open-ephys/ephys-test-board/README.md

# General purpose, automated electrophysiology test board
