open-ephys/ephys-test-board/spice/ad5683_unipolar-to-bipolar_1khz-thd.png

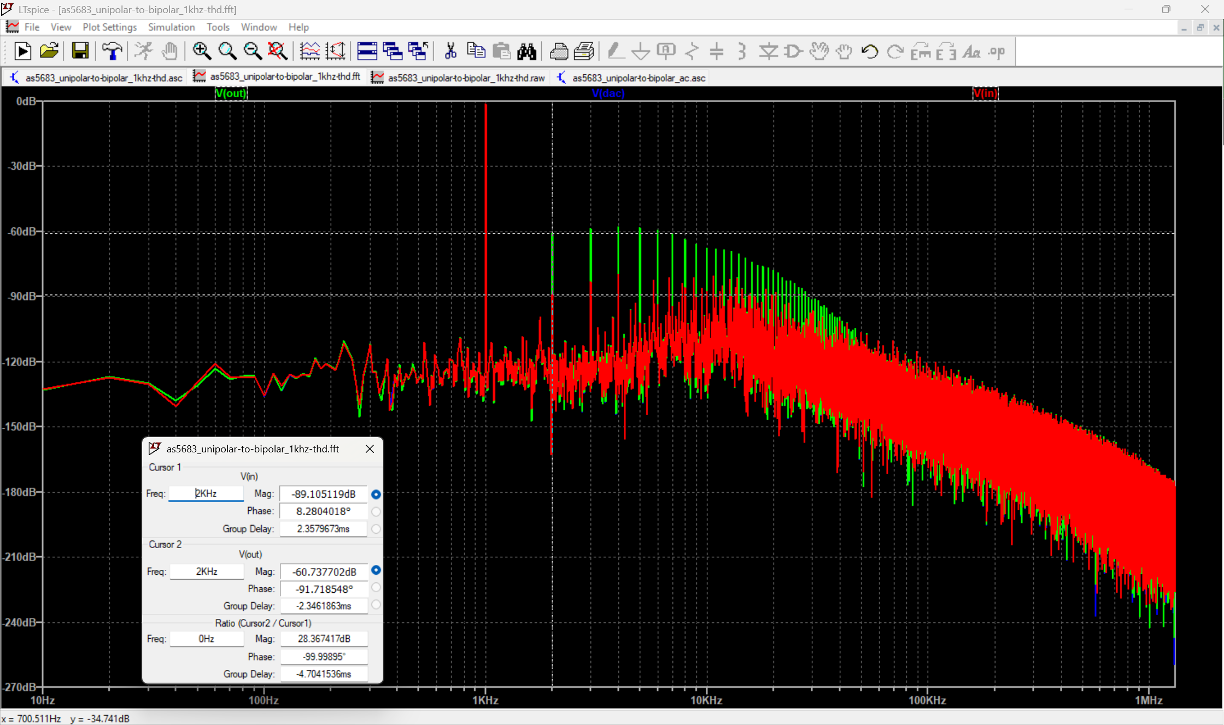
spice/ad5683_unipolar-to-bipolar_1khz-thd.png
