open-ephys/ephys-test-board/spice/ad5683_unipolar-to-bipolar_ac.png

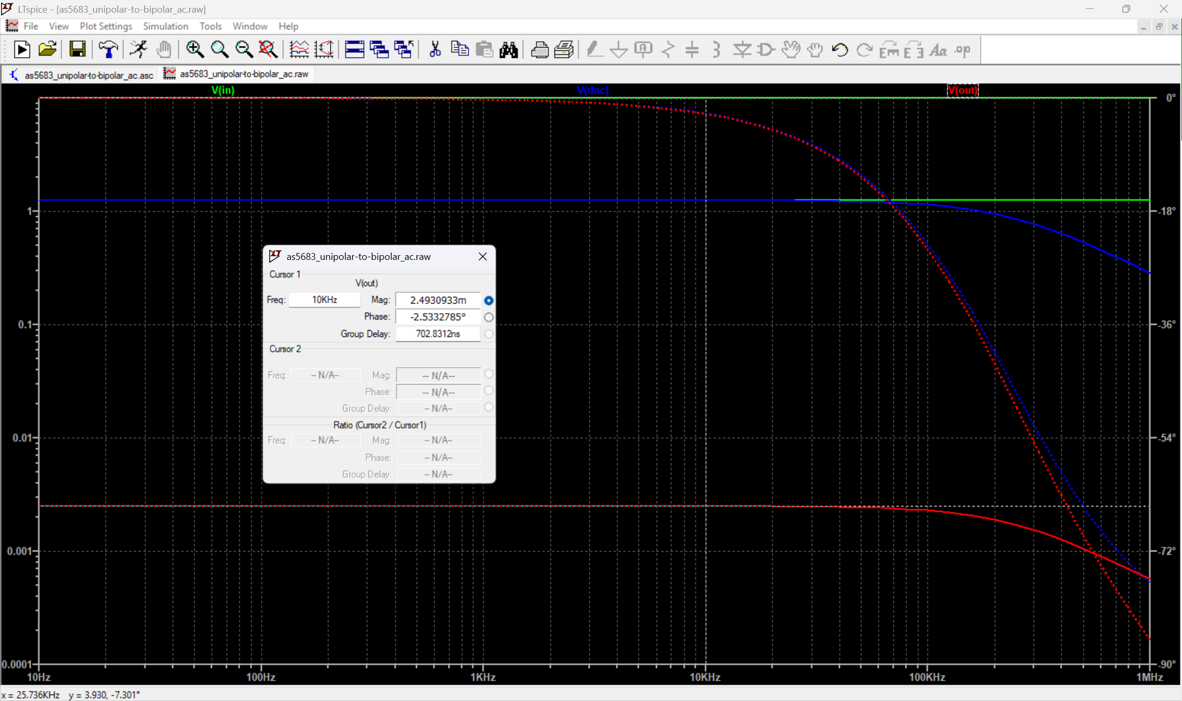
spice/ad5683_unipolar-to-bipolar_ac.png
