open-ephys/ephys-test-board/spice/ad5683_unipolar-to-bipolar_noise.png

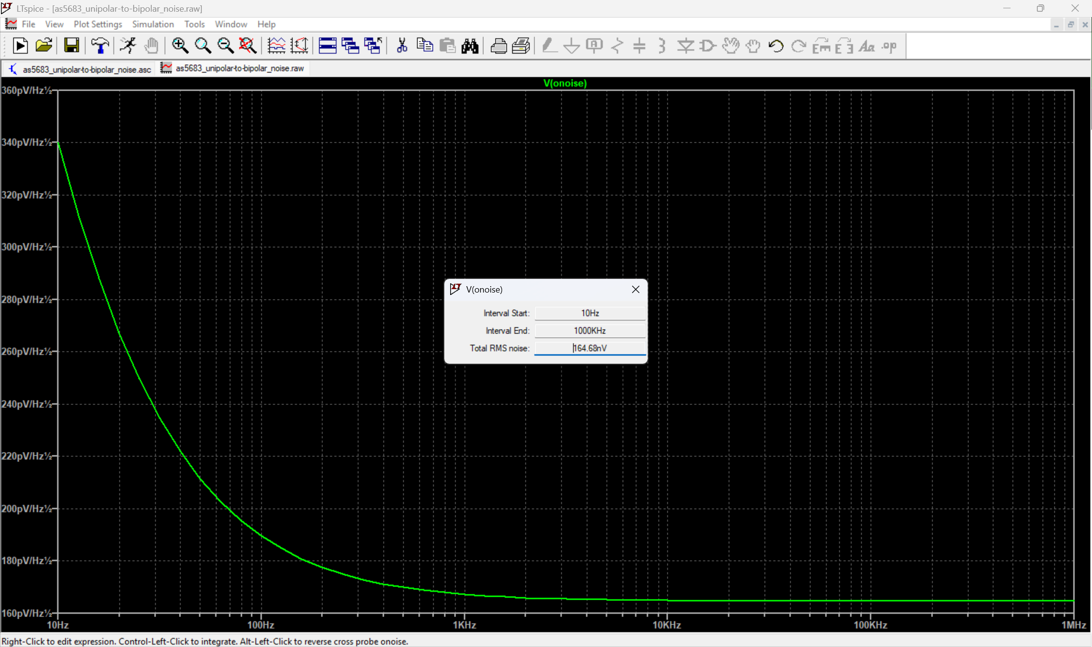
spice/ad5683_unipolar-to-bipolar_noise.png
