open-ephys/ephys-test-board/case/base.SLDPRT

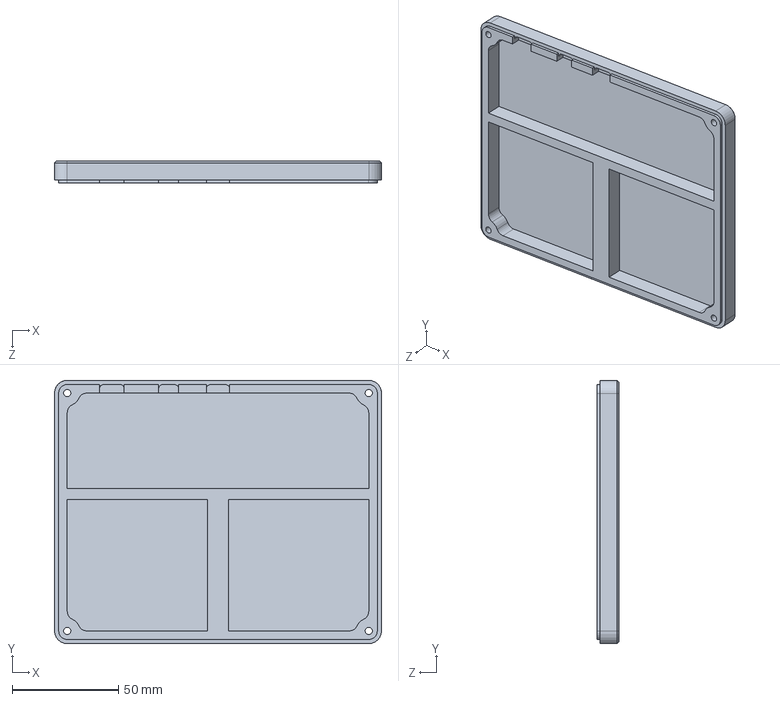
[picture p8: CAD file, 2026-02-26]
case/base.SLDPRT
154.0 x 124.0 x 10.5 mm
