open-ephys/ephys-test-board/case/top.SLDPRT

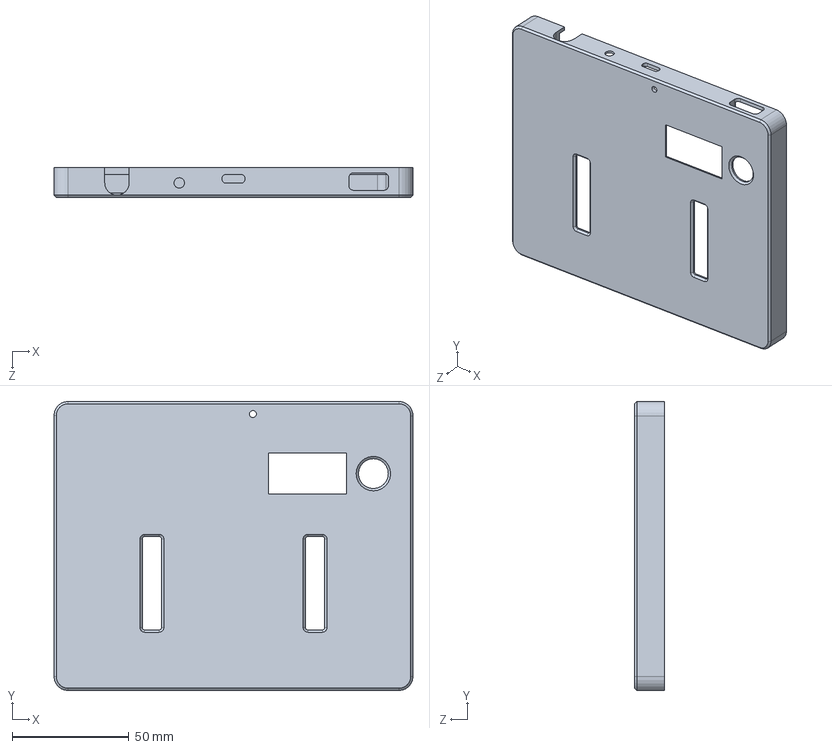
[picture p9: CAD file, 2026-02-26]
case/top.SLDPRT
154.0 x 124.0 x 12.8 mm
