open-ephys/ephys-test-board/case/ACCKMR1316NLT14.stp

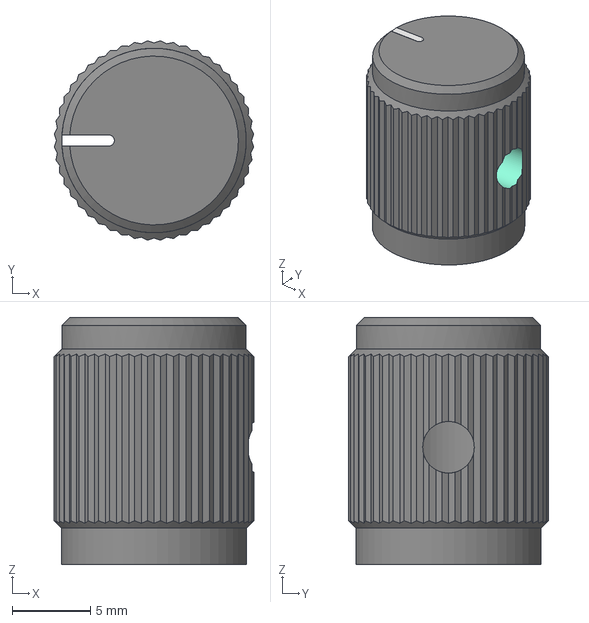
[picture p10: CAD file, 2024-11-14]
case/ACCKMR1316NLT14.stp
12.8 x 12.8 x 15.8 mm
