open-ephys/ephys-test-board/case/92000A116_Passivated 18-8 Stainless Steel Pan Head Phillips Screws.SLDPRT

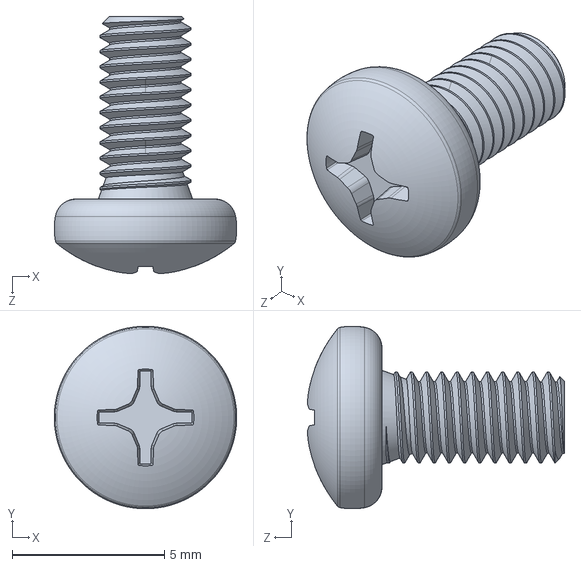
[picture p11: CAD file, 2026-02-26]
case/92000A116_Passivated 18-8 Stainless Steel Pan Head Phillips Screws.SLDPRT
5.99 x 6.00 x 8.45 mm
