open-ephys/ephys-test-board/case/91294A134_Black-Oxide Alloy Steel Hex Drive Flat Head Screw.SLDPRT

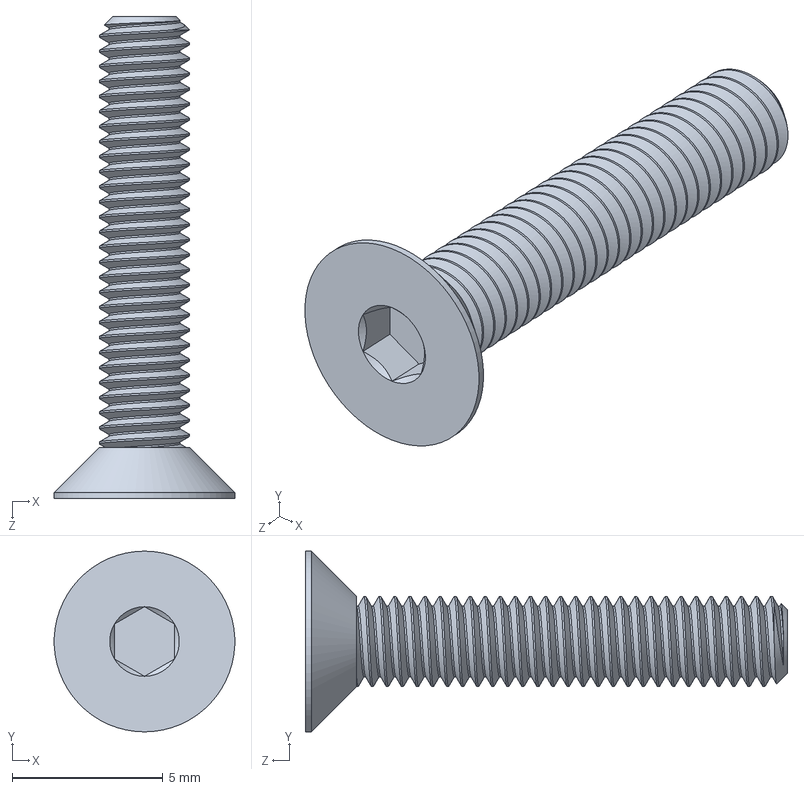
[picture p12: CAD file, 2026-02-26]
case/91294A134_Black-Oxide Alloy Steel Hex Drive Flat Head Screw.SLDPRT
5.99 x 6.00 x 16.0 mm
