open-ephys/ephys-test-board/(list of files, cad)

Other CAD files:
case/stl/base.STL
case/stl/top.STL
case/top-hole-spec.SLDDRW
