open-ephys/ephys-test-board/pcb/how-to-repeat-circuit-motifs-in-kicad/signal-routing_sheet-0.png

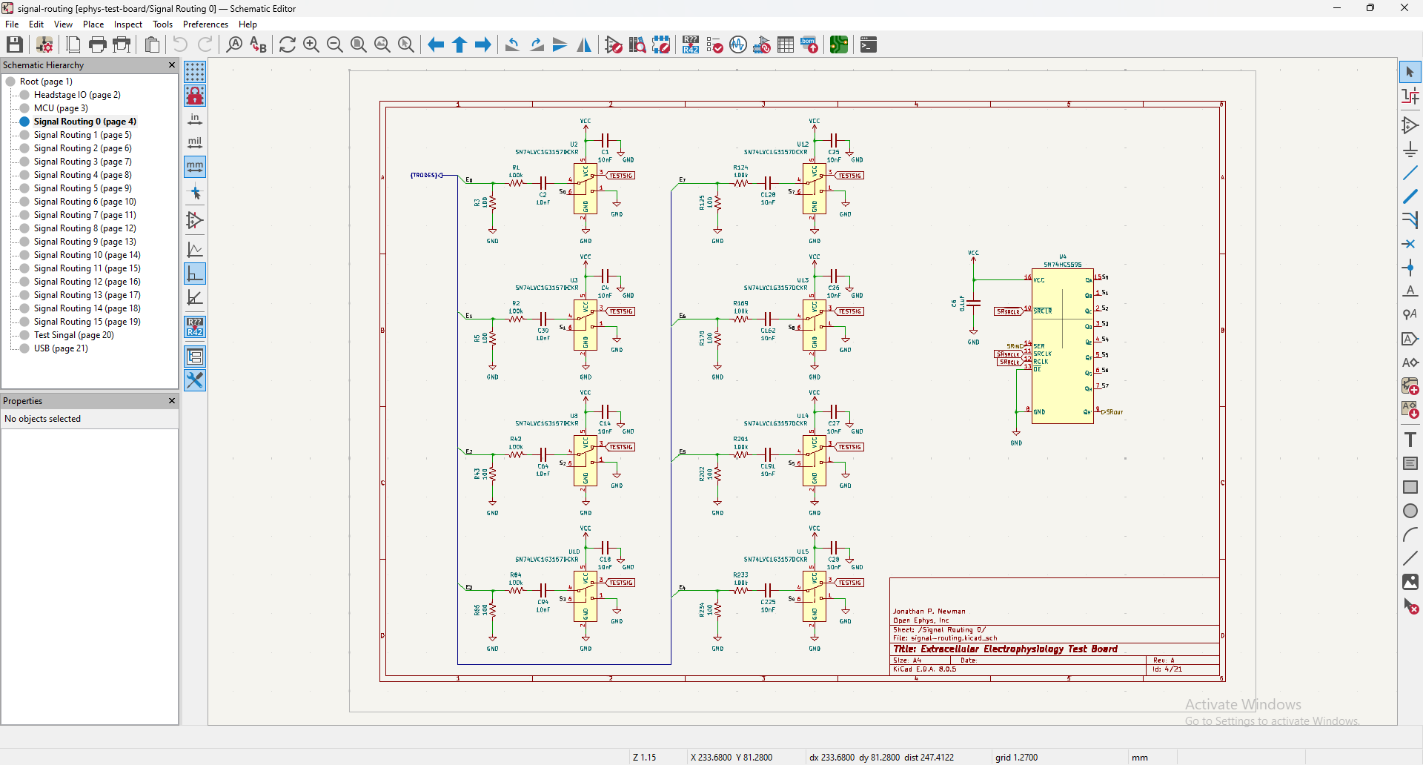
pcb/how-to-repeat-circuit-motifs-in-kicad/signal-routing_sheet-0.png
