open-ephys/ephys-test-board/(threads)

Thread 4 (2024-11-18):

Follow guidelines for MCP73831

jonnew, 2024-11-18:
Page 18 of the [datasheet]() discusses thermals during fast charging of battery. I didn't follow these recommendations for this design.

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

Additionally, the data sheet specifies a required 4.7 uF bypass cap on the VBat pin, which is not currently included in the design.

Closed 2025-02-06.

Thread 6 (2024-12-14):

Reduce weight of CNC enclosure?

cjsha, 2024-12-14:
I appreciate that it won't be tugged around by stiff cables, but the weight might be too much. Not sure how expensive it is to take out that material vs the cost of shipping additional weight (probably not much). Anyway, if you choose to reduce weight, I would leave some material directly underneath the connector so that there is no flex in the PCB when pressure is applied.

Tangentially related but perhaps worth discussing at this point: how should we attribute version/revision to mechanical designs like enclosures? Presumably in the same way we do PCBs.

cjsha, 2024-12-18:
We should mill out material to accommodate the debug header, in case we end up populating it for troubleshooting purposes and end up wanting to put it in a case later, at which point the debug header won't be accessible until the case is removed once again. I add that last clause to clarify that I'm not advocating putting an open slot for the debug header.

Thread 7 (2024-12-14):

Thru-holes for bumpers

cjsha, 2024-12-14:
I propose using bumpers ([example](https://www.mcmaster.com/products/bumpers/bumpers~/unthreaded-hole-bumpers~~/)) for the bottom of the enclosure. You can fasten these using the four mounting holes that are already there.

If we decide to do this, I think it would be better to de-countersink those four mounting holes in the next revision.

Thread 8 (2024-12-17):

Consider USB-C connector with true thru-hole solder joints (not just mating alignment pins)

cjsha, 2024-12-17:

cjsha, 2024-12-17:
This seems to already be fixed in Revision B

cjsha, 2024-12-17:
This was actually fixed in Rev A. I understand now why I thought the USB-C connector didn't have thru-hole solder joints. Those through-hole pads have solder paste in the design:
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
so the stencil lets solder paste fill the thru-hole pads of the USB-C connector. Those holes filled with unmelted solder paste looked like SMD pads to me at which point I created this issue. I'm guessing these USB-C thru-holes must intentionally not have solder paste so that the assembler doesn't have to apply additional solder after applying solder paste with the stencil. This footprint is directly from a KiCAD footprint library.

Closed 2024-12-17.

Thread 9 (2024-12-18):

Battery Status LED flashes momentarily when applying USB power

cjsha, 2024-12-18:
It seems like the battery charger IC allows some current to flow through the battery status LED indicator while the IC is powering on. It seems the IC and LED were wired as suggested by the schematic on the [datasheet](https://ww1.microchip.com/downloads/en/DeviceDoc/20001984g.pdf)'s first page.

Note: this is the behavior when no battery is present. I don't know what it does when the battery is present and if by default these boards are expected to have a battery present. But I would rather not allow rely on a battery being present to achieve a desirable behavior.

jonnew, 2025-01-09:
This is fine and due to battery detection phase as far as I can see. Does not occur when battery is installed.

Closed 2025-01-09.

Thread 11 (2024-12-19):

Ground the case

cjsha, 2024-12-19:

cjsha, 2025-01-06:
The technique mentioned [here](https://github.com/open-ephys/ephys-test-board/issues/12#issuecomment-2571787263) doesn't require this, but depending on grounding technique, we might have to specify a conductive screw type e.g. not black-oxide which are often the cheapest.

There can also be some corrosion when fastening dissimilar metals so we should avoid doing that.

Closed 2025-09-24.

Thread 12 (2024-12-19):

Alleviate the Compression of PCB Between Aluminum Enclosure

cjsha, 2024-12-19:
One way to do this is with an elastic washer.
Another is adding more screws

jonnew, 2025-01-05:
I think that there might be an opportunity for grounding here (#11).

- Put paste layer on the top/bottom of the corner holes, so that there is soft solder layer on both sides
- Add some dimpling/spike features on the top and bottom around the holes.
- Sand these dimples before installation to remove anodization.
- Screw together so that the dimples smash into solder ring

cjsha, 2025-01-06:
That could work. Also, browse this [Digikey page](https://www.digikey.com/en/products/filter/rfi-and-emi-contacts-fingerstock-and-gaskets/945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) for additional ideas.

Closed 2025-04-03.

Thread 13 (2024-12-19):

Enclosure issues

jonnew, 2024-12-19:
- The counterbore for the M3 screw needs to be made bigger in order to comfortably fit the screw head
- The push button has trouble retracting. Not sure what is causing it to catch.
- The debug connector collides with the with the case currently. It can be moved somewhere else.
- The case may actually be _too_ heavy. Consider removing some material.
- Move USB-C connector out by 0.5 mm or make case 0.5 mm thinner.
- Not nearly enough slack in flex cable going to OLED display. Need additional cm.

jonnew, 2025-02-09:
The issue has been broken out into individual issues or completed:

- The counterbore for the M3 screw needs to be made bigger in order to comfortably fit the screw head
  - See #26
- The push button has trouble retracting. Not sure what is causing it to catch.
  - Fixed in #20
- The debug connector collides with the with the case currently. It can be moved somewhere else.
  - Fixed in #20
- The case may actually be too heavy. Consider removing some material.
  - See #6
- Move USB-C connector out by 0.5 mm or make case 0.5 mm thinner.
  - See #25
- Not nearly enough slack in flex cable going to OLED display. Need additional cm.
  - Fixed in #20

Closed 2025-02-09.

Thread 14 (2025-01-05):

Provide a hole in case to access to boot button

jonnew, 2025-01-05:
Can be small so they must use paper clip as it should not be a normal part of use.

jonnew, 2025-03-21:
This is handled via the reset button by linking program against ` pico_bootsel_via_double_reset`

Closed 2025-03-21.

Thread 16 (2025-01-09):

Switch spring is too weak

jonnew, 2025-01-09:
The spring on the currently selected power switch (LC2251EENP) is too weak for the switch and it often gets stuck. I would fine a different part.

Closed 2025-02-06.

Thread 17 (2025-01-10):

OLED Issues

jonnew, 2025-01-10:
The OLED display (part number: MCOT128032CY-WS) has the following pinout:

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

note that this is looking through the FPC, a fact that was not clear until i had it in my hand. This means that pin one is in the bottom right. The connector on the board, of course, has pin 1 starting at the top right of the connector. So pins 1 to 15 on the connector seem to be mapped to 15 down to 1 on the FPC.

In addition to this, the screen is also:

1. Too small. A better alternative, since we are using bare OLED anyway, is [this one](https://www.adafruit.com/product/5228) from Adafruit, especially since there is a nice reference design since the datasheet is pretty bad: https://learn.adafruit.com/adafruit-macropad-rp2040/downloads
2. Awkwardly placed. It would be better to have both the rotary knob and screen at the base on the board, where the user will access with the headstage module plugged in behind that. This is minor enough that I might ignore it though.

Closed 2025-02-06.

Thread 19 (2025-01-11):

Add  !RESET button

jonnew, 2025-01-11:
I want to add a !RESET button to the design.

- If we don't use, its a DNP part and therefore adds no cost
- !RESET can be used to enter BOOT mode without power down by pressing 2x if the firmware that is already on the board is it is linked with the `pico_bootsel_via_double_reset` library. See: https://github.com/raspberrypi/pico-examples/blob/master/system/hello_double_tap/hello_double_tap.c

Closed 2025-02-06.

Thread 22 (2025-02-08):

Pullup resistors on headstage IO I2C bus should be on the module side

jonnew, 2025-02-08:
These resistor (R284 and R285 on current schematic) should be replaced by weak pull downs. This will allow the board to know when a module is inserted and removed. You can use 100k resistors since they are already on the design.

jonnew, 2025-02-09:
Rather than go this route, I wo;; marl the i2c pullups as DNP and add a second, dedicated `Detect` signal that can be pulled down by the module to assert its presence.

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

Closed 2025-03-20.

Thread 25 (2025-02-09):

Move USB-C connector out by 0.5 mm or make case 0.5 mm thinner

jonnew, 2025-02-09:
Currently, a USB cable _just barely_ completely mates before its plastic shell touches the case. There is essentially zero tolerance. Therefore  we need to move USB-C connector out by ~0.5 mm or make case 0.5 mm thinner.

- If this is fixed on the PCB by moving the USB-C connector, it will need to be done in revision C.
- If the case is made thinner without moving the connector, it can be done on Revision B.

Since we are interested in reducing the the weight of the enclosure (#6), I think I prefer not moving this part and just thinning the walls by at least 0.5 mm. For this reason this is currently assigned to Rev. B milestone.

Closed 2025-03-21.

Thread 27 (2025-02-09):

Move SW4 closer to PCB edge

jonnew, 2025-02-09:
The footprint and 3D model used refers to the 8.3 mm length actuator whereas the part number specifies 5.3mm. The land pattern is fine. We want to use 5.8 because it will stick out the back of the case less (this is a reset switch and should not be pressed regularly) and is more common. To accommodate, we need to move the switch closer to the PBC edge.

Closed 2025-03-20.

Thread 29 (2025-02-28):

The OLED's flex connector pin ordering is mirrored

jonnew, 2025-02-28:
The pinout given on the OLEDs datasheet is mirrored compared to that on the Hirose connector.

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

So, the symbol on the schematic needs to be mirrored and the board rerouted to account for the change in connectivity. This is an picture of the symbol in the correct orientation:

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

Closed 2025-03-20.

Thread 30 (2025-03-02):

Reduce electrode test signal input attenuation

jonnew, 2025-03-02:
The DAC can produce 0-2.5V at its output. With the current attenuation of -80 dBV,  this maps 16-bits of resolution over [0 to 250 uV] which is is too low. Attenuation should be reduced to either:

* -60 dBV (1/1000; 0 to 2.5 mV) . Requires 100 ohm resistors to be replaced with 1k 1%.
* -54 dbV (1/500; 0 to 5 mV). Requires 100 ohm resistors to be replaced with 2k 1%.

Thread 31 (2025-03-15):

Bandwidth of electrode input circuit

jonnew, 2025-03-15:
The AC-coupling capacitor following each analog switch along with the attenuation network make an aggressive high pass filter that attenuates frequencies below 100 Hz. The AC coupling capacitor should be moved after the resistor divider to prevent this:

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

jonnew, 2025-03-19:
I confirmed this fix with bodge on rev. B

Closed 2025-03-20.

Thread 34 (2025-03-22):

Different battery dimension for mass production

filcarv, 2025-03-22:
The battery used is Adafruit's [Product ID: 258 ](https://www.adafruit.com/product/258) which has these dimensions: **34mm** x **62mm** x **5mm**. This battery is out of stock.

We found a reliable and deterministic distributor for the Akyga Battery model LP623255, which has slightly different dimensions (**33mm** x **57.5mm** x **6.7mm**). Can we use this battery?

jonnew, 2025-03-26:
Probably. I will need to make the bottom cavity deeper.

jonnew, 2025-03-29:
This battery is fine in terms of its electrical characteristics, but the connector it uses is wire to wire only, as far as I can tell. That means you would need to solder some wire component into the board. I would much prefer using a battery with a connector that can mate to a connector on the board (like the current one). Can you please find another option?

jonnew, 2025-04-03:
Its fine, thanks for the insight. If i was to design again IO might put a cutout for one of these, but they are too large for the current design.

I think the solution is to;

1. Leave the current connection
2. Put some direct solder pads next to it for a direct soldered connection or to put a mating cable on.

Thread 35 (2025-03-22):

Recessed space for label in the case

filcarv, 2025-03-22:
Open Ephys products use a label of 30mm x 50mm with the Open Ephys logo, the SKU, and some legally required information.

Is it possible to add a recessed space somewhere in the case 0.5mm deep and 31mm x 51mm in size? This will be used to add the label.

jonnew, 2025-03-26:
yes should be doable. We should also put some labels on the case, (e.g. on/off), signal input etc. How do you want to do that?

jonnew, 2025-04-01:
A sticker with manufacturing information will go in a recessed position on the bottom of the device. The top should have a printed layer (or laser engraved if the case is made from milled aluminum) with something like the following:

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

- The 30x50 mm recess is now added to the bottom of the case.
- The above design is included in top-silk.pdf.

Closed 2025-04-03.

Thread 36 (2025-03-22):

Low battery detection

filcarv, 2025-03-22:
The device is running from an internal battery, which brings big advantages. We need to make sure that we don't operate the device below the internal nominal voltages,

The devices uses 3.3V from the LDO [AP2112K-3.3TRG1](https://www.diodes.com/assets/Datasheets/AP2112.pdf). The dropout will be below 200mV for sure and since we are being powered from a battery, we might not even consider any noise. Nevertheless, when charging at low voltages, the supply will be noisy and the circuit will suffer for this if working below the LDO's drop out value.

A circuit that shuts down the device when the battery is below a certain voltage may be a good idea. I would suggest using 3.5V has the threshold to shut down the device.

jonnew, 2025-03-25:
Although this is already implemented, the over discharge threshold voltage is indeed too low to be useful (2.8V). We should have a comparator with 3.5V reference to drive enable pin on the LDO.

Closed 2025-04-03.

Thread 37 (2025-03-26):

Case issues

jonnew, 2025-03-26:
- J1 is too tall and rams into case if installed. Its marked DNP and is for debugging though.
- There is not an appropriate cutout for SW4 and its body rams the back of case

Closed 2025-04-03.

Thread 40 (2025-05-13):

Increase screw length

filcarv, 2025-05-13:
We need longer srews for a stable mechanical connection between the top and bottom parts.

- The 92125A132 is 12 mm long.
- Only screws 2.7 mm inside the bottom case.
- We still have 7.0 mm available to screw.

I recommend to replace by a screw with a bigger length by (7 - 2.7 = 4.3) 3.5 or 3 mm, i.e., find a screw with a length of 15.5 or 15 mm.

Closed 2025-05-21.

Thread 41 (2025-06-04):

Full discharge test

jonnew, 2025-06-04:
Because this circuit includes an battery 2.8V under-voltage lockout for charging, there is a possibility of getting the system to a state where no charging can occur if the threshold for protection on the battery is above this level.

Lets say the battery has a under voltage threshold of 3.0V with some hysteresis.

1. Discharge the battery to 3V, the system shuts off and the battery's protection disconnects the anode.
2. Plug in USB to charge, the built in protection senses ~0V at the batteries terminal and therefore the charge circuit is disconnected.
3. The system sits at this equilibrium, non-functional point for eternity

We need to perform a discharge test to ensure this does not happen with our circuit and battery selection.

jonnew, 2025-06-04:
According to @filcarv , its going to be very unpractical to use batteries without internal protection. Thus, the board-level protection circuit should likely be remove and the batteries anode sent to ground.

Thread 42 (2025-06-27):

Firmware feedback from production team

jonnew, 2025-06-27:
- The cycle between channels is too fast. Can you make it 1s for each channel?
- Change the frequency default of the sinewave to 1000 Hz instead of 100 Hz.

jonnew, 2025-07-03:
Fixed in #43

Thread 44 (2025-07-03):

Specify EEPROM data layout

jonnew, 2025-07-03:
We need to document the layout for channel map EEPROM data. Currently, this is the layout:

| ID | Address Range | Description |
| --- | ----------- | --------- |
| MAGIC | 0x00 - 0x09| The ascii character string `"open-ephys"`
| NAME | 0x0A - 0x1D | ASCII character string specifying the name of the modules, padded out to 20 chars. e.g. `"Hirose DF40 64 Ch.  "`[^1]
| PCB_REV | 0x1E | Single ASCII character indicating indicating PCB revision. e.g. `'A'`
| NUM_CHAN | 0x1F| Single `uint8_t` specifying the number of channels in the channel map
| CHAN_MAP | 0x20 - 0x20 + NUM_CHAN| A `uint8_t[NUM_CHAN]` containing the channel map

I propose the following, revised layout:

| ID | Address Range | Description |
| --- | ----------- | --------- |
| MAGIC | 0x0000 - 0x0009| The ascii character string `"open-ephys"`
| NAME | 0x000A - 0x001D | ASCII character string specifying the name of the modules, padded out to 20 chars. e.g. `"Hirose DF40 64 Ch.  "`
| PCB_REV | 0x001E | Single ASCII character indicating indicating PCB revision. e.g. `'A'`
| LAOUT_VER | 0x001F-0x0020 | Major.Minor version number of the EEPROM layout (e.g. this specification will be 1.0)
| NUM_MAPS | 0x0021 | A single `uint8_t` specifying the number of maps
| RESERVED | 0x022-0x03FF| Reserved
...
| NUM_CHAN_0| 0x0400 | Single `uint8_t` specifying the number of channels in channel map 0[^2]
| CHAN_MAP_0 | 0x0401 - 0x0400 + NUM_CHAN_0| A `uint8_t[NUM_CHAN_0]` containing  channel map 0
...
| NUM_CHAN_1| 0x0800| Single `uint8_t` specifying the number of channels in channel map 1[^2]
| CHAN_MAP_1 | 0x0801 - 0x0800 + NUM_CHAN_1| A `uint8_t[NUM_CHAN_1]` containing channel map 1
...
| NUM_CHAN_<NUM_MAPS - 1> | 0x0400 * (NUM_MAPS - 1)| Single `uint8_t` specifying the number of channels in channel map NUM_MAPS - 1[^2]
| CHAN_MAP_<NUM_MAPS - 1> | 0x0400 * (NUM_MAPS - 1) + 1 - 0x0400 * (NUM_MAPS - 1) + NUM_CHAN_<NUM_MAPS - 1> | A `uint8_t[NUM_CHAN_<NUM_MAPS - 1>]` containing channel map NUM_MAPS - 1

[^1]: Limited to 20 chars to force the text to fit in the screen
[^2]: Must be 128 or less for this hardware, so this will fit into single byte.

@filcarv and @aacuevas if you have additional ideas, corrections, or comments please document them here.

jonnew, 2025-07-04:
Thanks for the feedback. @aacuevas I edited the table to account for your comment. @filcarv 8kB EEPROM will be able to hold 1 metadata block and 7 channel maps as each section takes 1 kB.

Thread 46 (2025-07-04):

Somehow, let the user know in the screen that the battery needs to be recharged

filcarv, 2025-07-04:
In order to do so, we need to read the battery level via a microcontroller ADC input. A resistor divider can bring the battery voltage down to the ADC range.

Closed 2025-07-11.

Thread 56 (2025-09-25):

OLED Charging Lightning Indicator Remains After Disconnecting Charging USB

cjsha, 2025-09-25:
If I turn on the ephys test board while the USB is plugged in, the OLED correctly indicates that it's charging. If I unplug the USB from ephys test board while it's on, the lightning symbol in the OLED stays instead of reverting to the battery symbol.

jonnew, 2025-09-26:
I think this might only apply to the initial menu when the user is selecting a channel map. I can reproduce in that case. I will look into a fix for that because I understand it. If its occurring outside of this situation, Ill need a more complete description of when its happening because I cannot reproduce.
