open-ephys/ephys-test-board/pcb/ephys-test-board.pdf

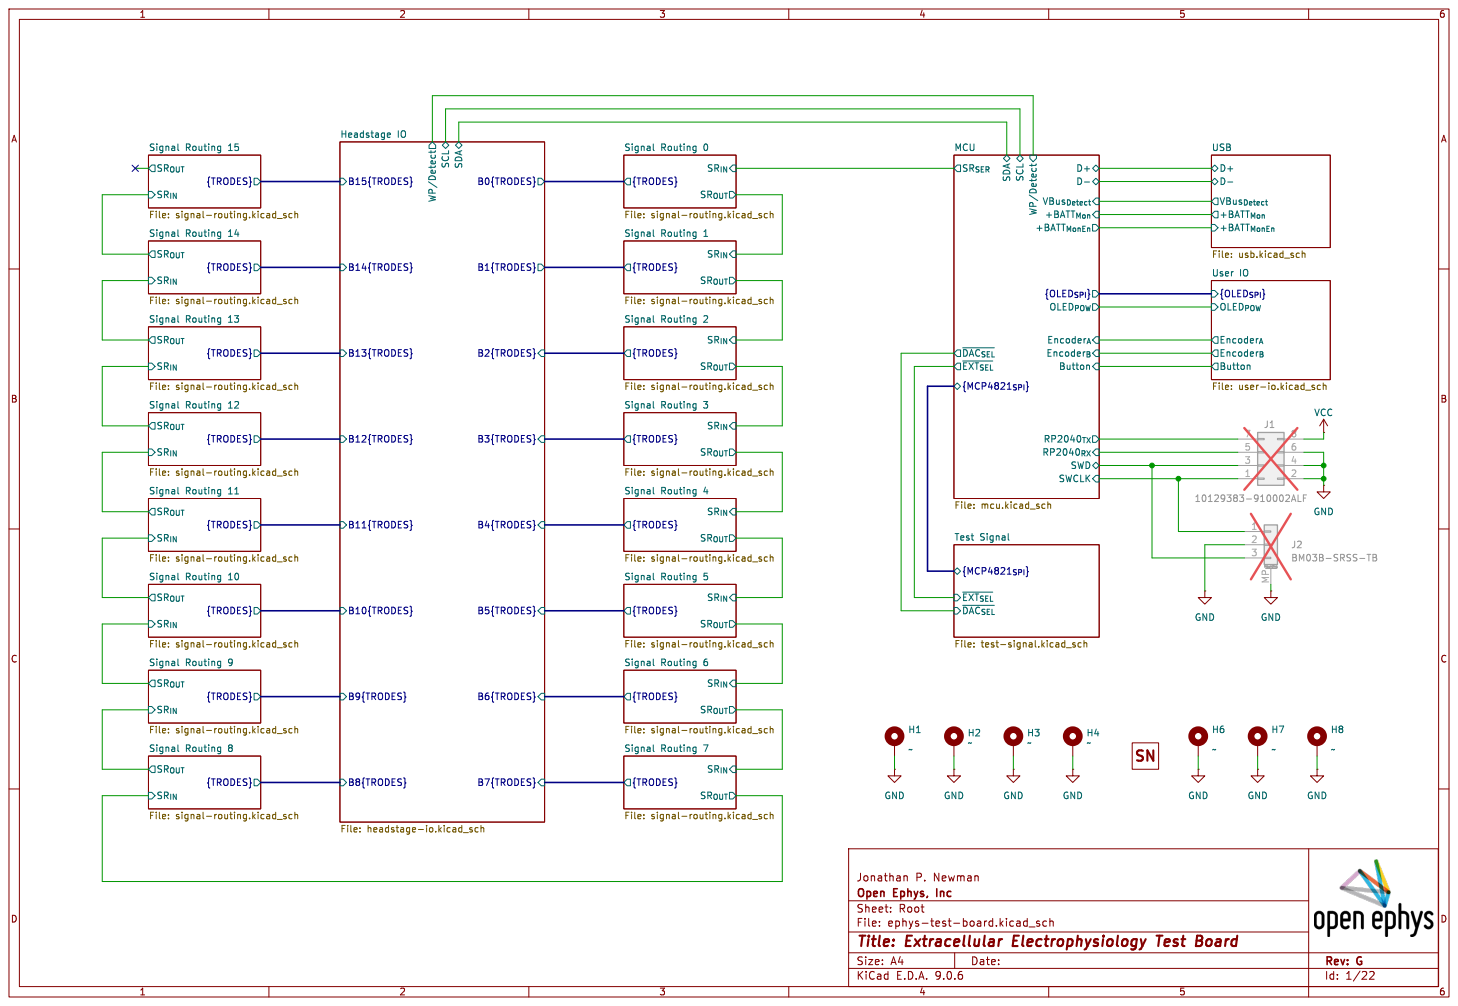
[picture p21: page 1]

Signal Routing 15 File: signal-routing.kicad_sch

Signal Routing 0 File: signal-routing.kicad_sch

+BATT_{MonEn} MCU
{OLED_{SPI}} Button VBus_{Detect} SDA SCL

Signal Routing 14 File: signal-routing.kicad_sch

Encoder_{B} Button OLED_{POW} User IO

Signal Routing 13 File: signal-routing.kicad_sch

Signal Routing 2 File: signal-routing.kicad_sch

SR_{OUT}
File: user-io.kicad_sch SR_{OUT}

Signal Routing 12 File: signal-routing.kicad_sch

Signal Routing 3 File: signal-routing.kicad_sch

Signal Routing 11 File: signal-routing.kicad_sch

Signal Routing 4 File: signal-routing.kicad_sch

~{DAC_{SEL}} Test Signal File: test-signal.kicad_sch

Signal Routing 10 File: signal-routing.kicad_sch

Signal Routing 5 File: signal-routing.kicad_sch

Signal Routing 9 File: signal-routing.kicad_sch

Signal Routing 6 File: signal-routing.kicad_sch

Signal Routing 8 File: signal-routing.kicad_sch

Signal Routing 7 File: signal-routing.kicad_sch

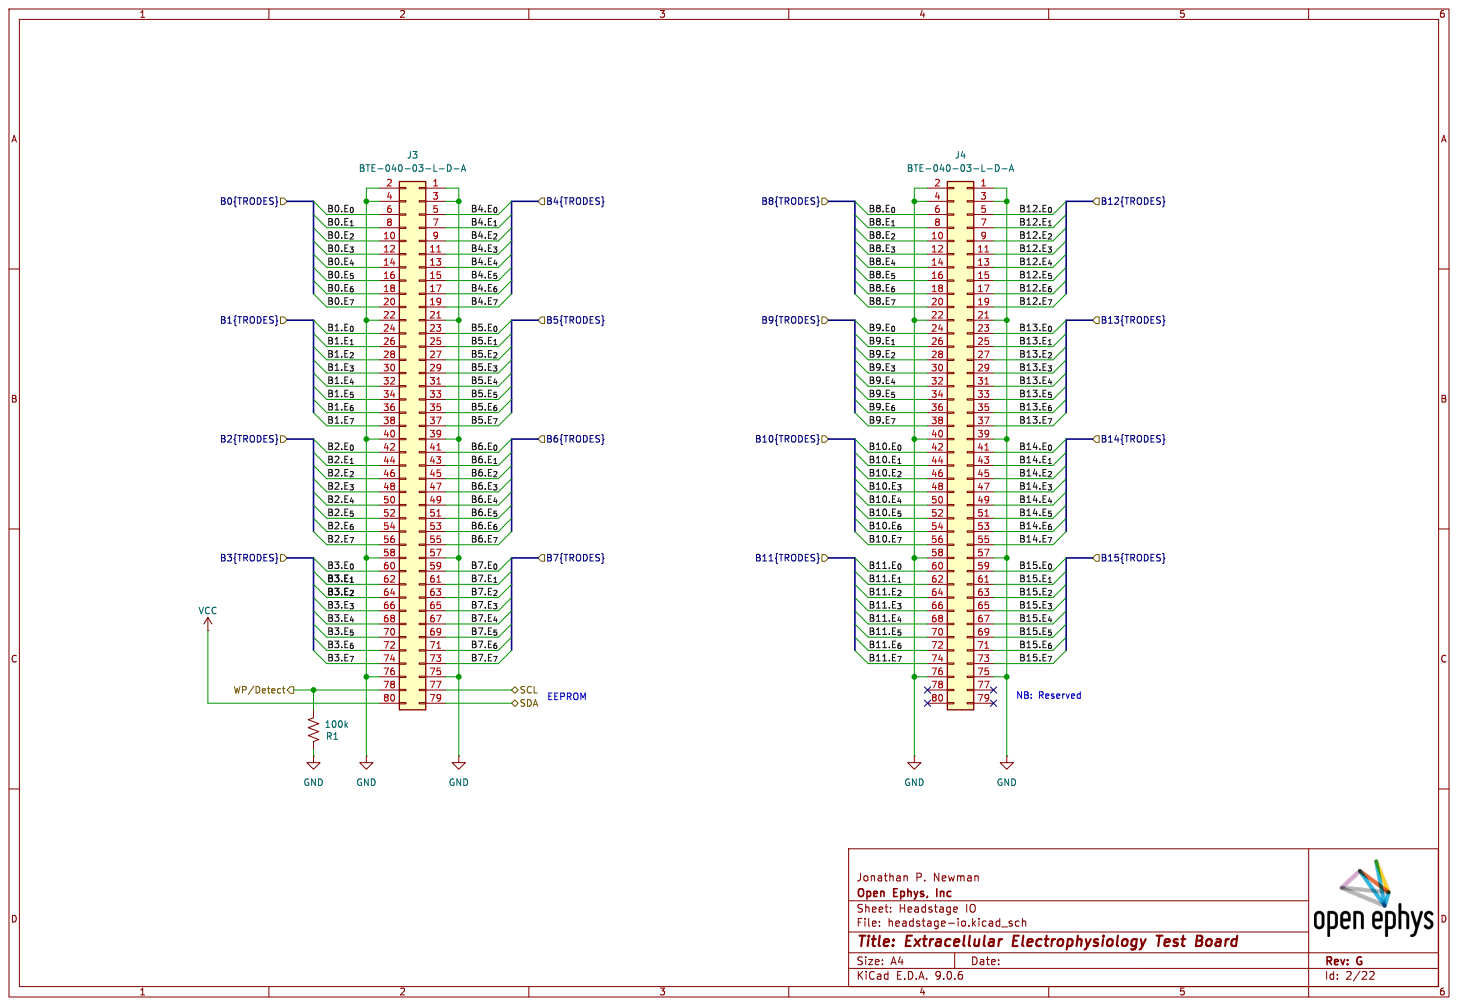
[picture p22: page 2]

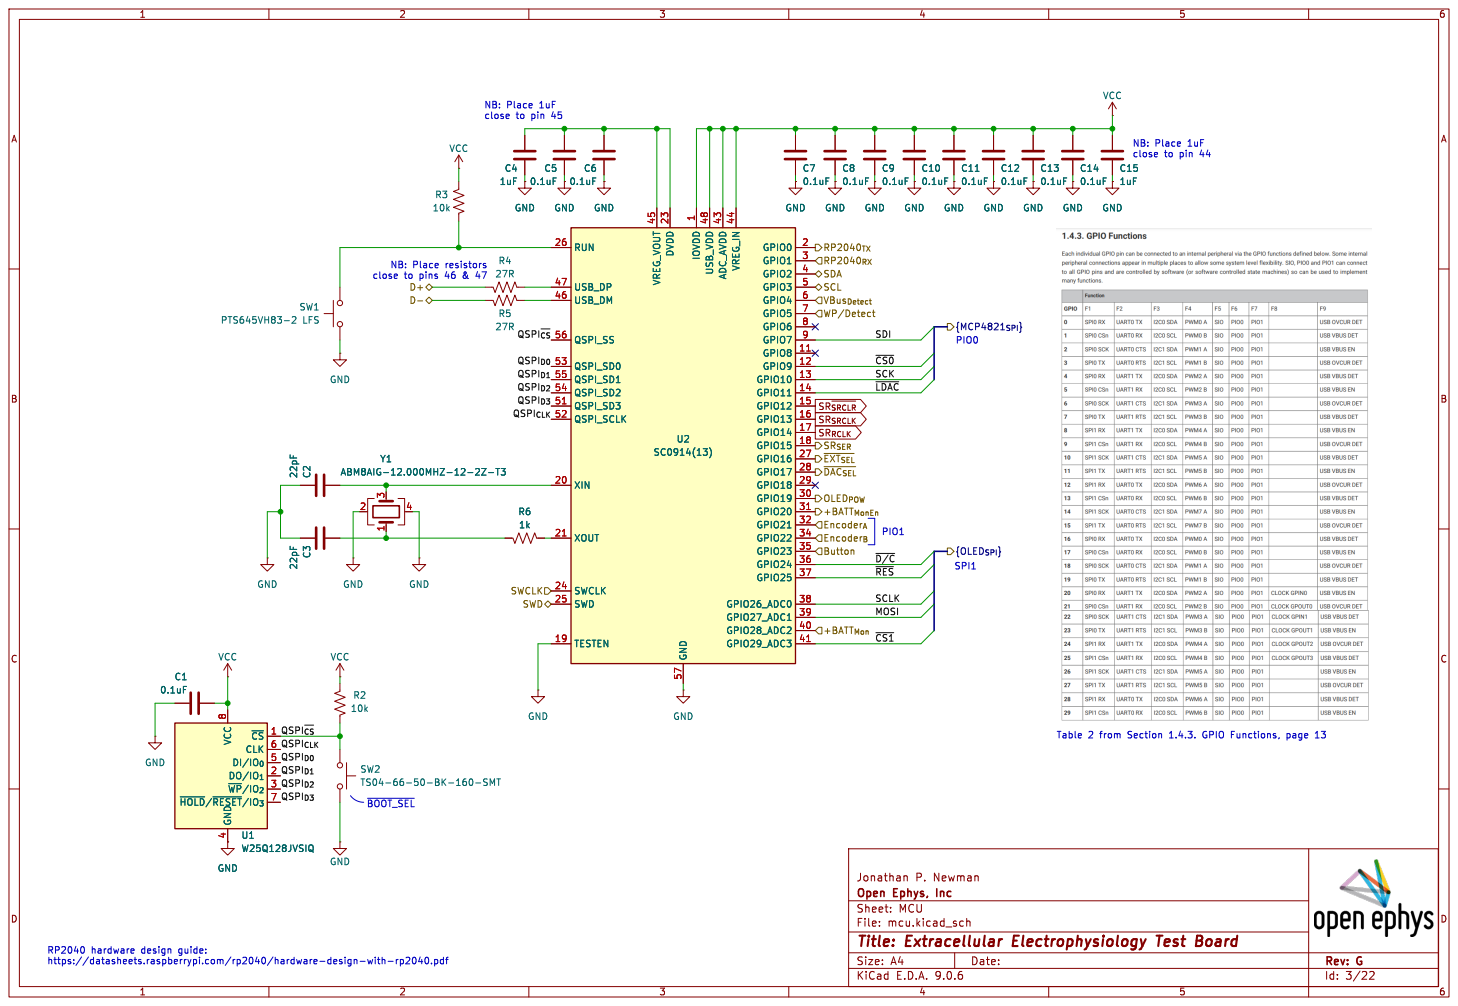
[picture p23: page 3]

close to pin 44 NB: Place resistors

close to pins 46 & 47 GND

Encoder_{A} SDA RP2040_{RX}
VBus_{Detect} SCL WP/Detect +BATT_{MonEn}

https://datasheets.raspberrypi.com/rp2040/hardware-design-with-rp2040.pdf

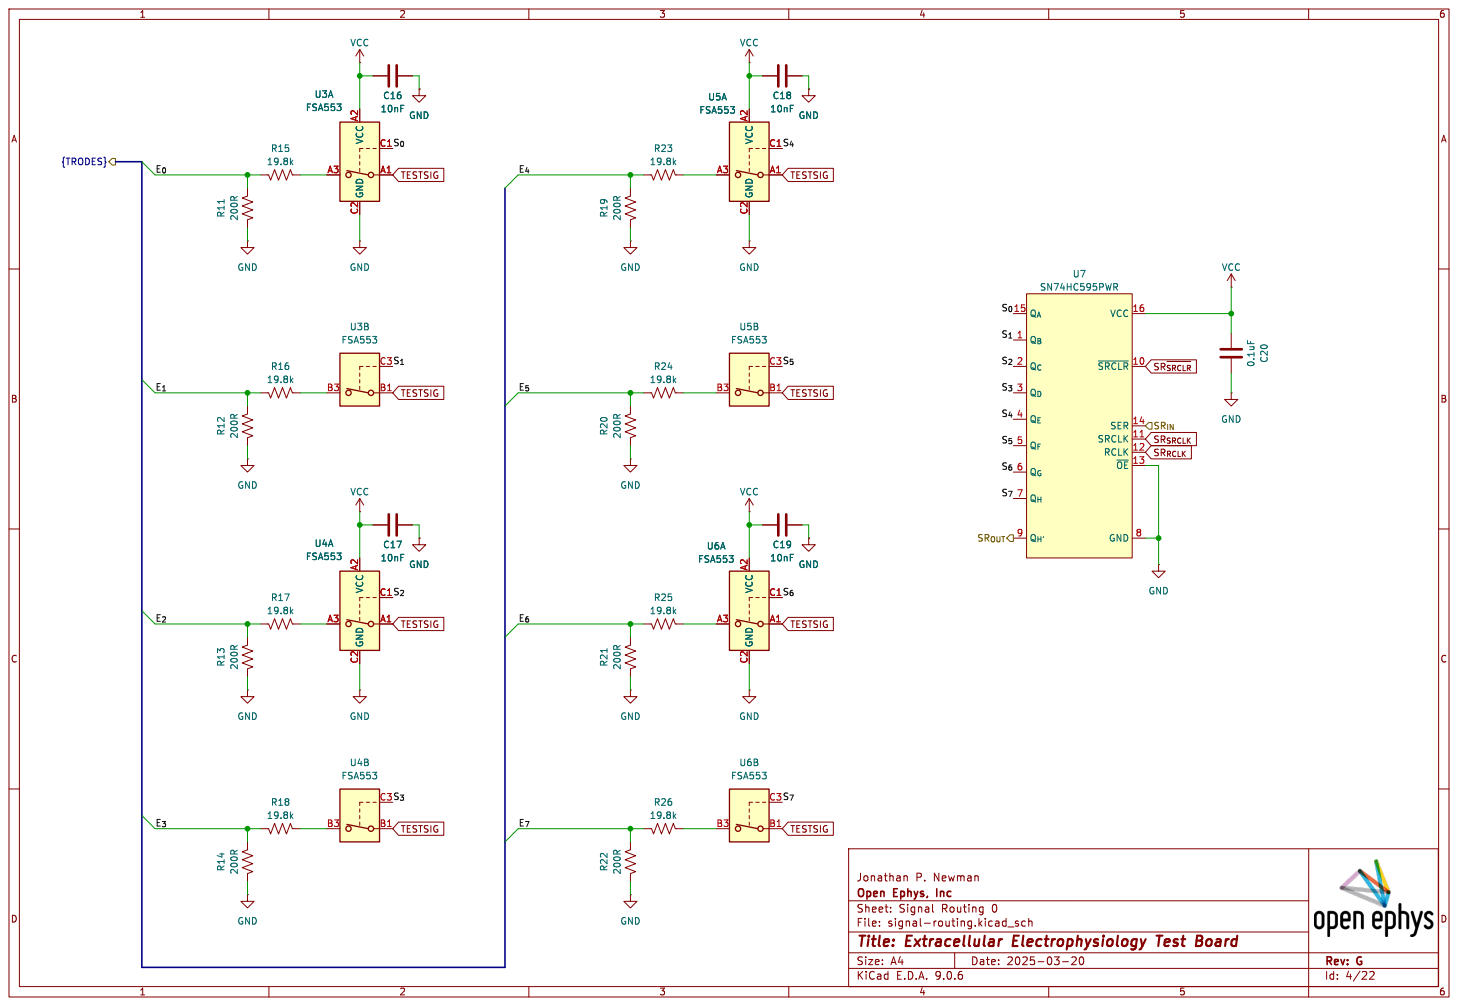
[picture p24: page 4]

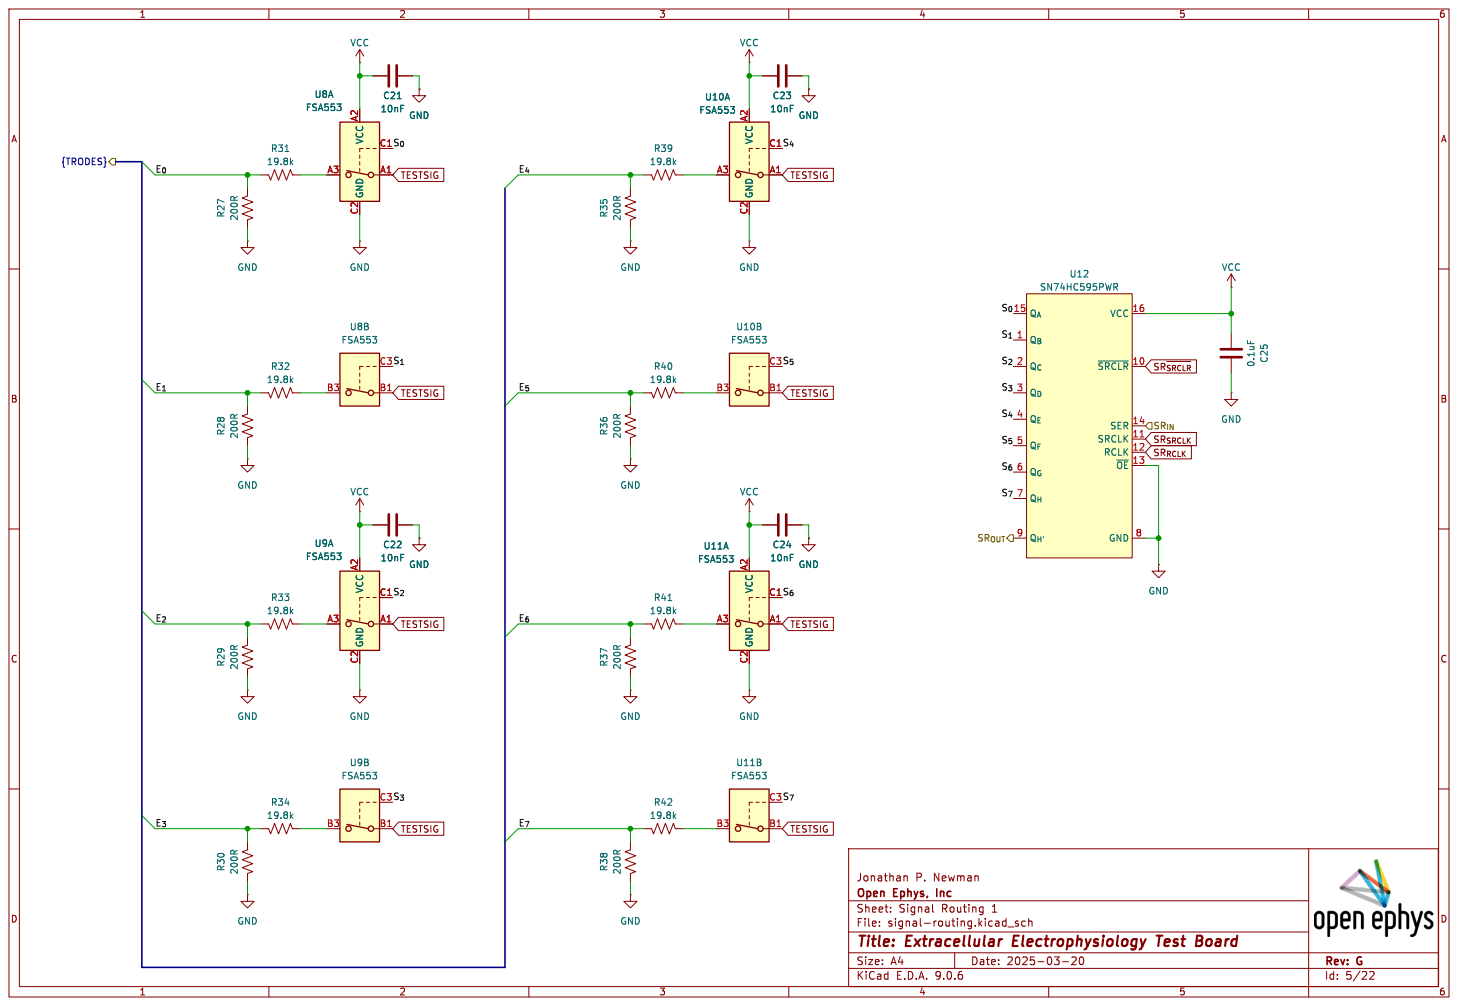
[picture p25: page 5]

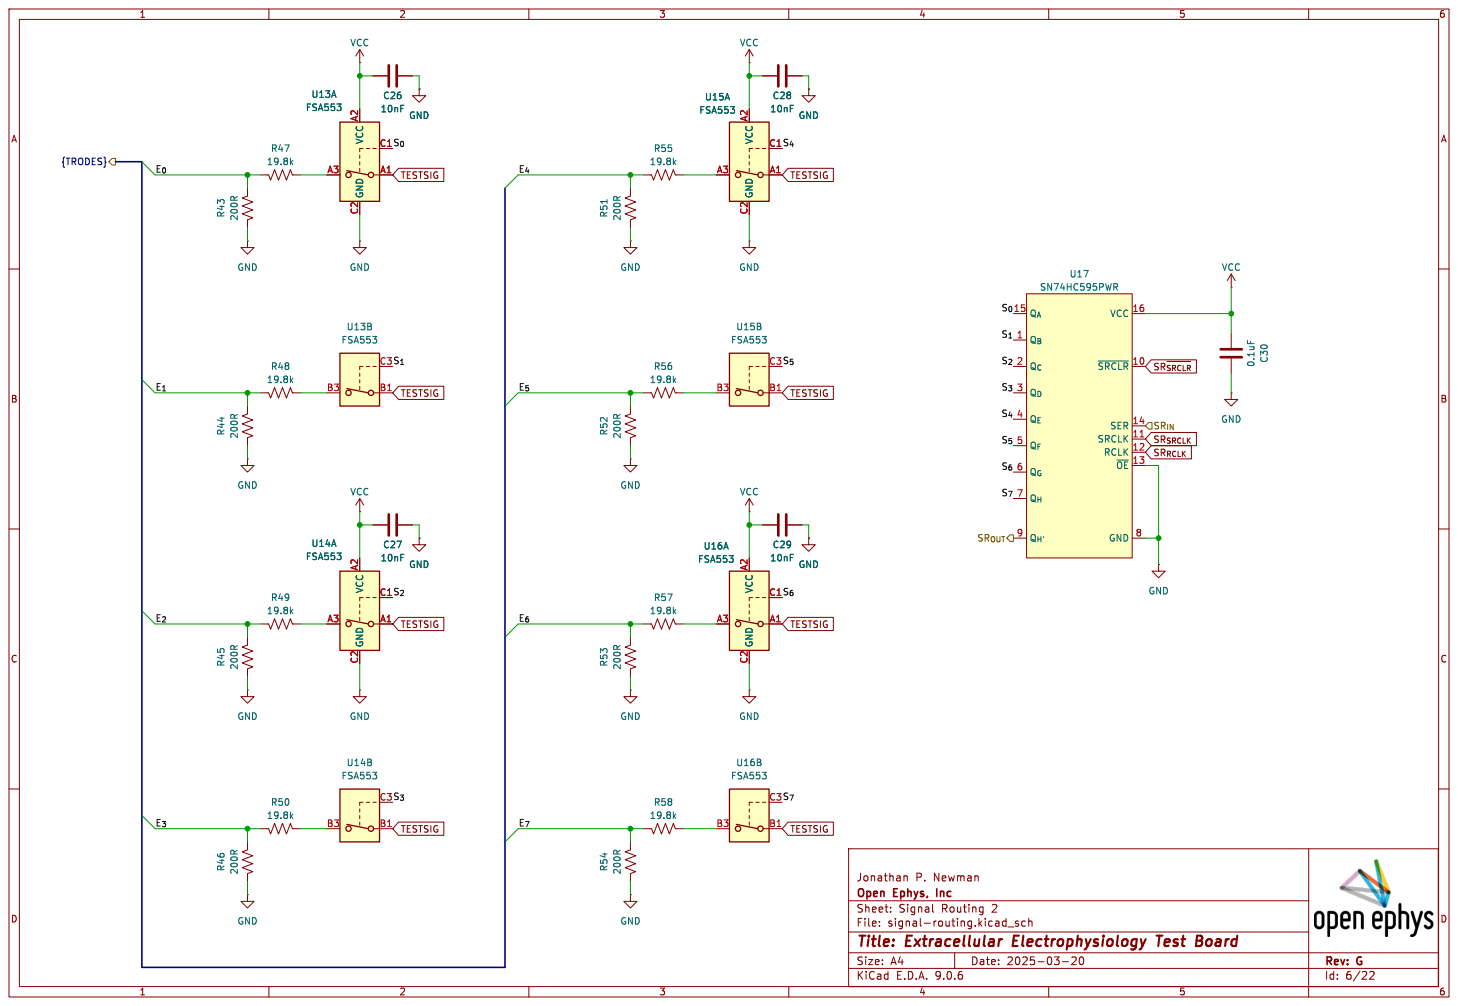
[picture p26: page 6]

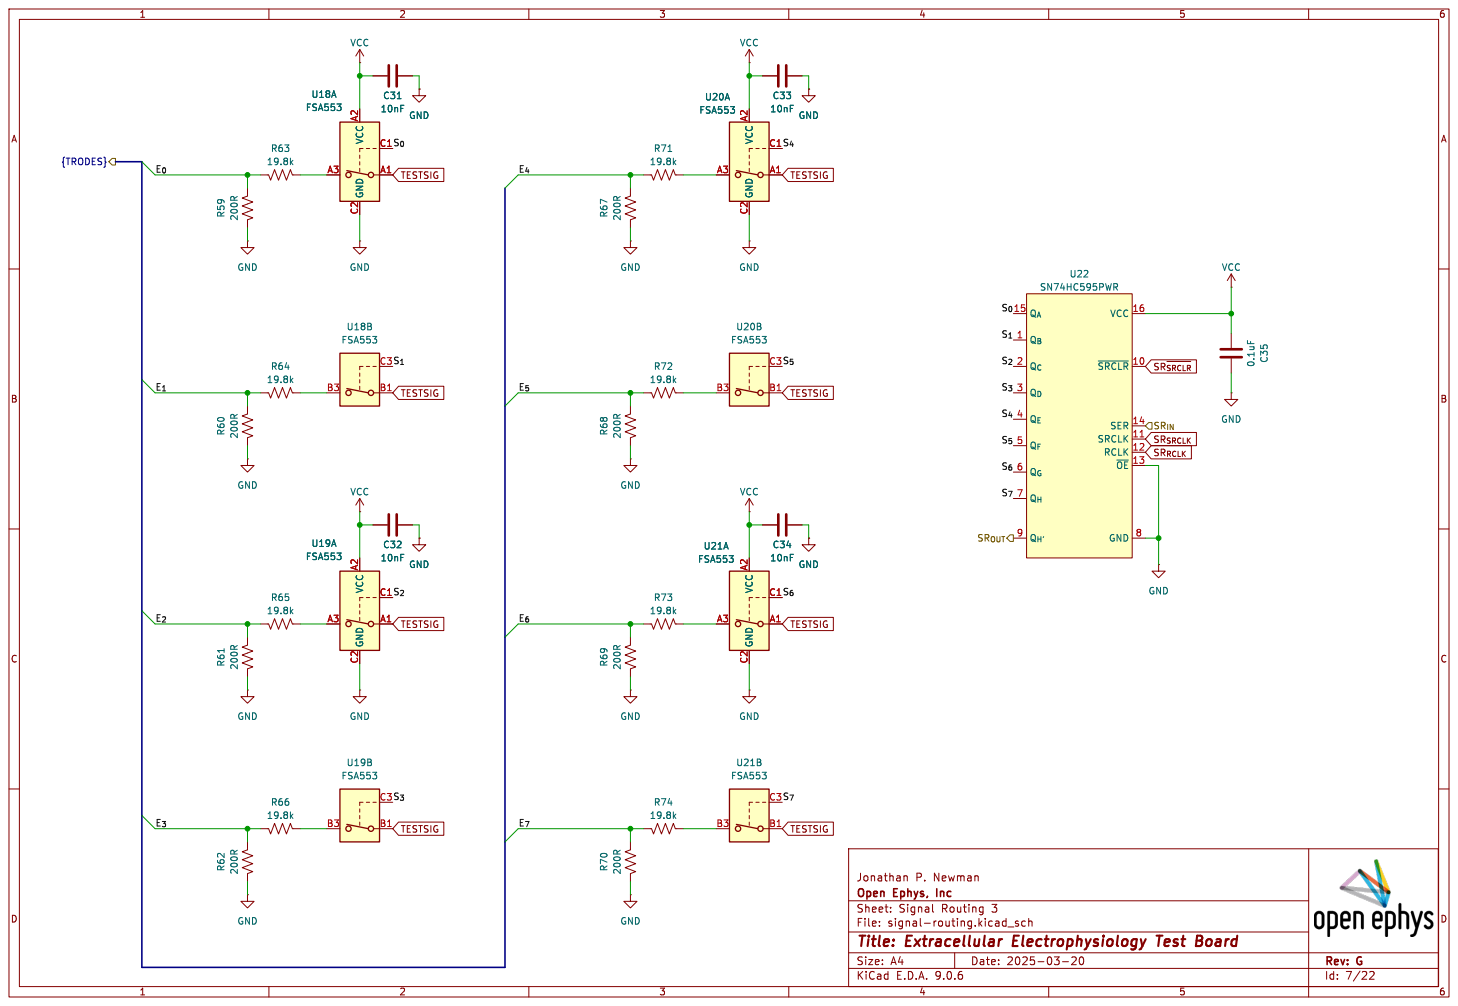
[picture p27: page 7]

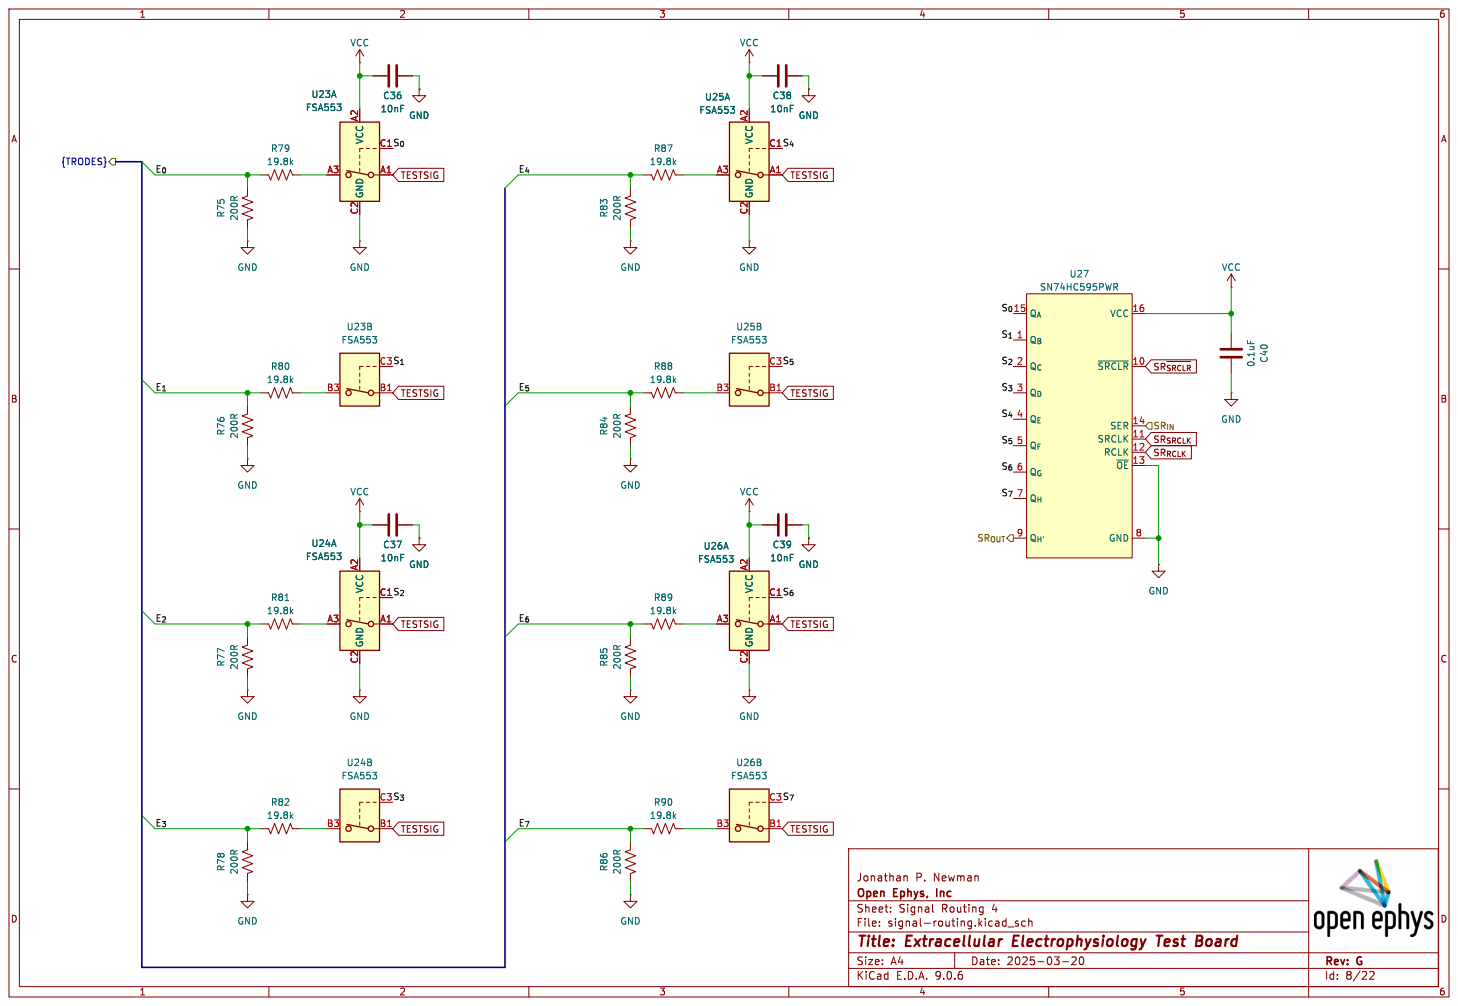
[picture p28: page 8]

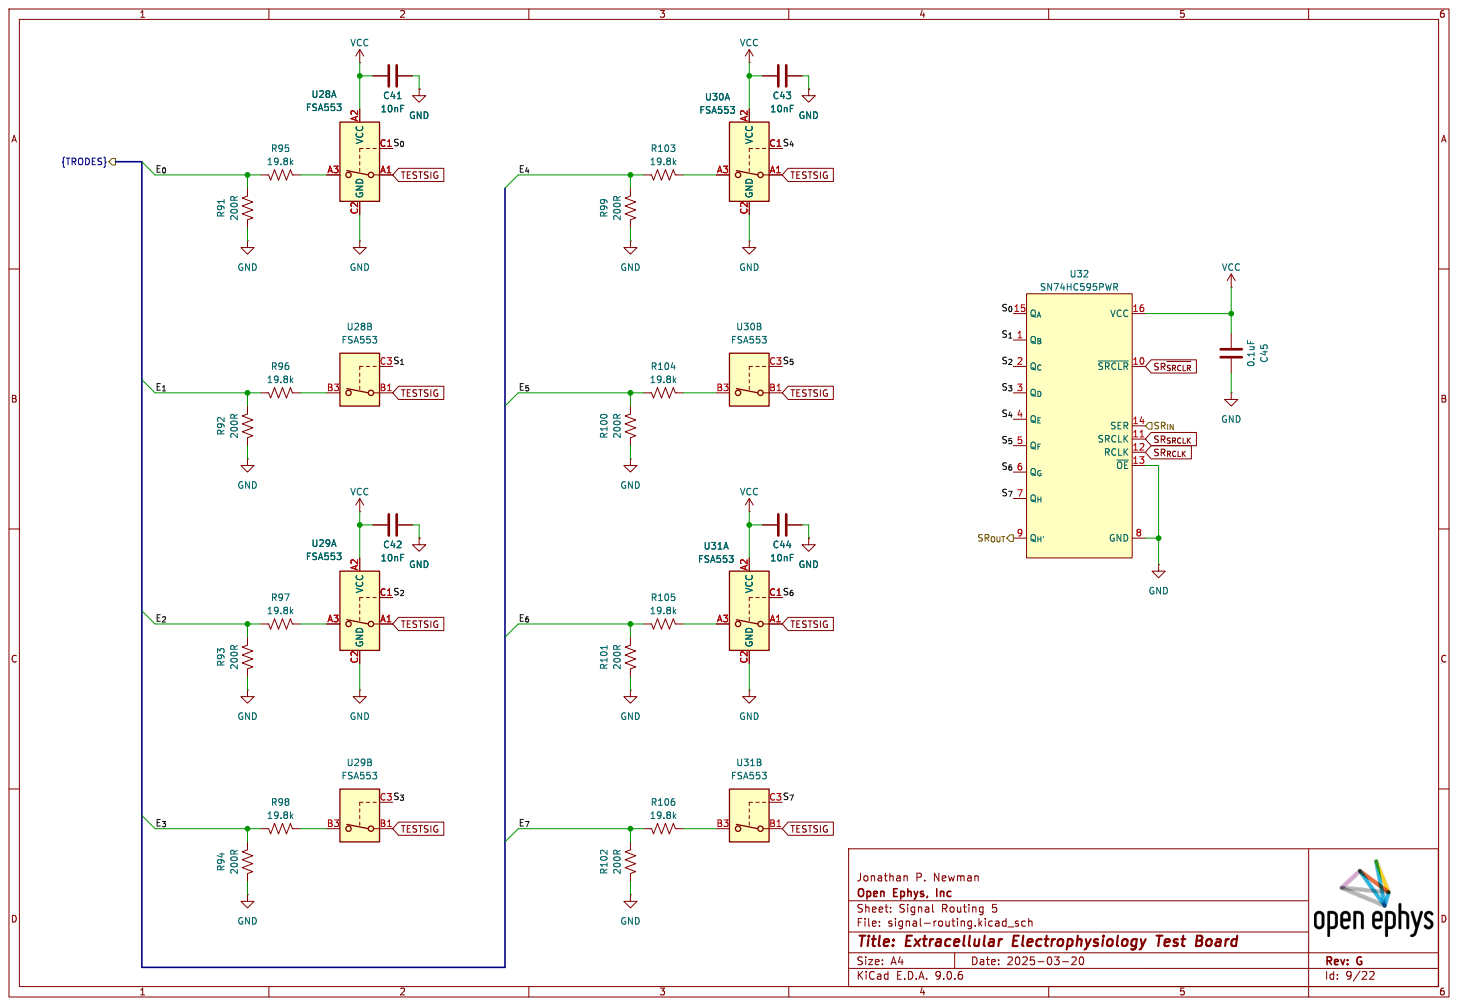
[picture p29: page 9]

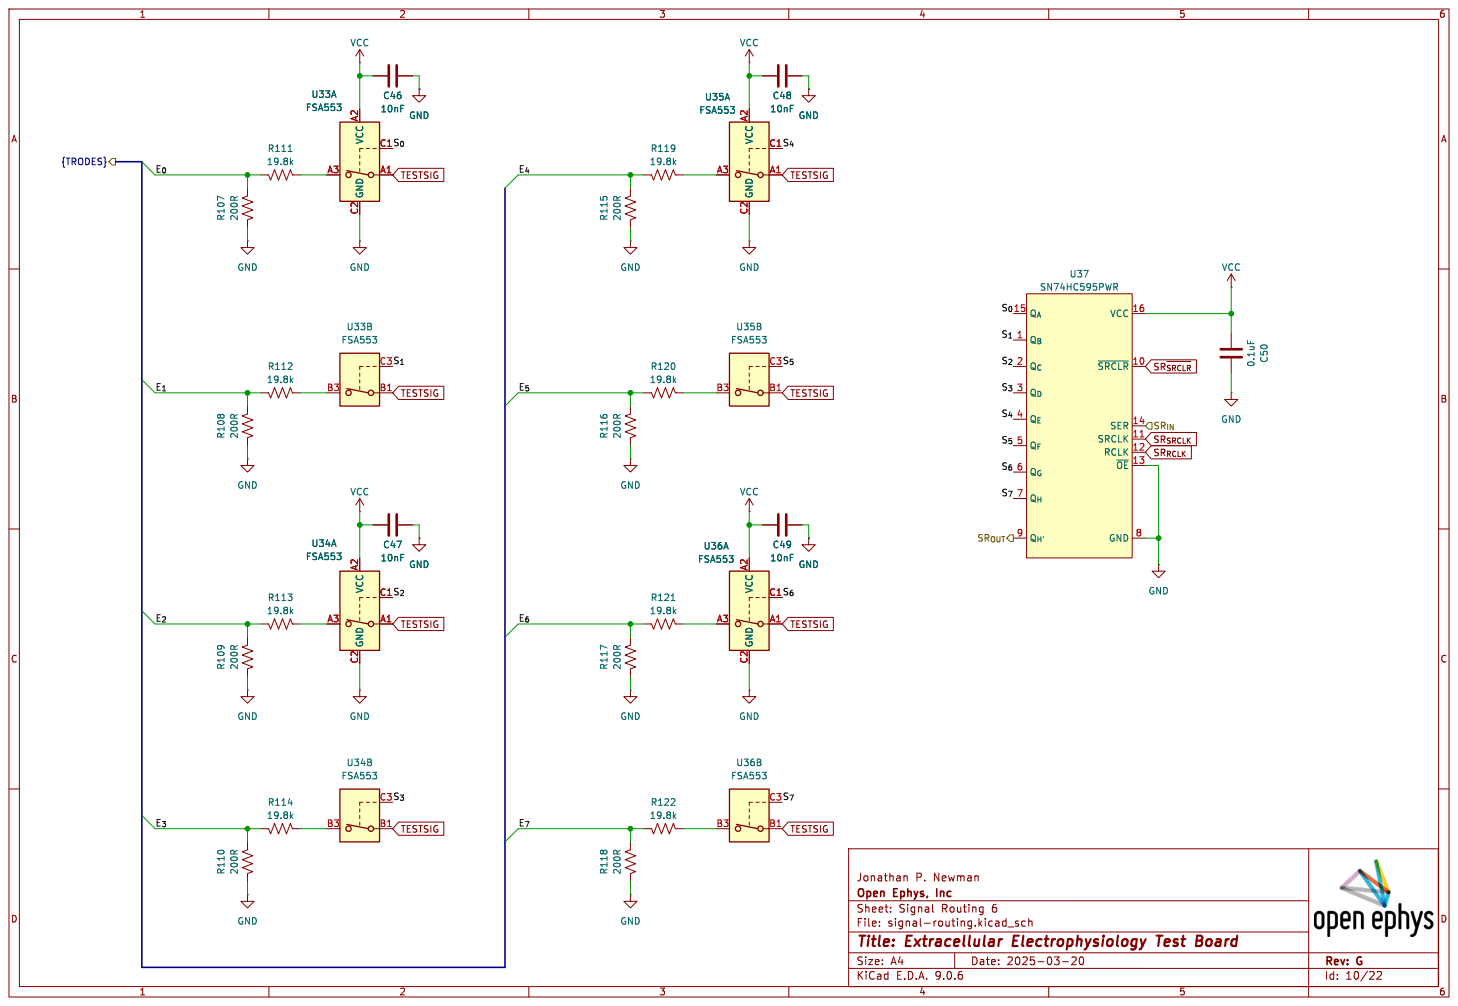
[picture p30: page 10]

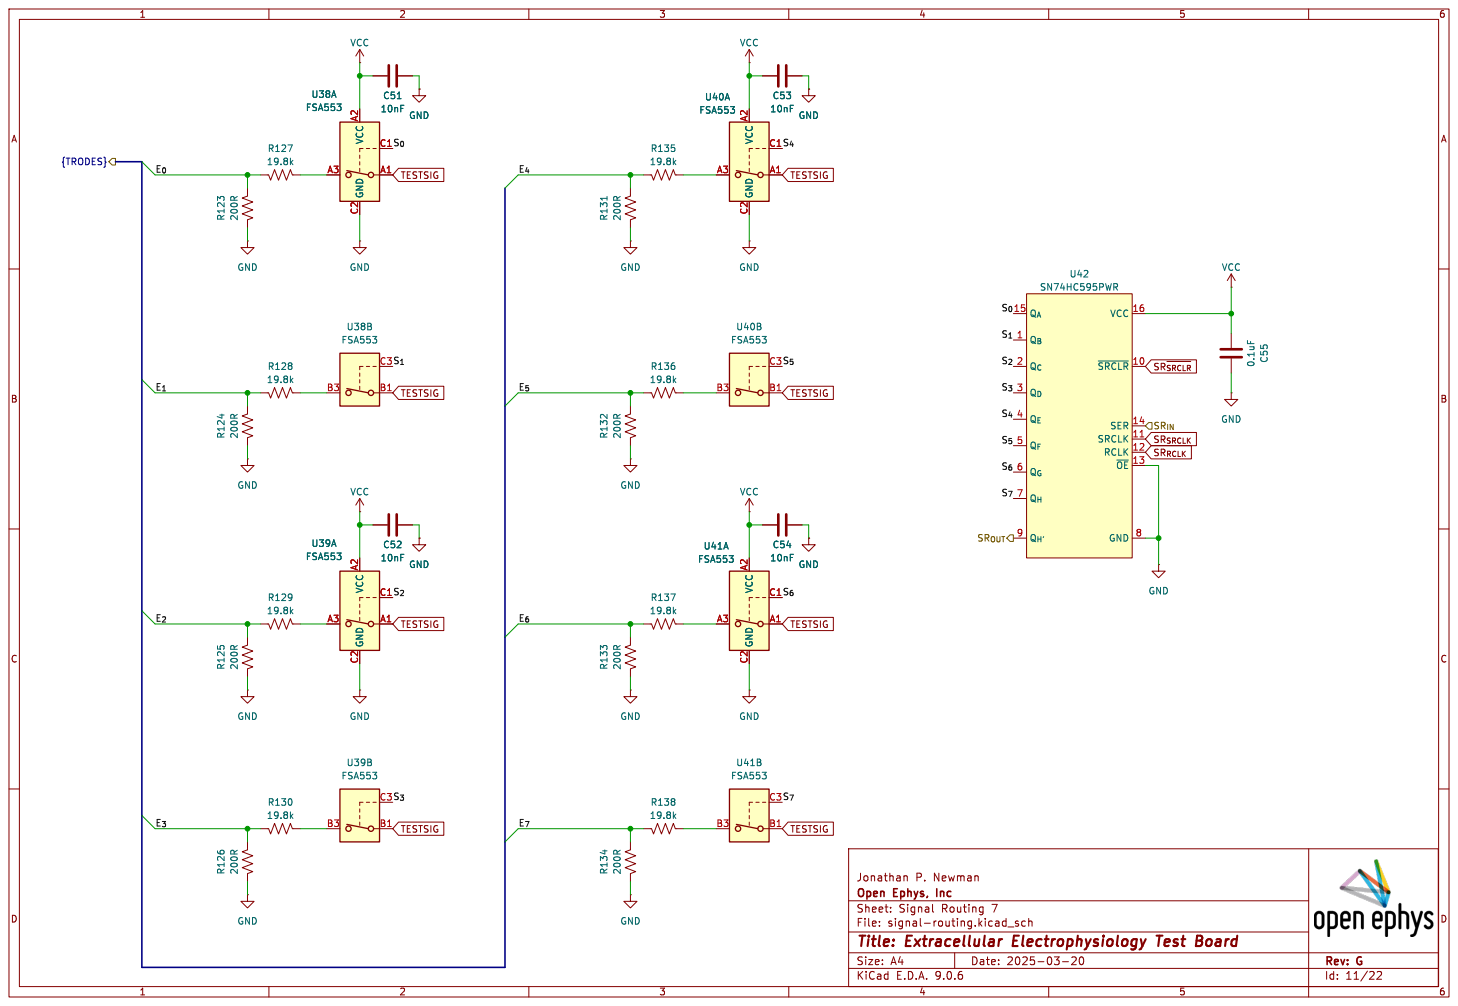
[picture p31: page 11]

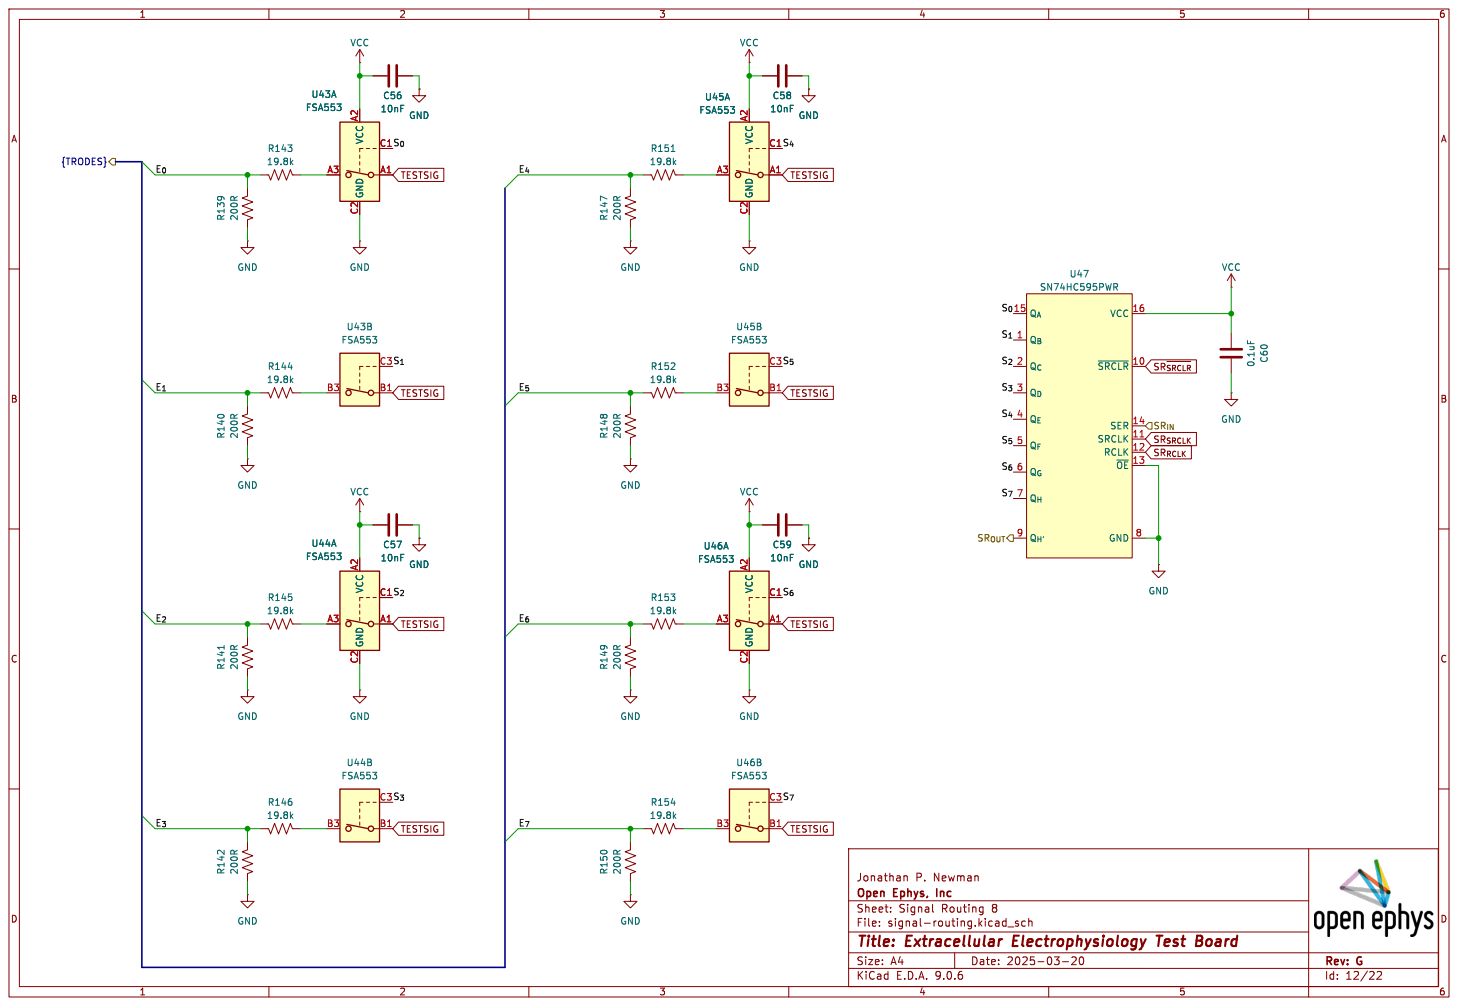
[picture p32: page 12]

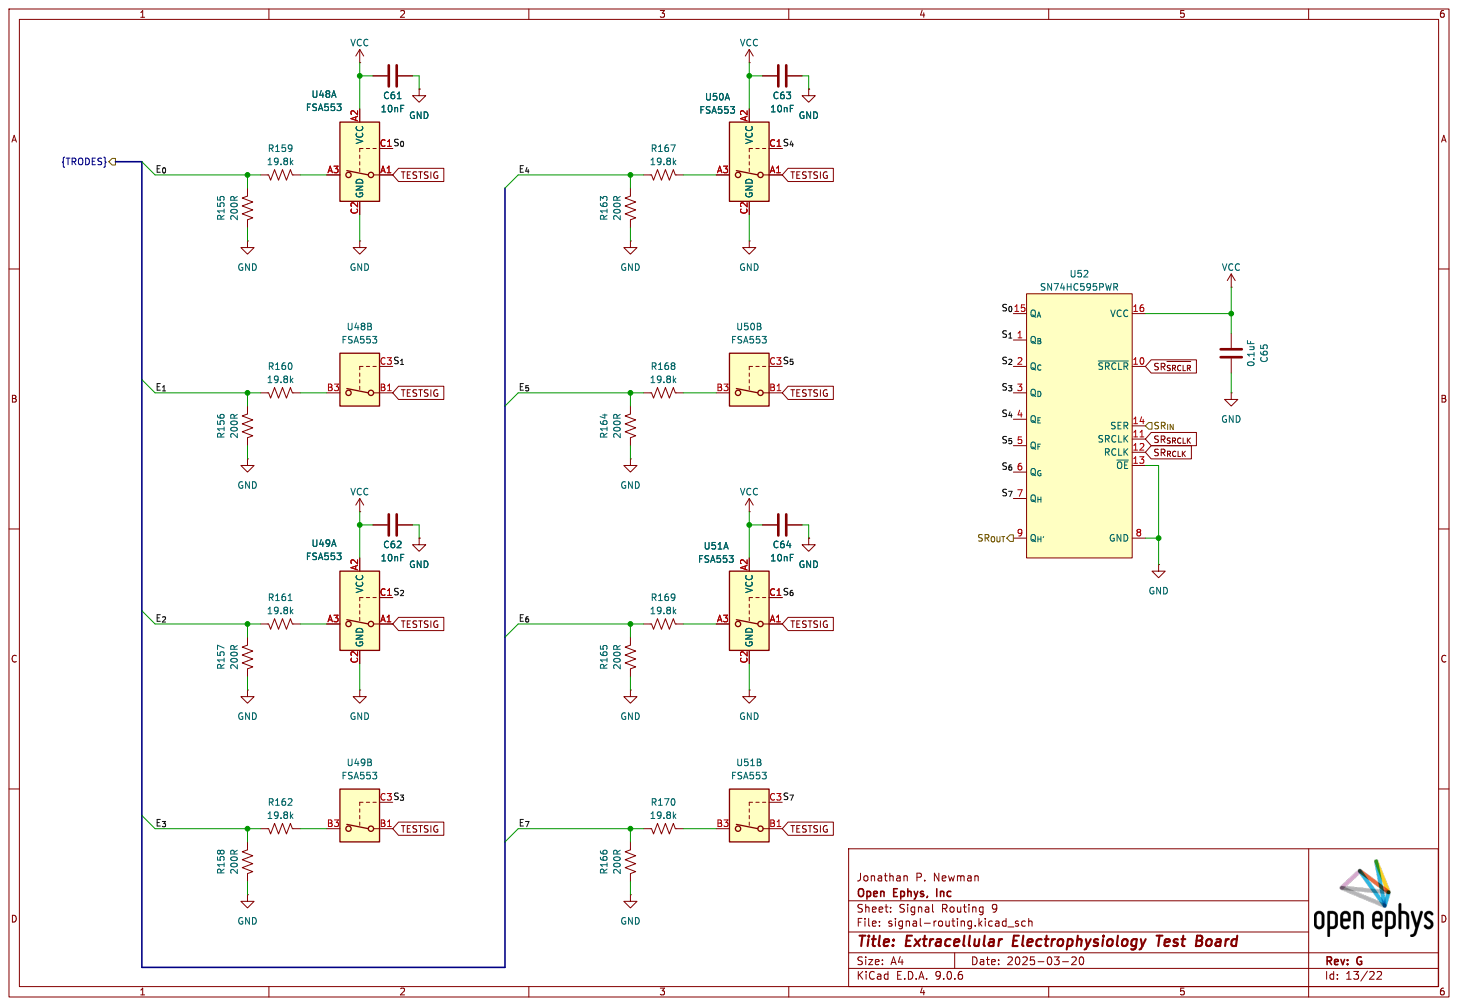
[picture p33: page 13]

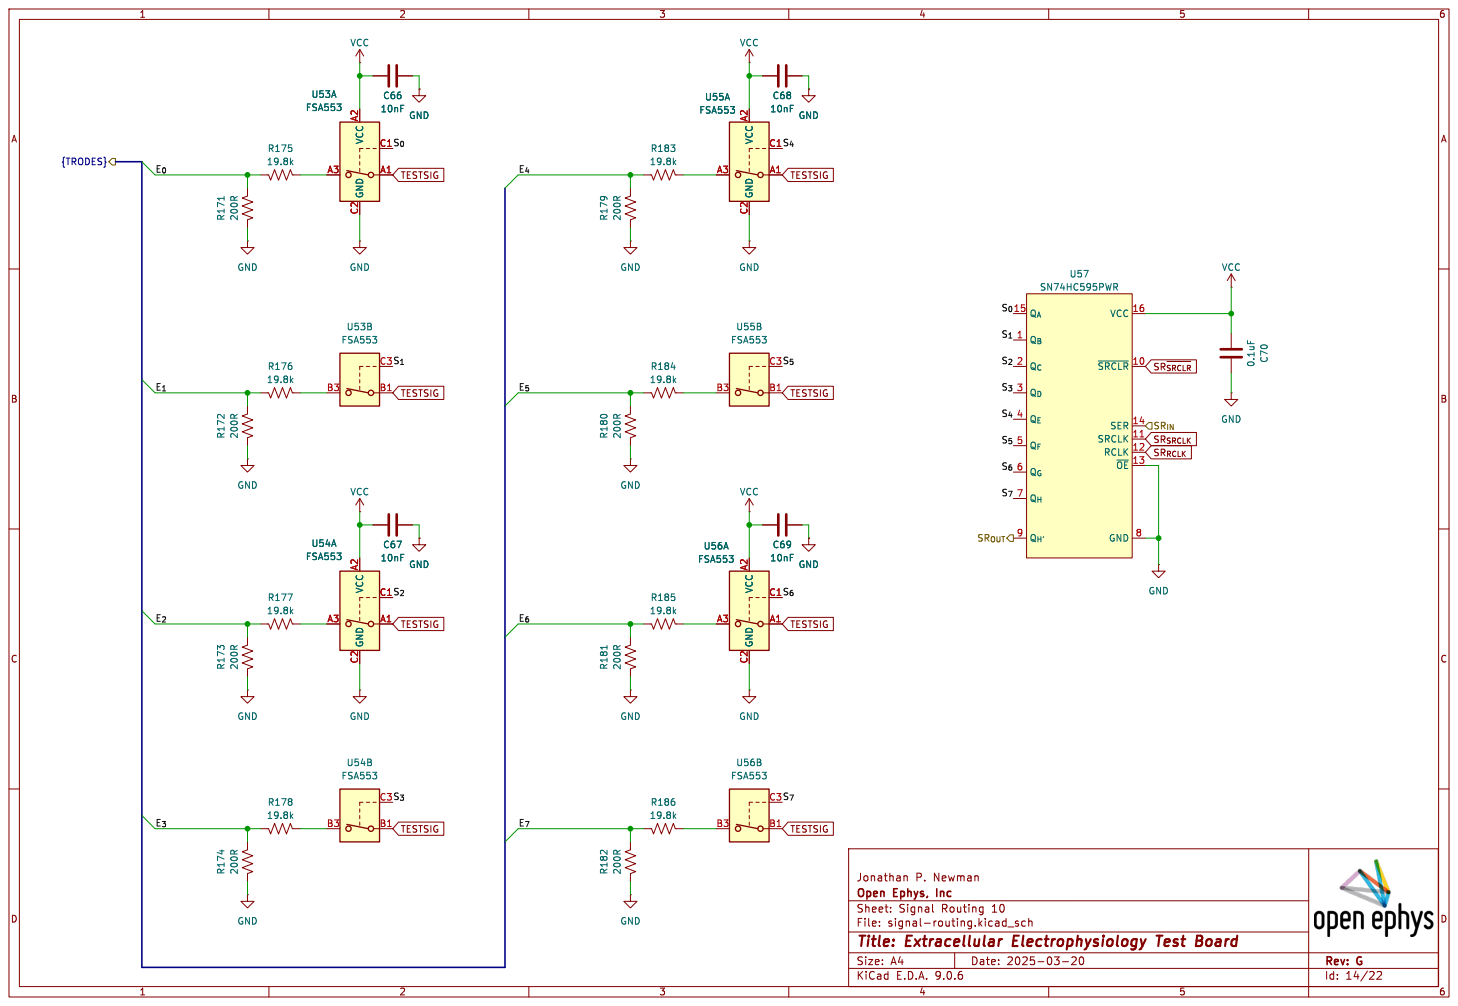
[picture p34: page 14]

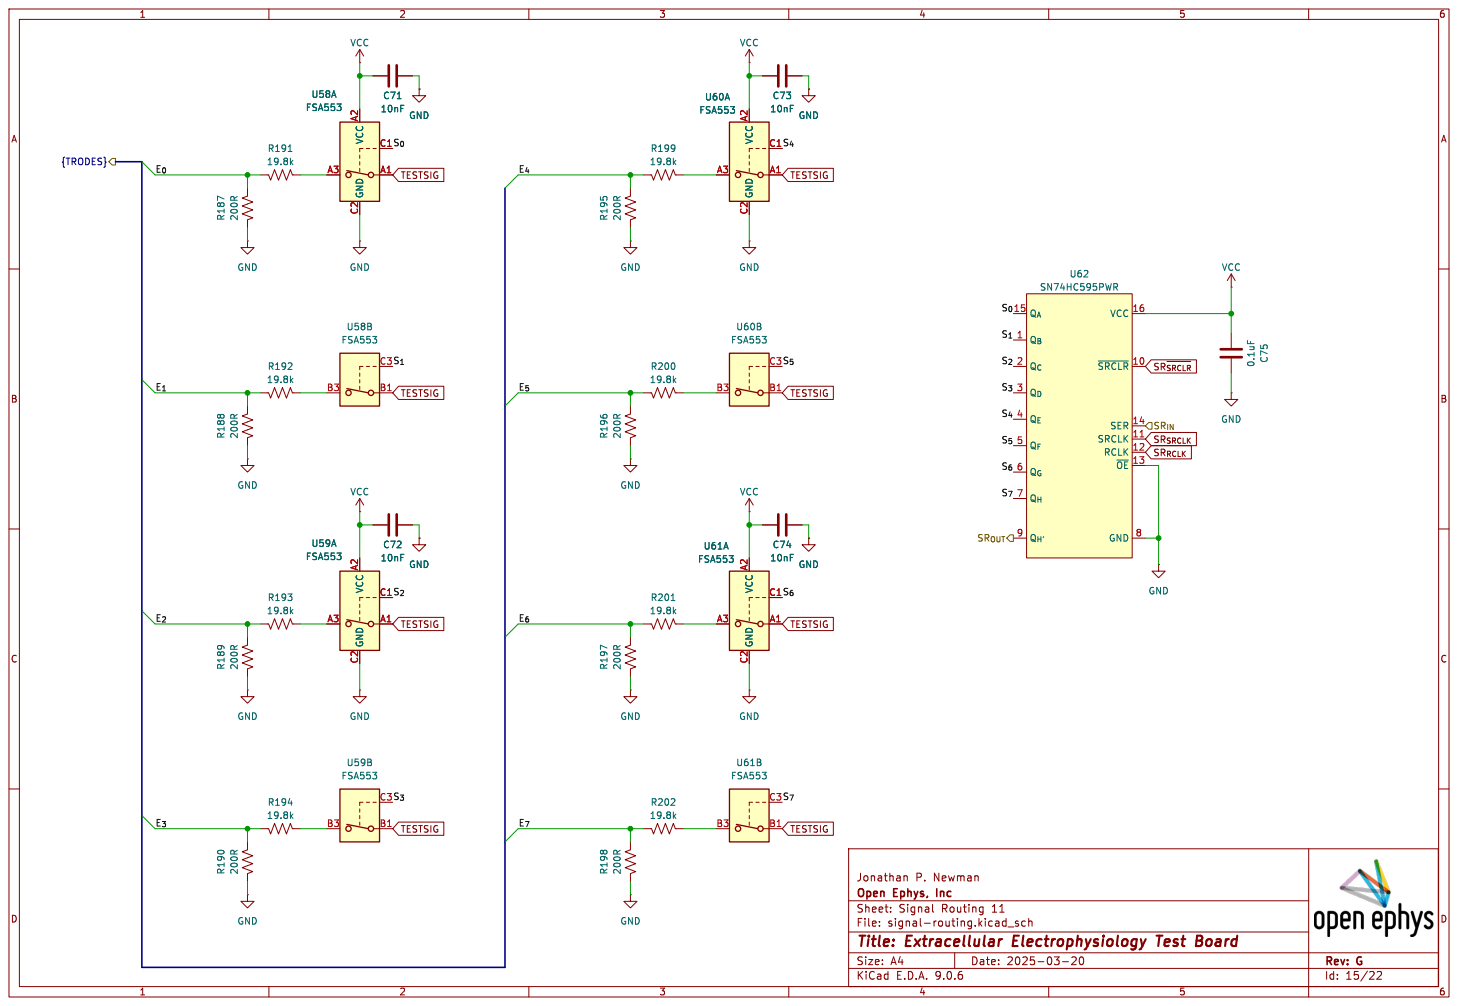
[picture p35: page 15]

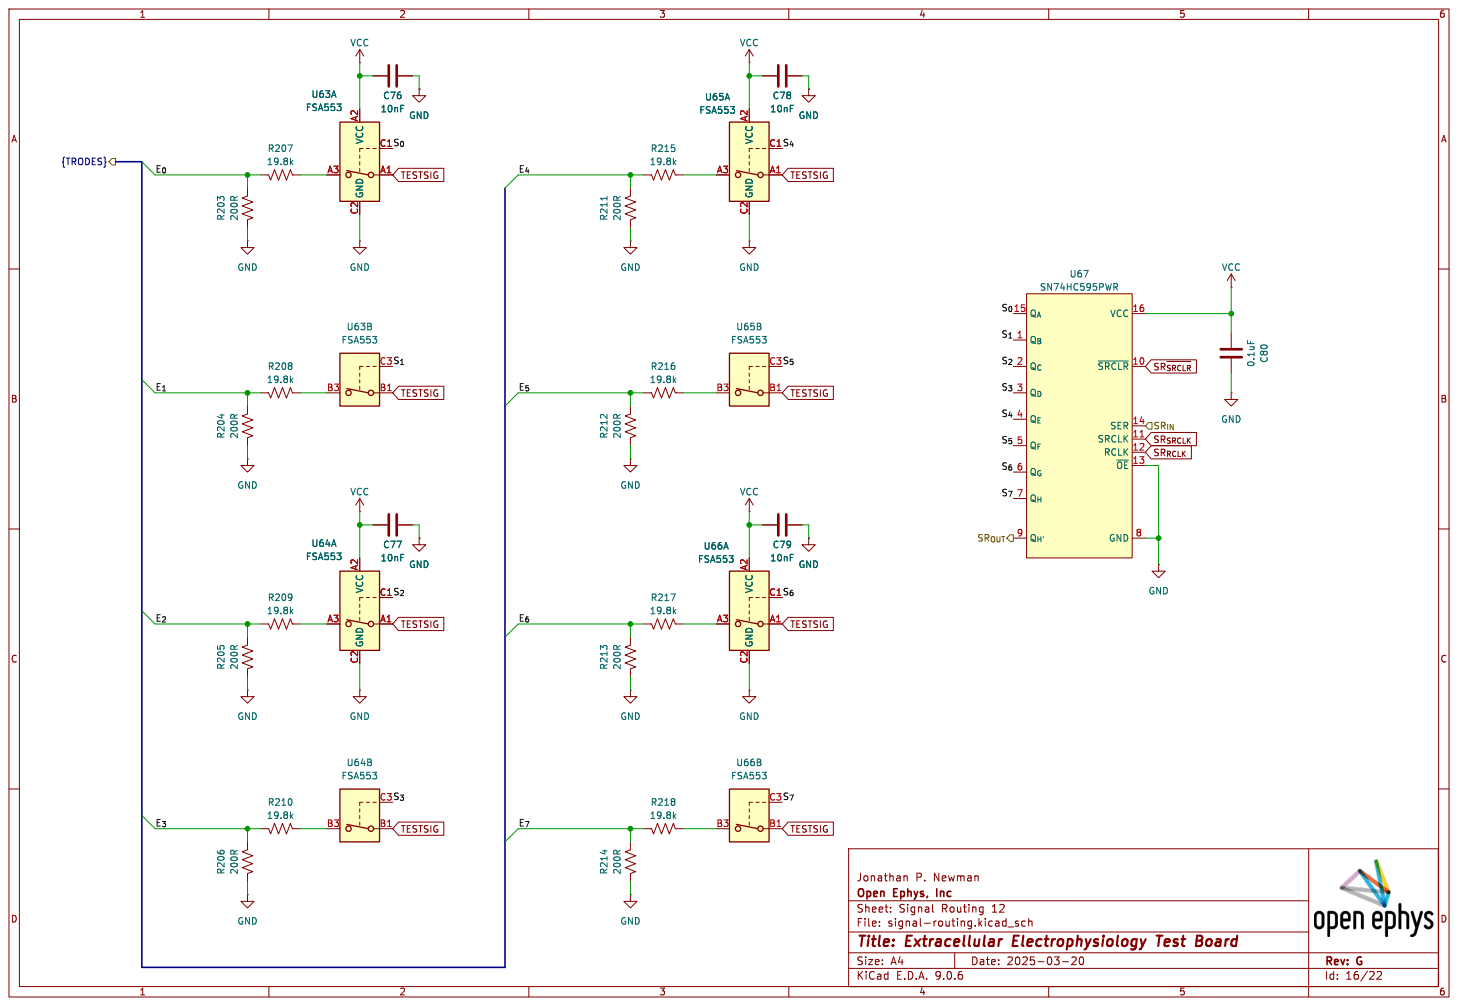
[picture p36: page 16]

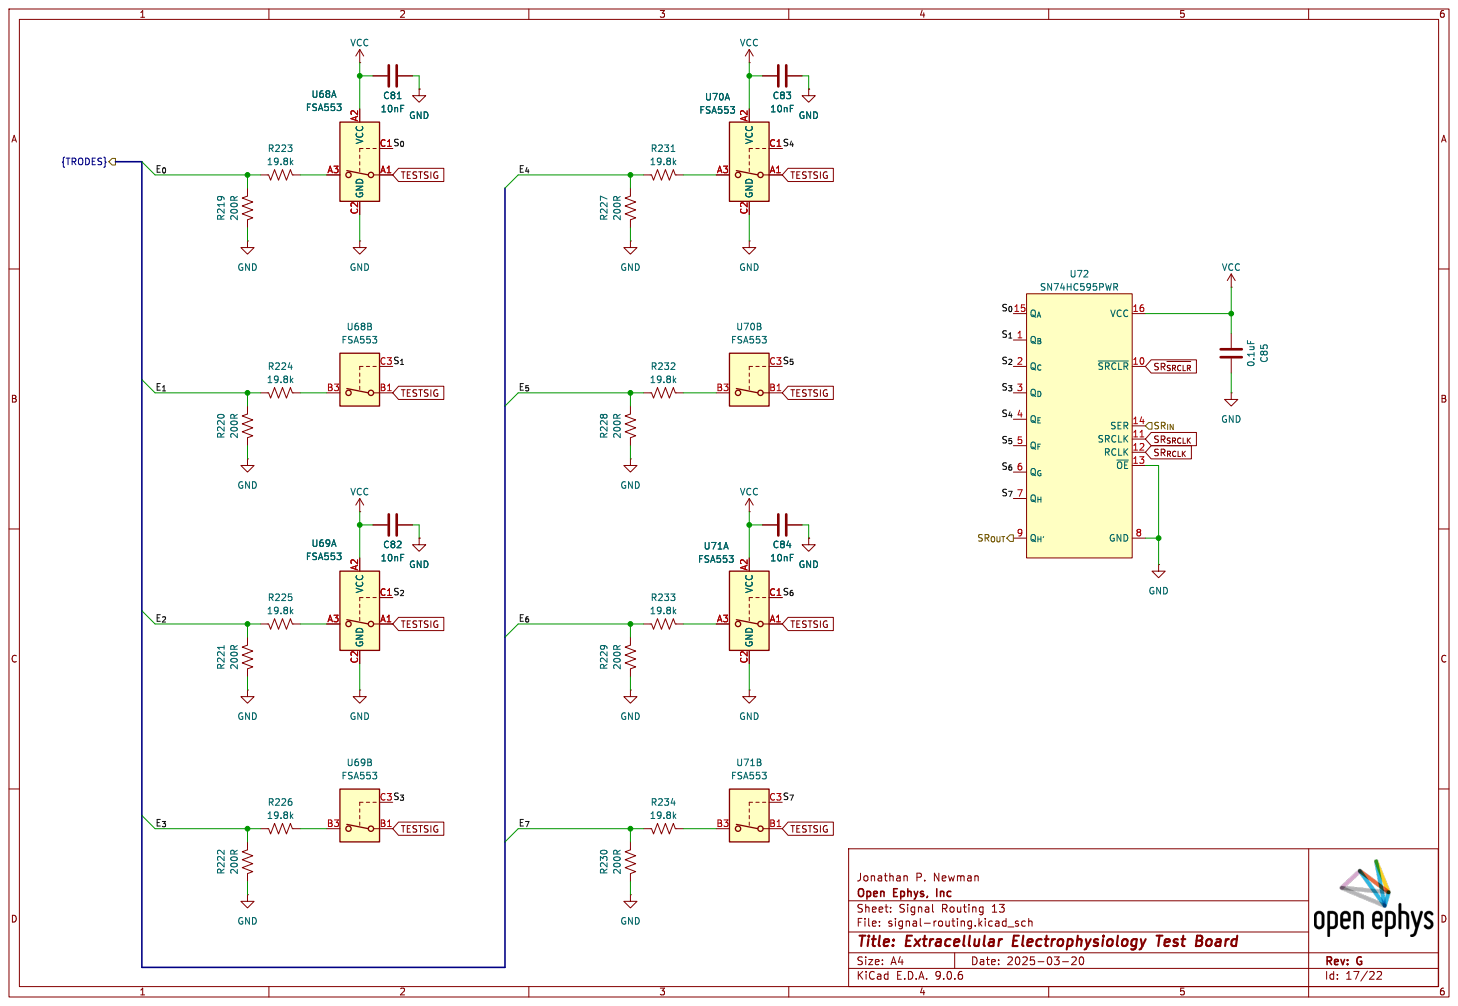
[picture p37: page 17]

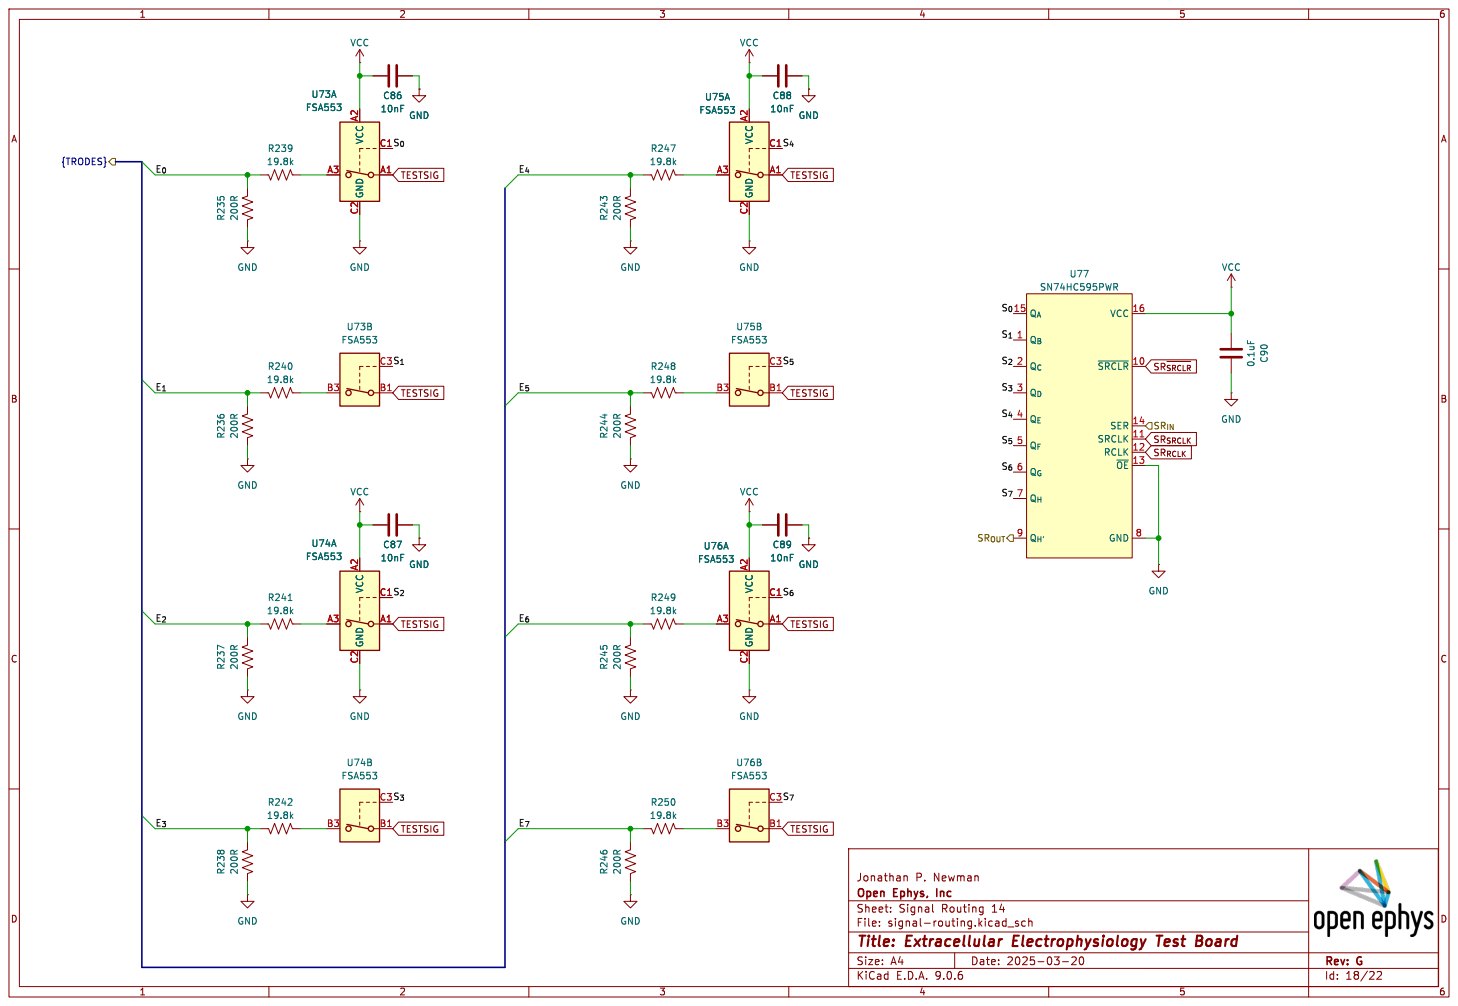
[picture p38: page 18]

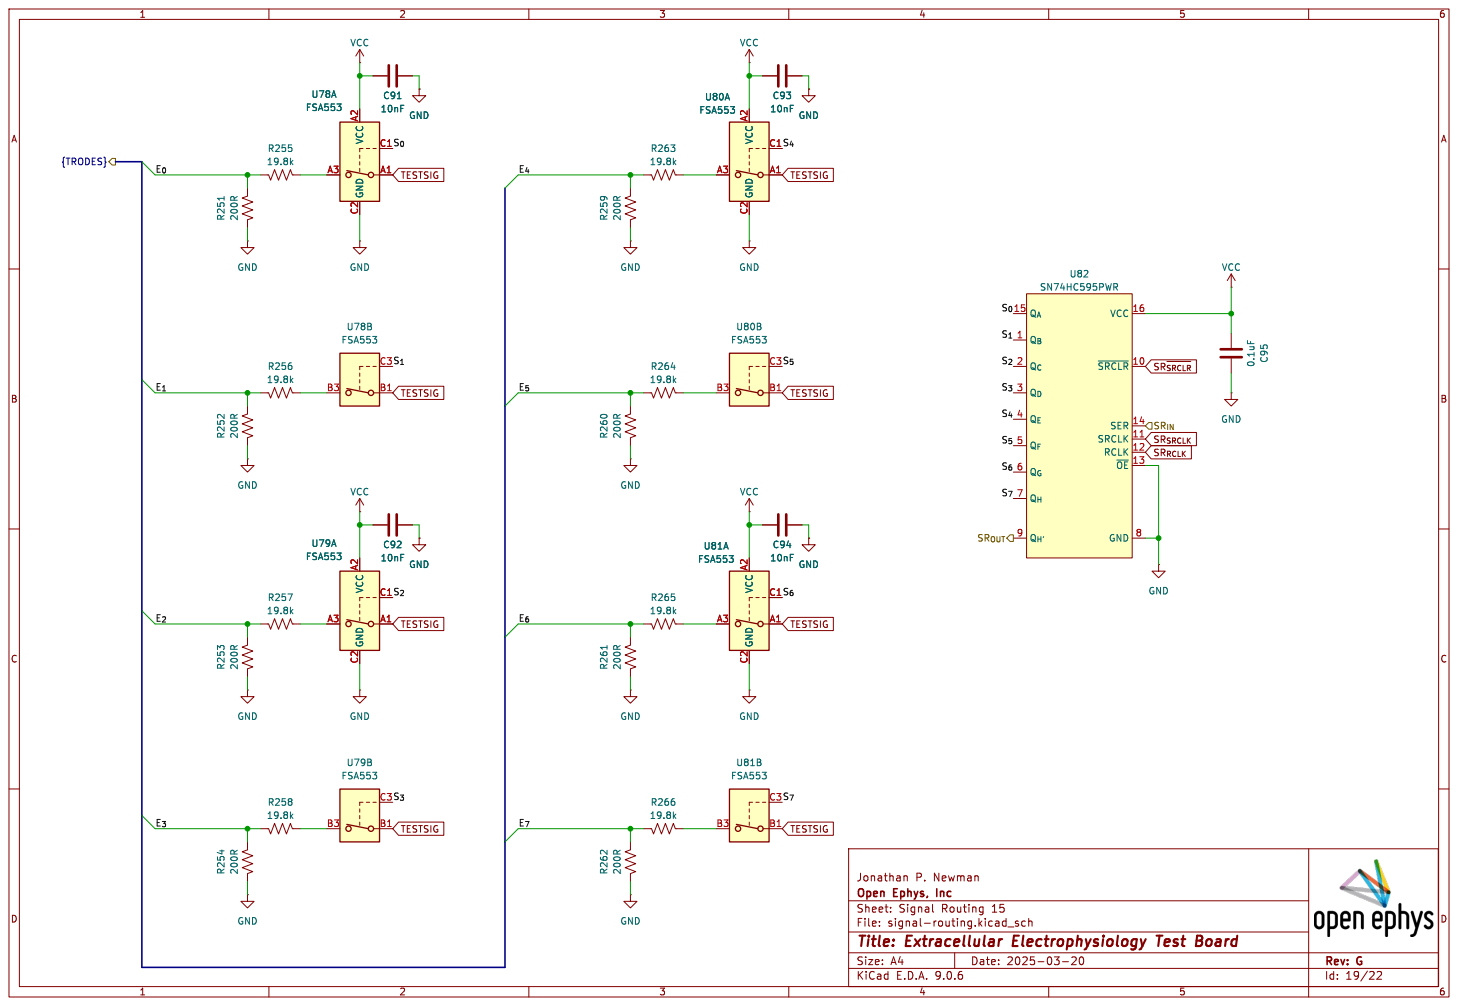
[picture p39: page 19]

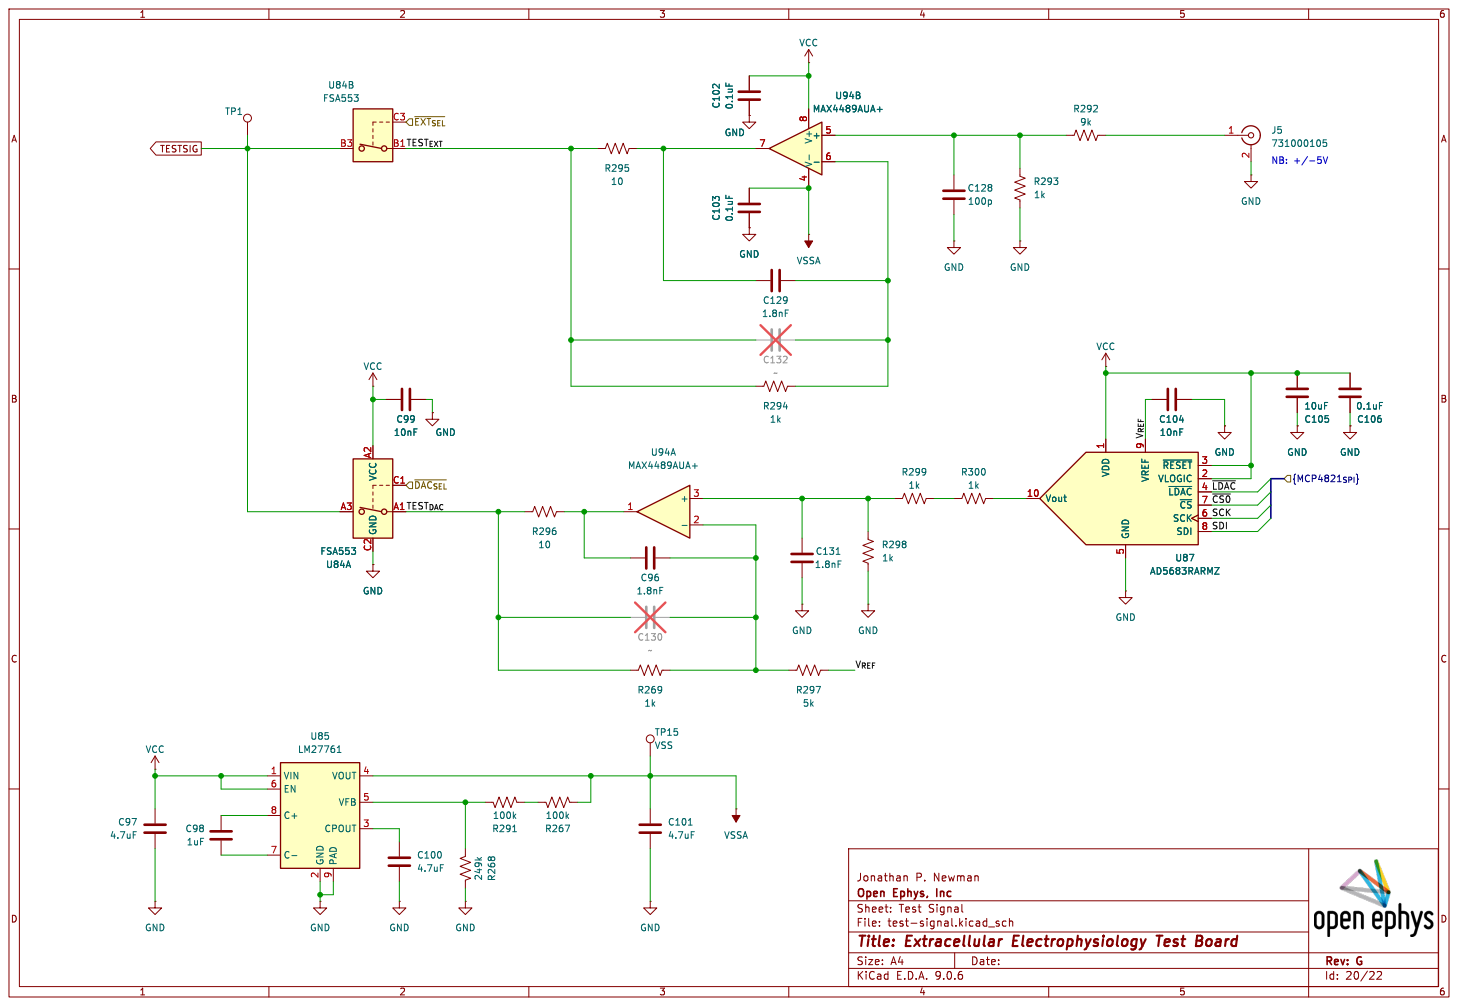
[picture p40: page 20]

9 GND
~{RESET}3 VLOGIC 2 ~{LDAC}4 ~{CS}7 SCK 6 SDI 8 VREF

File: test-signal.kicad_sch Sheet: Test Signal

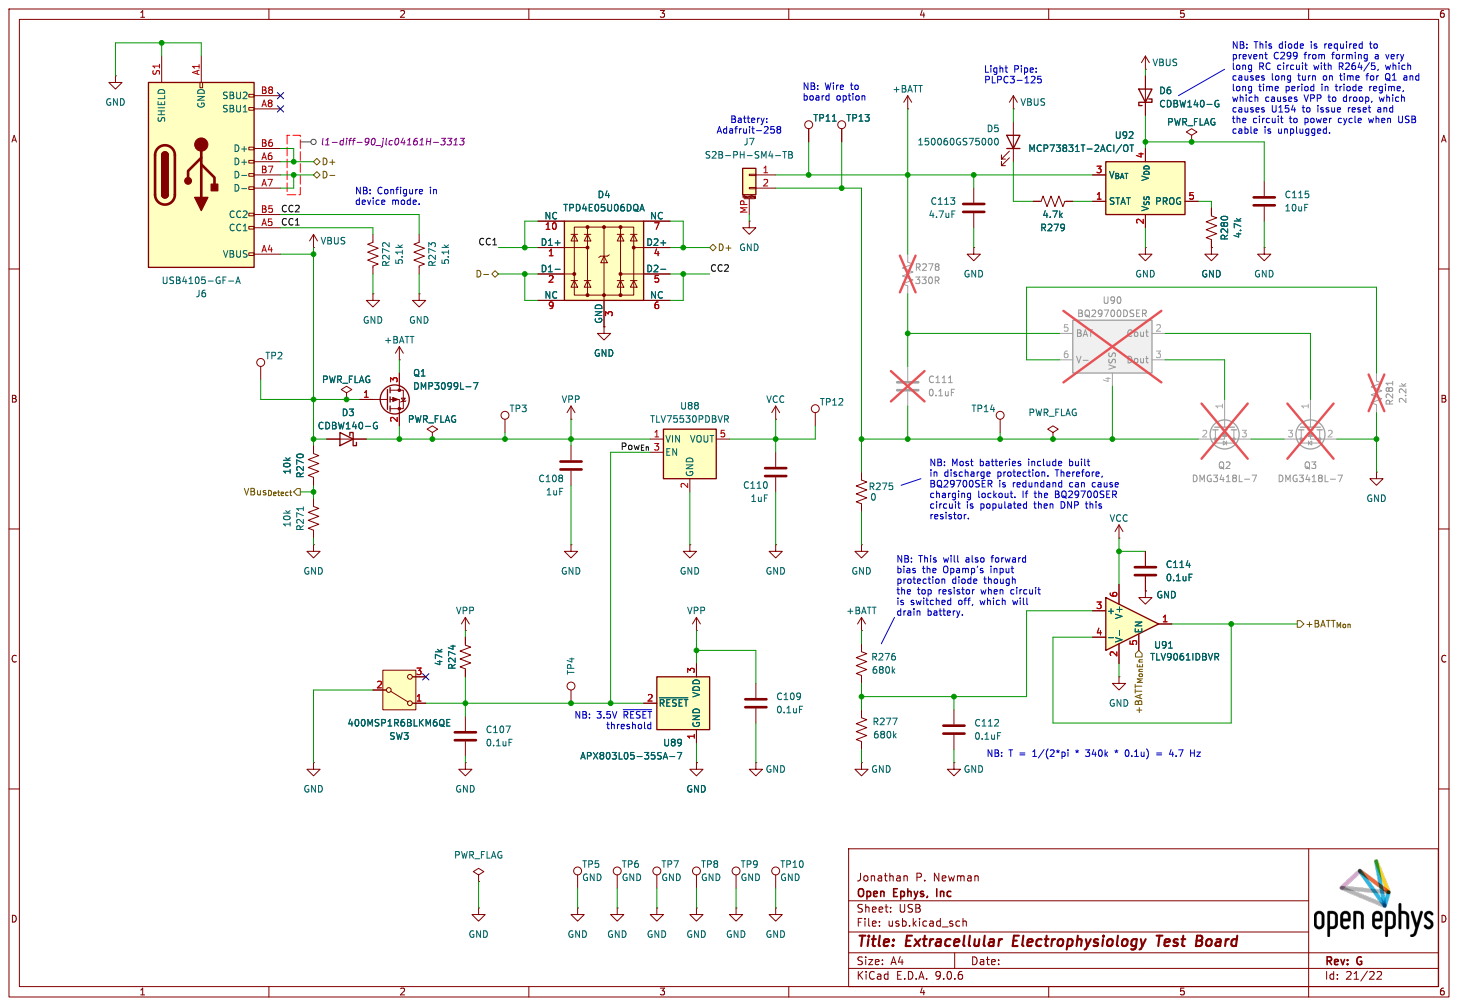
[picture p41: page 21]

causes long turn on time for Q1 and
long time period in triode regime, which causes VPP to droop, which

causes U154 to issue reset and

cable is unplugged. NB: This will also forward

bias the Opamp's input

is switched off, which will drain battery. NB: 3.5V ~{RESET}

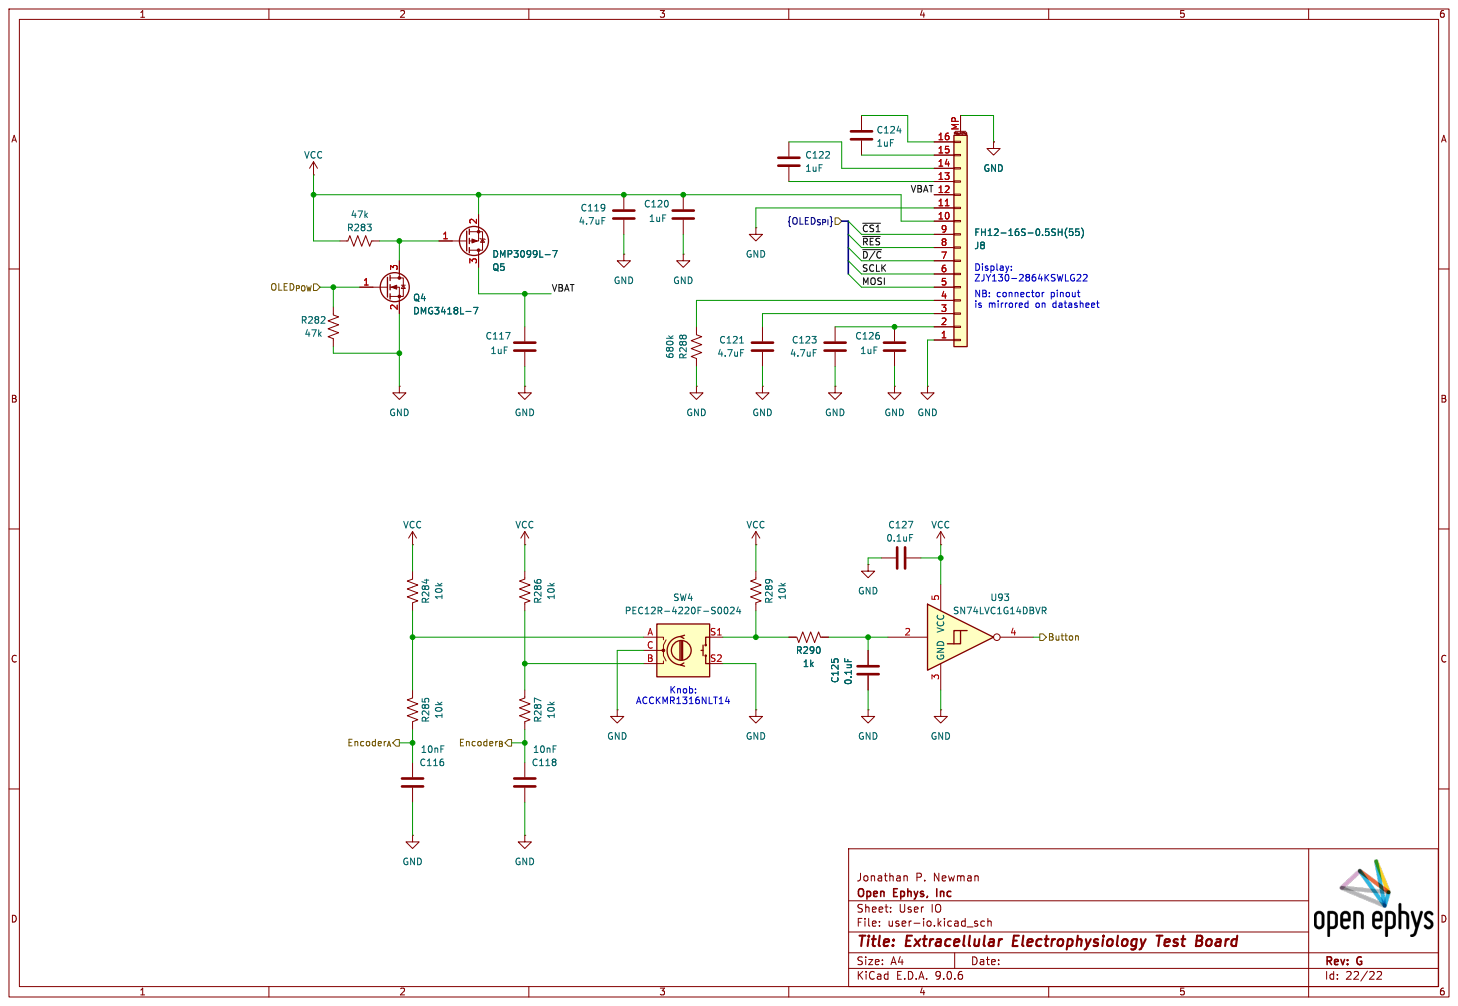
[picture p42: page 22]
