open-ephys/ephys-test-board/case/top-silk-finished.pdf

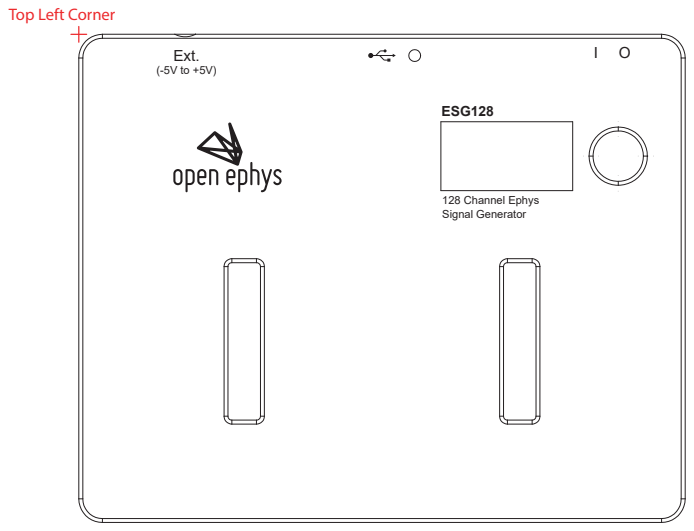
[picture p43: page 1]
Ext. (-5V to +5V); 128 Channel Ephys Signal Generator; ESG128

Top Left Corner
