open-ephys/ephys-test-board/case/top-silk-origin.pdf

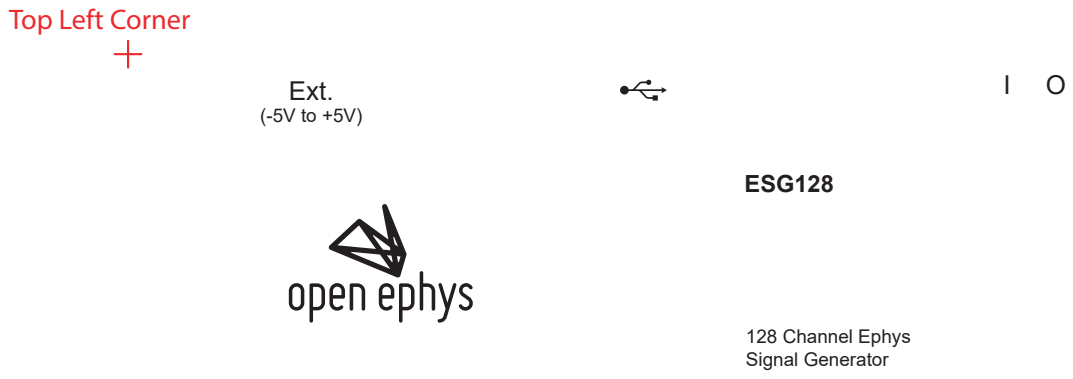
[picture p44: page 1]
Ext. (-5V to +5V); 128 Channel Ephys Signal Generator; ESG128

Top Left Corner
