open-ephys/ephys-test-board/spice/ext-input.asc

C1: cap; 1.8n
C2: cap; 4.7nF
C3: cap; 100p
R1: res; 9k
R2: res; 1k
R3: res; 1k
R4: res; 10
R5: res; R=table(Rx,1,200,2,1.5625)
R6: res; R=table(Rx,1,19.8k,2,154.69)
U2: MAX4489
V1: voltage; SINE(0 5 1k); AC 5
V2: voltage; 3.3
V3: voltage; 2.2
Named nets: 0, vss, vcc, IN, OUT
.tran 50m
NB: 1 and 128 channels in parallel
.step param Rx list 1 2
NB: Analog switch capacitance
.ac dec 100 0.1 100meg
