open-ephys/ephys-test-board/spice/max4489_unipolar-to-bipolar.asc

C2: cap; 1.8n
C3: cap; 1.8n
C4: cap; 4.7n
R1: res; 2k
R2: res; 1k
R3: res; 5k
R4: res; 1k
R5: res; R=table(Rx,1,200,2,1.5625)
R6: res; R=table(Rx,1,19.8k,2,154.69)
R7: res; 10
U3: MAX4489
V2: voltage; 2.5
V3: voltage; 3
V4: voltage; 2.2
V5: voltage; SINE(1.25 1.25 {freq}); AC 1.25
Named nets: 0, vss, vcc, IN, PRE, OUT
.ac dec 100 10 100Meg
.tran 0 150m 25m 100n
.four {freq} 10 -1 V(OUT)
.param freq=1k
.noise V(OUT) V5 dec 10 0.1 1Meg
NB: Gain is 0.01; 1 and 128 channels in parallel
.step param Rx list 1 2
.meas NOISE NoiseOut INTEG V(onoise) FROM 0.1 TO 1Meg
NB: Analog switch capacitance
