open-ephys/ephys-test-board/spice/max4489_unipolar-to-bipolar_offset.asc

C2: cap; 1.8n
C3: cap; 1.8n
C4: cap; 4.7nF
R1: res; 2k
R2: res; 1k
R3: res; 5k
R4: res; 1k
R5: res; 200
R6: res; 19.8k
R7: res; 10
U3: MAX4489
V1: voltage; {10u+var}
V2: voltage; 2.5
V3: voltage; 3.3
V4: voltage; 2.2
V5: voltage; SINE(1.25 1.25 {freq}); AC 1.25
Named nets: 0, vss, vcc, IN, PRE, OUT
.param freq=1k
.tran 0 20m 10m 10u
.param var=gauss(33u)
.step param run 1 100 1
.meas TRAN hl max V(out)
.meas tran mean avg V(out)
.meas tran ll min V(out)
NB: Analog switch capacitance
