open-ephys/ephys-test-board/spice/battery-usb-power-crossover.asc

C1: cap; 1µF
C2: cap; 10µ
D1: schottky; 1N914
D2: schottky; 1N914
R1: res; 100
R2: res; 20k
S1: sw; Switch1
U1: DMP3099L
V1: voltage; 5V
V2: voltage; 4.0
V3: voltage; PULSE(1 0 10m 0 0 100m 100m 1)
Named nets: 0, VUSB
.tran 100m
.model Switch1 SW(Ron=.1 Roff=1Meg Vt=0.5)
.inc DMP3099L.spice
