open-ephys/ephys-test-board/spice/oled-switch.asc

R1: res; 47k
R2: res; 47k
R3: res; 10
U1: DMG3418L
U2: DMP3099L
V1: voltage; 3.3V
V2: voltage; PULSE(0 3.3 10m 0 0 20m 0 1)
Named nets: 0, Vout
.tran 20m
.inc DMG3418L.spice
.inc DMP3099L.spice
