open-ephys/ephys-test-board/pcb/ephys-test-board.kicad_pcb

## KiCad design pcb/ephys-test-board.kicad_pcb (2026-08-20)

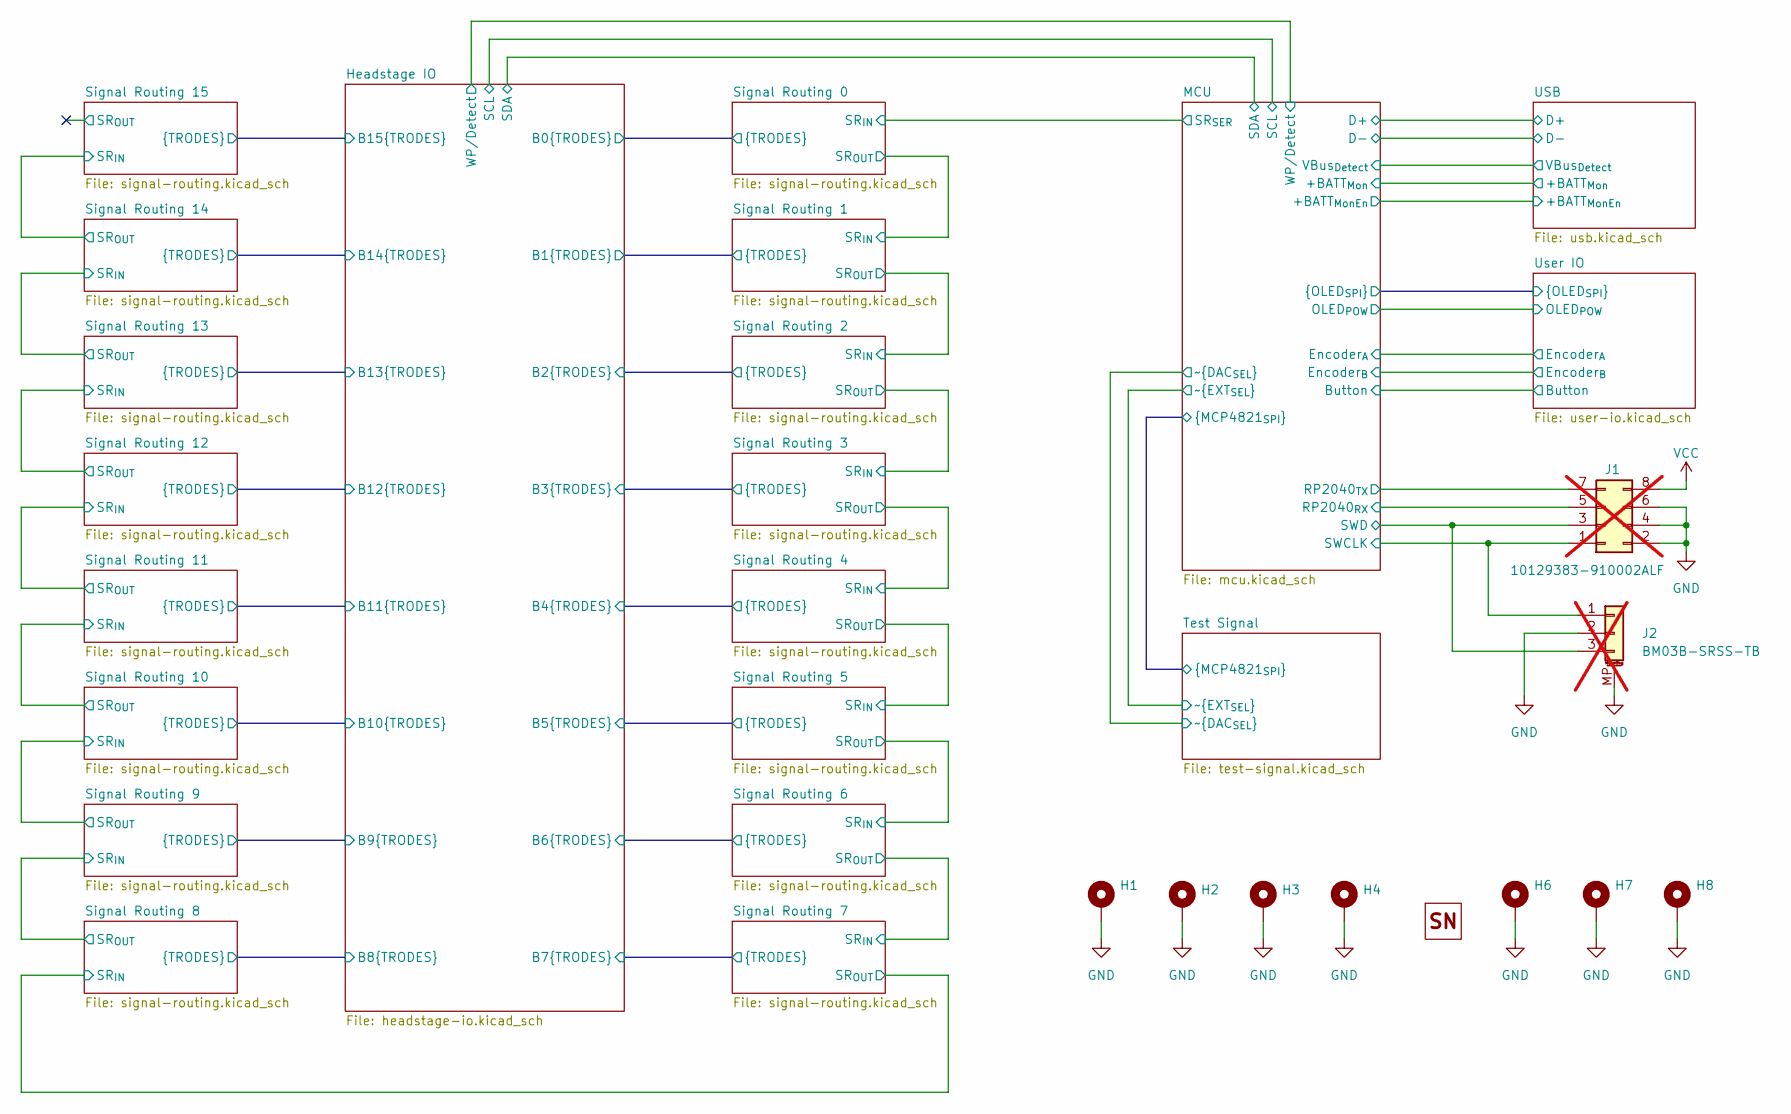
[picture p45: schematic ephys-test-board.kicad_sch, Extracellular Electrophysiology Test Board]

Parts:
H1, H2, H3, H4, H6, H7, H8: MountingHole_3.2mm_M3_ISO7380_Pad
H5: OEPS_SN-STICKER-8x20mm
J1: 10129383-910002ALF; PinHeader_2x04_P2.54mm_Vertical_SMD; MPN 10129383-910002ALF; not fitted
J2: BM03B-SRSS-TB; JST_SH_BM03B-SRSS-TB_1x03-1MP_P1.00mm_Vertical; MPN BM03B-SRSS-TB; not fitted

Connections:
/MCU/RP2040_{RX}: J1.5; also elsewhere on the board
/MCU/RP2040_{TX}: J1.7; also elsewhere on the board
/MCU/SWCLK: J1.1, J2.1; also elsewhere on the board
/MCU/SWD: J1.3, J2.3; also elsewhere on the board
GND: H1.1 (1_1), H2.1 (1_1), H3.1 (1_1), H4.1 (1_1), H6.1 (1_1), H7.1 (1_1), H8.1 (1_1), J1.2, J1.4, J1.6, J2.2, J2.MP (MountPin); also elsewhere on the board
VCC: J1.8; also elsewhere on the board

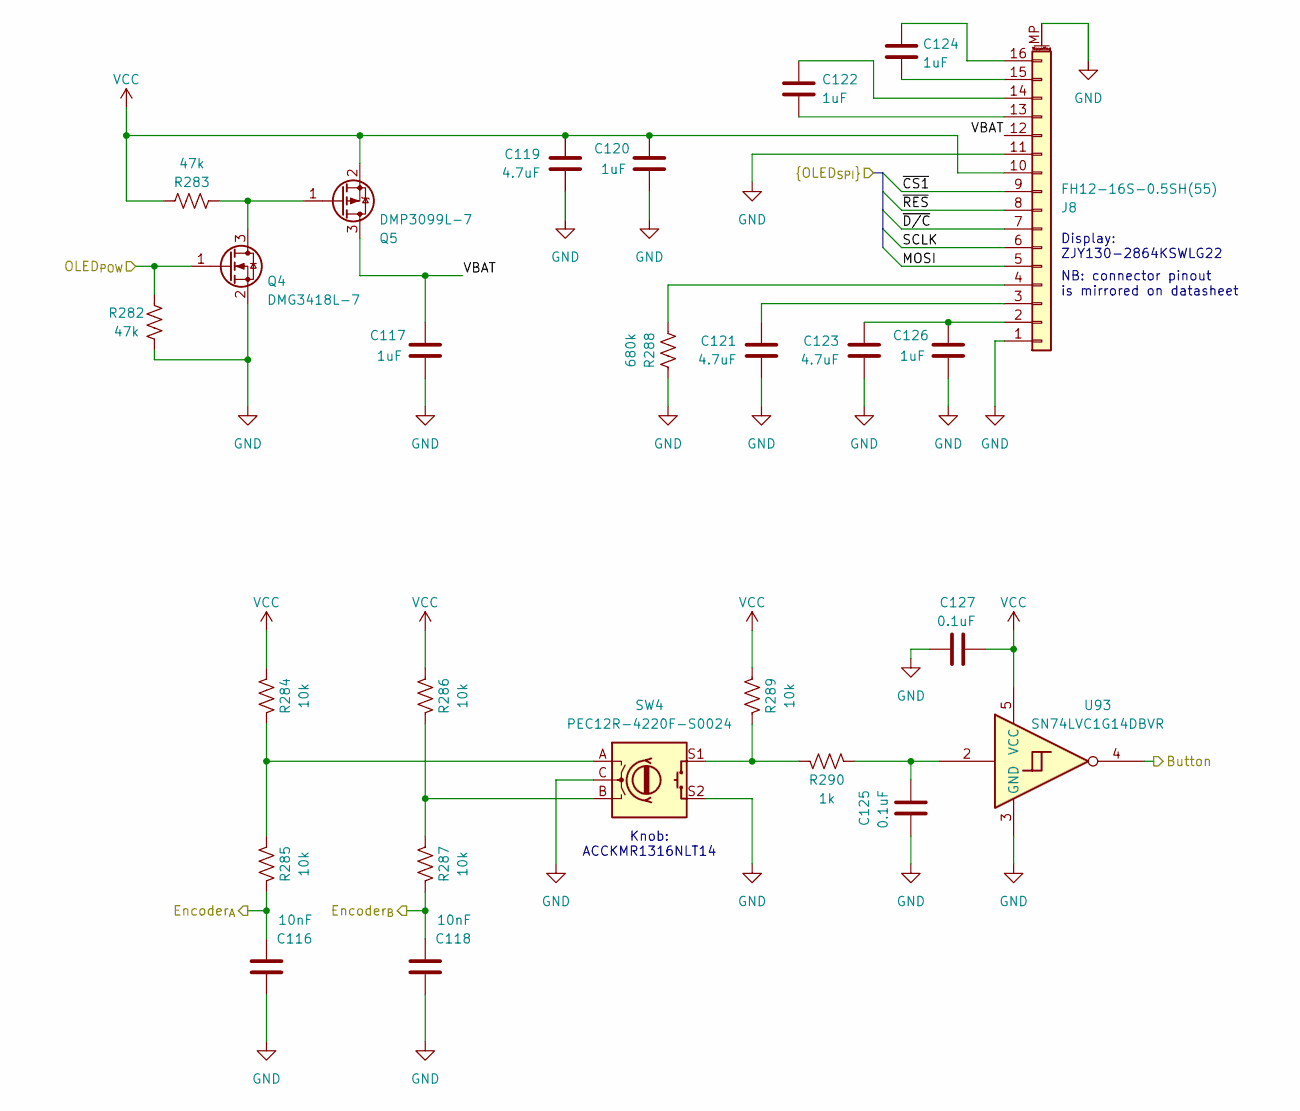
[picture p46: schematic user-io.kicad_sch, Extracellular Electrophysiology Test Board]

Parts:
C116, C118: 10nF; C_0402_1005Metric; Voltage 50V; MPN GRM155R71E103KA01D; LCSC C60133
C117, C120, C122, C124, C126: 1uF; C_0603_1608Metric; Voltage 16V; MPN CL10A105KA8NNNC; LCSC C5673
C119, C121, C123: 4.7uF; C_1206_3216Metric; Voltage 16V; MPN CL31B475KOHNNNE; LCSC C51205
C125, C127: 0.1uF; C_0402_1005Metric; Voltage 25V; MPN C1005X7R1E104K050BB; LCSC C105883
J8: FH12-16S-0.5SH(55); Hirose_FH12-16S-0.5SH_1x16-1MP_P0.50mm_Horizontal; MPN FH12-16S-0.5SH(55); LCSC C262665
Q4: DMG3418L-7; SOT-23; MPN DMG3418L-7; LCSC C151026
Q5: DMP3099L-7; SOT-23; MPN DMP3099L-7; LCSC C155244
R282, R283: 47k; R_0402_1005Metric; MPN ERJ-2RKF4702X; LCSC C93943
R284, R285, R286, R287, R289: 10k; R_0402_1005Metric; MPN CRCW040210K0FKED; LCSC C60490
R288: 680k; R_0402_1005Metric; MPN RC0402FR-13680KL; LCSC C2909377
R290: 1k; R_0402_1005Metric; Tolerance 0.1%; MPN RG1005P-102-B-T5; LCSC C2073397
SW4: PEC12R-4220F-S0024; RotaryEncoder_Bourns_Vertical_PEC12R-3x17F-Sxxxx; MPN PEC12R-4220F-S0024; LCSC C18164805
U93: SN74LVC1G14DBVR; SOT-23-5; MPN SN74LVC1G14DBVR; LCSC C7835

Connections:
/MCU/Button: U93.4; also elsewhere on the board
/MCU/Encoder_{A}: C116.1, R285.2; also elsewhere on the board
/MCU/Encoder_{B}: C118.1, R287.2; also elsewhere on the board
/MCU/MOSI: J8.5; also elsewhere on the board
/MCU/OLED_{POW}: Q4.1 (G), R282.1; also elsewhere on the board
/MCU/SCLK: J8.6; also elsewhere on the board
/MCU/~CS1: J8.9; also elsewhere on the board
/MCU/~D/C: J8.7; also elsewhere on the board
/MCU/~RES: J8.8; also elsewhere on the board
/User IO/VBAT: C117.2, J8.12, Q5.3 (D)
GND: C116.2, C117.1, C118.2, C119.2, C120.1, C121.2, C123.2, C125.2, C126.1, C127.2, J8.1, J8.11, J8.MP (MountPin), Q4.2 (S), R282.2, R288.2, SW4.C, SW4.S2, U93.3 (GND); also elsewhere on the board
unnamed: C125.1, R290.2, U93.2
unnamed: C123.1, C126.2, J8.2
unnamed: C121.1, J8.3
unnamed: J8.4, R288.1
unnamed: C122.1, J8.13
unnamed: C122.2, J8.14
unnamed: C124.1, J8.15
unnamed: C124.2, J8.16
unnamed: Q4.3 (D), Q5.1 (G), R283.1
unnamed: R284.2, R285.1, SW4.A
unnamed: R286.2, R287.1, SW4.B
unnamed: R289.2, R290.1, SW4.S1
VCC: C119.1, C120.2, C127.1, J8.10, Q5.2 (S), R283.2, R284.1, R286.1, R289.1, U93.5 (VCC); also elsewhere on the board

Notes on the sheet:
Display: ZJY130-2864KSWLG22
Knob: ACCKMR1316NLT14
NB: connector pinout is mirrored on datasheet
