open-ephys/ephys-test-board/pcb/ephys-test-board.kicad_pcb

## KiCad design pcb/ephys-test-board.kicad_pcb (continued)

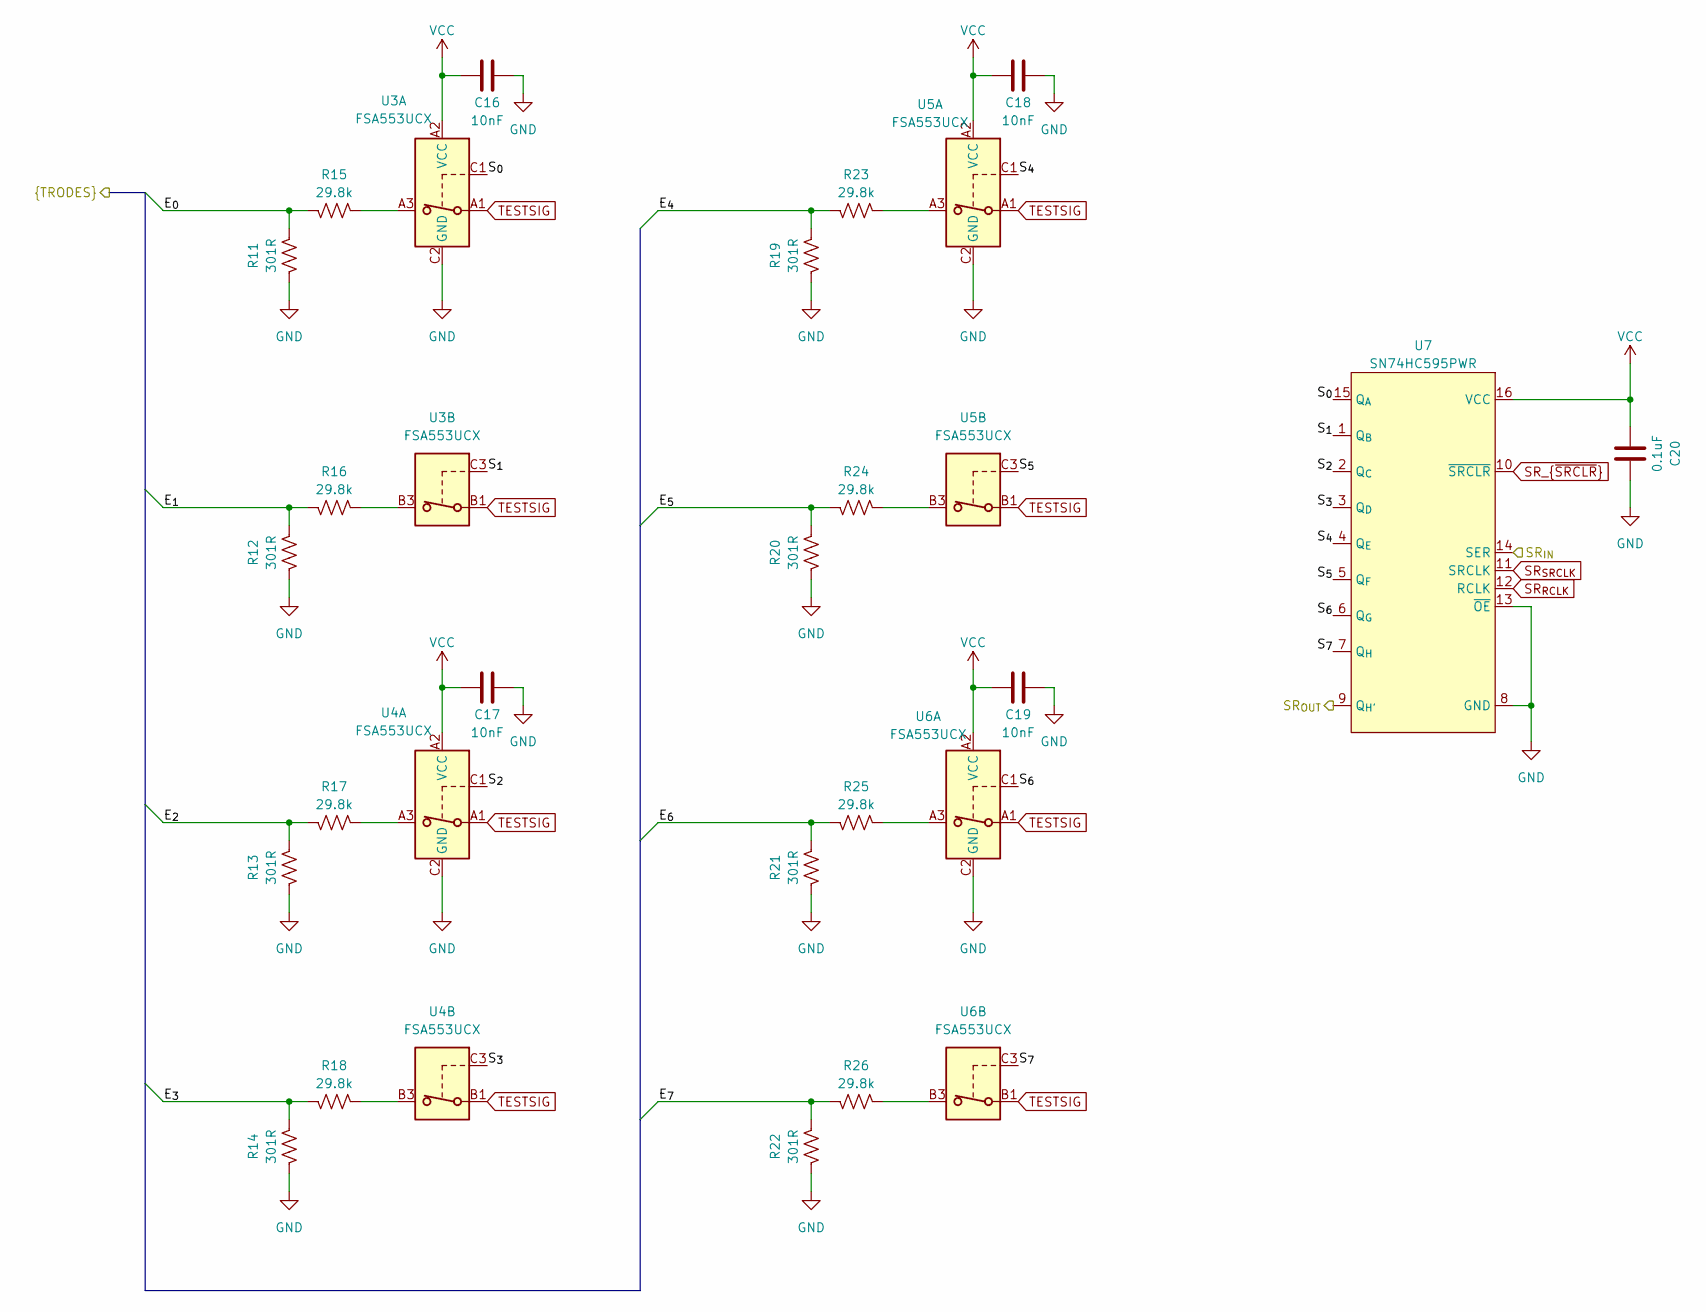
[picture p47: schematic signal-routing.kicad_sch, Extracellular Electrophysiology Test Board]

Parts:
C16, C17, C18, C19: 10nF; C_0402_1005Metric; Voltage 50V; MPN GRM155R71E103KA01D; LCSC C60133
C20: 0.1uF; C_0402_1005Metric; Voltage 25V; MPN C1005X7R1E104K050BB; LCSC C105883
R11, R12, R13, R14, R19, R20, R21, R22: 301R; R_0402_1005Metric; Tolerance 0.1%; MPN RT0402BRD07301RL
R15, R16, R17, R18, R23, R24, R25, R26: 29.8k; R_0402_1005Metric; Tolerance 0.1%; MPN RN73R1ETTP2982B25; LCSC C2506693
U3, U4, U5, U6: FSA553UCX; ONSEMI_567SV_WLCSP9-3x3-1.215x1.385x0.581mm-P0.4mm; MPN FSA553UCX; LCSC C605183
U7: SN74HC595PWR; TSSOP-16_4.4x5mm_P0.65mm; MPN SN74HC595PWR; LCSC C273642

Connections:
/Headstage IO/B0.E_{0}: R11.1, R15.2; also elsewhere on the board
/Headstage IO/B0.E_{1}: R12.1, R16.2; also elsewhere on the board
/Headstage IO/B0.E_{2}: R13.1, R17.2; also elsewhere on the board
/Headstage IO/B0.E_{3}: R14.1, R18.2; also elsewhere on the board
/Headstage IO/B0.E_{4}: R19.1, R23.2; also elsewhere on the board
/Headstage IO/B0.E_{5}: R20.1, R24.2; also elsewhere on the board
/Headstage IO/B0.E_{6}: R21.1, R25.2; also elsewhere on the board
/Headstage IO/B0.E_{7}: R22.1, R26.2; also elsewhere on the board
/MCU/SR_{SER}: U7.14 (SER); also elsewhere on the board
/Signal Routing 0/SR_{OUT}: U7.9 (Q_{H'}); also elsewhere on the board
/Signal Routing 0/S_{0}: U3.C1, U7.15 (Q_{A})
/Signal Routing 0/S_{1}: U3.C3, U7.1 (Q_{B})
/Signal Routing 0/S_{2}: U4.C1, U7.2 (Q_{C})
/Signal Routing 0/S_{3}: U4.C3, U7.3 (Q_{D})
/Signal Routing 0/S_{4}: U5.C1, U7.4 (Q_{E})
/Signal Routing 0/S_{5}: U5.C3, U7.5 (Q_{F})
/Signal Routing 0/S_{6}: U6.C1, U7.6 (Q_{G})
/Signal Routing 0/S_{7}: U6.C3, U7.7 (Q_{H})
GND: C16.2, C17.2, C18.2, C19.2, C20.2, R11.2, R12.2, R13.2, R14.2, R19.2, R20.2, R21.2, R22.2, U3.C2 (GND), U4.C2 (GND), U5.C2 (GND), U6.C2 (GND), U7.8 (GND), U7.13 (~OE); also elsewhere on the board
unnamed: R15.1, U3.A3
unnamed: R16.1, U3.B3
unnamed: R17.1, U4.A3
unnamed: R18.1, U4.B3
unnamed: R23.1, U5.A3
unnamed: R24.1, U5.B3
unnamed: R25.1, U6.A3
unnamed: R26.1, U6.B3
SR_{RCLK}: U7.12 (RCLK); also elsewhere on the board
SR_{SRCLK}: U7.11 (SRCLK); also elsewhere on the board
SR_{~SRCLR}: U7.10 (~SRCLR); also elsewhere on the board
TESTSIG: U3.A1, U3.B1, U4.A1, U4.B1, U5.A1, U5.B1, U6.A1, U6.B1; also elsewhere on the board
VCC: C16.1, C17.1, C18.1, C19.1, C20.1, U3.A2 (VCC), U4.A2 (VCC), U5.A2 (VCC), U6.A2 (VCC), U7.16 (VCC); also elsewhere on the board

Parts of its further copies:
C21, C22, C23, C24, C26, C27, C28, C29, C31, C32, C33, C34, C36, C37, C38, C39, C41, C42, C43, C44, C46, C47, C48, C49, C51, C52, C53, C54, C56, C57, C58, C59, C61, C62, C63, C64, C66, C67, C68, C69, C71, C72, C73, C74, C76, C77, C78, C79, C81, C82, C83, C84, C86, C87, C88, C89, C91, C92, C93, C94: 10nF; C_0402_1005Metric; Voltage 50V; MPN GRM155R71E103KA01D; LCSC C60133
C25, C30, C35, C40, C45, C50, C55, C60, C65, C70, C75, C80, C85, C90, C95: 0.1uF; C_0402_1005Metric; Voltage 25V; MPN C1005X7R1E104K050BB; LCSC C105883
R27, R28, R29, R30, R35, R36, R37, R38, R43, R44, R45, R46, R51, R52, R53, R54, R59, R60, R61, R62, R67, R68, R69, R70, R75, R76, R77, R78, R83, R84, R85, R86, R91, R92, R93, R94, R99, R100, R101, R102, R107, R108, R109, R110, R115, R116, R117, R118, R123, R124, R125, R126, R131, R132, R133, R134, R139, R140, R141, R142, R147, R148, R149, R150, R155, R156, R157, R158, R163, R164, R165, R166, R171, R172, R173, R174, R179, R180, R181, R182, R187, R188, R189, R190, R195, R196, R197, R198, R203, R204, R205, R206, R211, R212, R213, R214, R219, R220, R221, R222, R227, R228, R229, R230, R235, R236, R237, R238, R243, R244, R245, R246, R251, R252, R253, R254, R259, R260, R261, R262: 301R; R_0402_1005Metric; Tolerance 0.1%; MPN RT0402BRD07301RL
R31, R32, R33, R34, R39, R40, R41, R42, R47, R48, R49, R50, R55, R56, R57, R58, R63, R64, R65, R66, R71, R72, R73, R74, R79, R80, R81, R82, R87, R88, R89, R90, R95, R96, R97, R98, R103, R104, R105, R106, R111, R112, R113, R114, R119, R120, R121, R122, R127, R128, R129, R130, R135, R136, R137, R138, R143, R144, R145, R146, R151, R152, R153, R154, R159, R160, R161, R162, R167, R168, R169, R170, R175, R176, R177, R178, R183, R184, R185, R186, R191, R192, R193, R194, R199, R200, R201, R202, R207, R208, R209, R210, R215, R216, R217, R218, R223, R224, R225, R226, R231, R232, R233, R234, R239, R240, R241, R242, R247, R248, R249, R250, R255, R256, R257, R258, R263, R264, R265, R266: 29.8k; R_0402_1005Metric; Tolerance 0.1%; MPN RN73R1ETTP2982B25; LCSC C2506693
U8, U9, U10, U11, U13, U14, U15, U16, U18, U19, U20, U21, U23, U24, U25, U26, U28, U29, U30, U31, U33, U34, U35, U36, U38, U39, U40, U41, U43, U44, U45, U46, U48, U49, U50, U51, U53, U54, U55, U56, U58, U59, U60, U61, U63, U64, U65, U66, U68, U69, U70, U71, U73, U74, U75, U76, U78, U79, U80, U81: FSA553UCX; ONSEMI_567SV_WLCSP9-3x3-1.215x1.385x0.581mm-P0.4mm; MPN FSA553UCX; LCSC C605183
U12, U17, U22, U27, U32, U37, U42, U47, U52, U57, U62, U67, U72, U77, U82: SN74HC595PWR; TSSOP-16_4.4x5mm_P0.65mm; MPN SN74HC595PWR; LCSC C273642

Connections of its further copies:
/Headstage IO/B1.E_{0}: R27.1, R31.2; also elsewhere on the board
/Headstage IO/B1.E_{1}: R28.1, R32.2; also elsewhere on the board
/Headstage IO/B1.E_{2}: R29.1, R33.2; also elsewhere on the board
/Headstage IO/B1.E_{3}: R30.1, R34.2; also elsewhere on the board
/Headstage IO/B1.E_{4}: R35.1, R39.2; also elsewhere on the board
/Headstage IO/B1.E_{5}: R36.1, R40.2; also elsewhere on the board
/Headstage IO/B1.E_{6}: R37.1, R41.2; also elsewhere on the board
/Headstage IO/B1.E_{7}: R38.1, R42.2; also elsewhere on the board
/Headstage IO/B2.E_{0}: R43.1, R47.2; also elsewhere on the board
/Headstage IO/B2.E_{1}: R44.1, R48.2; also elsewhere on the board
/Headstage IO/B2.E_{2}: R45.1, R49.2; also elsewhere on the board
/Headstage IO/B2.E_{3}: R46.1, R50.2; also elsewhere on the board
/Headstage IO/B2.E_{4}: R51.1, R55.2; also elsewhere on the board
/Headstage IO/B2.E_{5}: R52.1, R56.2; also elsewhere on the board
/Headstage IO/B2.E_{6}: R53.1, R57.2; also elsewhere on the board
/Headstage IO/B2.E_{7}: R54.1, R58.2; also elsewhere on the board
/Headstage IO/B3.E_{0}: R59.1, R63.2; also elsewhere on the board
/Headstage IO/B3.E_{1}: R60.1, R64.2; also elsewhere on the board
/Headstage IO/B3.E_{2}: R61.1, R65.2; also elsewhere on the board
/Headstage IO/B3.E_{3}: R62.1, R66.2; also elsewhere on the board
/Headstage IO/B3.E_{4}: R67.1, R71.2; also elsewhere on the board
/Headstage IO/B3.E_{5}: R68.1, R72.2; also elsewhere on the board
/Headstage IO/B3.E_{6}: R69.1, R73.2; also elsewhere on the board
/Headstage IO/B3.E_{7}: R70.1, R74.2; also elsewhere on the board
/Headstage IO/B4.E_{0}: R75.1, R79.2; also elsewhere on the board
/Headstage IO/B4.E_{1}: R76.1, R80.2; also elsewhere on the board
/Headstage IO/B4.E_{2}: R77.1, R81.2; also elsewhere on the board
/Headstage IO/B4.E_{3}: R78.1, R82.2; also elsewhere on the board
/Headstage IO/B4.E_{4}: R83.1, R87.2; also elsewhere on the board
/Headstage IO/B4.E_{5}: R84.1, R88.2; also elsewhere on the board
/Headstage IO/B4.E_{6}: R85.1, R89.2; also elsewhere on the board
/Headstage IO/B4.E_{7}: R86.1, R90.2; also elsewhere on the board
/Headstage IO/B5.E_{0}: R91.1, R95.2; also elsewhere on the board
/Headstage IO/B5.E_{1}: R92.1, R96.2; also elsewhere on the board
/Headstage IO/B5.E_{2}: R93.1, R97.2; also elsewhere on the board
/Headstage IO/B5.E_{3}: R94.1, R98.2; also elsewhere on the board
/Headstage IO/B5.E_{4}: R99.1, R103.2; also elsewhere on the board
/Headstage IO/B5.E_{5}: R100.1, R104.2; also elsewhere on the board
/Headstage IO/B5.E_{6}: R101.1, R105.2; also elsewhere on the board
/Headstage IO/B5.E_{7}: R102.1, R106.2; also elsewhere on the board
/Headstage IO/B6.E_{0}: R107.1, R111.2; also elsewhere on the board
/Headstage IO/B6.E_{1}: R108.1, R112.2; also elsewhere on the board
/Headstage IO/B6.E_{2}: R109.1, R113.2; also elsewhere on the board
/Headstage IO/B6.E_{3}: R110.1, R114.2; also elsewhere on the board
/Headstage IO/B6.E_{4}: R115.1, R119.2; also elsewhere on the board
/Headstage IO/B6.E_{5}: R116.1, R120.2; also elsewhere on the board
/Headstage IO/B6.E_{6}: R117.1, R121.2; also elsewhere on the board
/Headstage IO/B6.E_{7}: R118.1, R122.2; also elsewhere on the board
/Headstage IO/B7.E_{0}: R123.1, R127.2; also elsewhere on the board
/Headstage IO/B7.E_{1}: R124.1, R128.2; also elsewhere on the board
/Headstage IO/B7.E_{2}: R125.1, R129.2; also elsewhere on the board
/Headstage IO/B7.E_{3}: R126.1, R130.2; also elsewhere on the board
/Headstage IO/B7.E_{4}: R131.1, R135.2; also elsewhere on the board
/Headstage IO/B7.E_{5}: R132.1, R136.2; also elsewhere on the board
/Headstage IO/B7.E_{6}: R133.1, R137.2; also elsewhere on the board
/Headstage IO/B7.E_{7}: R134.1, R138.2; also elsewhere on the board
/Headstage IO/B8.E_{0}: R139.1, R143.2; also elsewhere on the board
/Headstage IO/B8.E_{1}: R140.1, R144.2; also elsewhere on the board
/Headstage IO/B8.E_{2}: R141.1, R145.2; also elsewhere on the board
/Headstage IO/B8.E_{3}: R142.1, R146.2; also elsewhere on the board
/Headstage IO/B8.E_{4}: R147.1, R151.2; also elsewhere on the board
/Headstage IO/B8.E_{5}: R148.1, R152.2; also elsewhere on the board
/Headstage IO/B8.E_{6}: R149.1, R153.2; also elsewhere on the board
/Headstage IO/B8.E_{7}: R150.1, R154.2; also elsewhere on the board
/Headstage IO/B9.E_{0}: R155.1, R159.2; also elsewhere on the board
/Headstage IO/B9.E_{1}: R156.1, R160.2; also elsewhere on the board
/Headstage IO/B9.E_{2}: R157.1, R161.2; also elsewhere on the board
/Headstage IO/B9.E_{3}: R158.1, R162.2; also elsewhere on the board
/Headstage IO/B9.E_{4}: R163.1, R167.2; also elsewhere on the board
/Headstage IO/B9.E_{5}: R164.1, R168.2; also elsewhere on the board
/Headstage IO/B9.E_{6}: R165.1, R169.2; also elsewhere on the board
/Headstage IO/B9.E_{7}: R166.1, R170.2; also elsewhere on the board
/Headstage IO/B10.E_{0}: R171.1, R175.2; also elsewhere on the board
/Headstage IO/B10.E_{1}: R172.1, R176.2; also elsewhere on the board
/Headstage IO/B10.E_{2}: R173.1, R177.2; also elsewhere on the board
/Headstage IO/B10.E_{3}: R174.1, R178.2; also elsewhere on the board
/Headstage IO/B10.E_{4}: R179.1, R183.2; also elsewhere on the board
/Headstage IO/B10.E_{5}: R180.1, R184.2; also elsewhere on the board
/Headstage IO/B10.E_{6}: R181.1, R185.2; also elsewhere on the board
/Headstage IO/B10.E_{7}: R182.1, R186.2; also elsewhere on the board
/Headstage IO/B11.E_{0}: R187.1, R191.2; also elsewhere on the board
/Headstage IO/B11.E_{1}: R188.1, R192.2; also elsewhere on the board
/Headstage IO/B11.E_{2}: R189.1, R193.2; also elsewhere on the board
/Headstage IO/B11.E_{3}: R190.1, R194.2; also elsewhere on the board
/Headstage IO/B11.E_{4}: R195.1, R199.2; also elsewhere on the board
/Headstage IO/B11.E_{5}: R196.1, R200.2; also elsewhere on the board
/Headstage IO/B11.E_{6}: R197.1, R201.2; also elsewhere on the board
/Headstage IO/B11.E_{7}: R198.1, R202.2; also elsewhere on the board
/Headstage IO/B12.E_{0}: R203.1, R207.2; also elsewhere on the board
/Headstage IO/B12.E_{1}: R204.1, R208.2; also elsewhere on the board
/Headstage IO/B12.E_{2}: R205.1, R209.2; also elsewhere on the board
/Headstage IO/B12.E_{3}: R206.1, R210.2; also elsewhere on the board
/Headstage IO/B12.E_{4}: R211.1, R215.2; also elsewhere on the board
/Headstage IO/B12.E_{5}: R212.1, R216.2; also elsewhere on the board
/Headstage IO/B12.E_{6}: R213.1, R217.2; also elsewhere on the board
/Headstage IO/B12.E_{7}: R214.1, R218.2; also elsewhere on the board
/Headstage IO/B13.E_{0}: R219.1, R223.2; also elsewhere on the board
/Headstage IO/B13.E_{1}: R220.1, R224.2; also elsewhere on the board
/Headstage IO/B13.E_{2}: R221.1, R225.2; also elsewhere on the board
/Headstage IO/B13.E_{3}: R222.1, R226.2; also elsewhere on the board
/Headstage IO/B13.E_{4}: R227.1, R231.2; also elsewhere on the board
/Headstage IO/B13.E_{5}: R228.1, R232.2; also elsewhere on the board
/Headstage IO/B13.E_{6}: R229.1, R233.2; also elsewhere on the board
/Headstage IO/B13.E_{7}: R230.1, R234.2; also elsewhere on the board
/Headstage IO/B14.E_{0}: R235.1, R239.2; also elsewhere on the board
/Headstage IO/B14.E_{1}: R236.1, R240.2; also elsewhere on the board
/Headstage IO/B14.E_{2}: R237.1, R241.2; also elsewhere on the board
/Headstage IO/B14.E_{3}: R238.1, R242.2; also elsewhere on the board
/Headstage IO/B14.E_{4}: R243.1, R247.2; also elsewhere on the board
/Headstage IO/B14.E_{5}: R244.1, R248.2; also elsewhere on the board
/Headstage IO/B14.E_{6}: R245.1, R249.2; also elsewhere on the board
/Headstage IO/B14.E_{7}: R246.1, R250.2; also elsewhere on the board
/Headstage IO/B15.E_{0}: R251.1, R255.2; also elsewhere on the board
/Headstage IO/B15.E_{1}: R252.1, R256.2; also elsewhere on the board
/Headstage IO/B15.E_{2}: R253.1, R257.2; also elsewhere on the board
/Headstage IO/B15.E_{3}: R254.1, R258.2; also elsewhere on the board
/Headstage IO/B15.E_{4}: R259.1, R263.2; also elsewhere on the board
/Headstage IO/B15.E_{5}: R260.1, R264.2; also elsewhere on the board
/Headstage IO/B15.E_{6}: R261.1, R265.2; also elsewhere on the board
/Headstage IO/B15.E_{7}: R262.1, R266.2; also elsewhere on the board
/Signal Routing 0/SR_{OUT}: U12.14 (SER); also elsewhere on the board
/Signal Routing 1/SR_{OUT}: U12.9 (Q_{H'}), U17.14 (SER)
/Signal Routing 1/S_{0}: U8.C1, U12.15 (Q_{A})
/Signal Routing 1/S_{1}: U8.C3, U12.1 (Q_{B})
/Signal Routing 1/S_{2}: U9.C1, U12.2 (Q_{C})
/Signal Routing 1/S_{3}: U9.C3, U12.3 (Q_{D})
/Signal Routing 1/S_{4}: U10.C1, U12.4 (Q_{E})
/Signal Routing 1/S_{5}: U10.C3, U12.5 (Q_{F})
/Signal Routing 1/S_{6}: U11.C1, U12.6 (Q_{G})
/Signal Routing 1/S_{7}: U11.C3, U12.7 (Q_{H})
/Signal Routing 2/SR_{OUT}: U17.9 (Q_{H'}), U22.14 (SER)
/Signal Routing 2/S_{0}: U13.C1, U17.15 (Q_{A})
/Signal Routing 2/S_{1}: U13.C3, U17.1 (Q_{B})
/Signal Routing 2/S_{2}: U14.C1, U17.2 (Q_{C})
/Signal Routing 2/S_{3}: U14.C3, U17.3 (Q_{D})
/Signal Routing 2/S_{4}: U15.C1, U17.4 (Q_{E})
/Signal Routing 2/S_{5}: U15.C3, U17.5 (Q_{F})
/Signal Routing 2/S_{6}: U16.C1, U17.6 (Q_{G})
/Signal Routing 2/S_{7}: U16.C3, U17.7 (Q_{H})
/Signal Routing 3/SR_{OUT}: U22.9 (Q_{H'}), U27.14 (SER)
/Signal Routing 3/S_{0}: U18.C1, U22.15 (Q_{A})
/Signal Routing 3/S_{1}: U18.C3, U22.1 (Q_{B})
/Signal Routing 3/S_{2}: U19.C1, U22.2 (Q_{C})
/Signal Routing 3/S_{3}: U19.C3, U22.3 (Q_{D})
/Signal Routing 3/S_{4}: U20.C1, U22.4 (Q_{E})
/Signal Routing 3/S_{5}: U20.C3, U22.5 (Q_{F})
/Signal Routing 3/S_{6}: U21.C1, U22.6 (Q_{G})
/Signal Routing 3/S_{7}: U21.C3, U22.7 (Q_{H})
/Signal Routing 4/SR_{OUT}: U27.9 (Q_{H'}), U32.14 (SER)
/Signal Routing 4/S_{0}: U23.C1, U27.15 (Q_{A})
/Signal Routing 4/S_{1}: U23.C3, U27.1 (Q_{B})
/Signal Routing 4/S_{2}: U24.C1, U27.2 (Q_{C})
/Signal Routing 4/S_{3}: U24.C3, U27.3 (Q_{D})
/Signal Routing 4/S_{4}: U25.C1, U27.4 (Q_{E})
/Signal Routing 4/S_{5}: U25.C3, U27.5 (Q_{F})
/Signal Routing 4/S_{6}: U26.C1, U27.6 (Q_{G})
/Signal Routing 4/S_{7}: U26.C3, U27.7 (Q_{H})
/Signal Routing 5/SR_{OUT}: U32.9 (Q_{H'}), U37.14 (SER)
/Signal Routing 5/S_{0}: U28.C1, U32.15 (Q_{A})
/Signal Routing 5/S_{1}: U28.C3, U32.1 (Q_{B})
/Signal Routing 5/S_{2}: U29.C1, U32.2 (Q_{C})
/Signal Routing 5/S_{3}: U29.C3, U32.3 (Q_{D})
/Signal Routing 5/S_{4}: U30.C1, U32.4 (Q_{E})
/Signal Routing 5/S_{5}: U30.C3, U32.5 (Q_{F})
/Signal Routing 5/S_{6}: U31.C1, U32.6 (Q_{G})
/Signal Routing 5/S_{7}: U31.C3, U32.7 (Q_{H})
/Signal Routing 6/SR_{OUT}: U37.9 (Q_{H'}), U42.14 (SER)
/Signal Routing 6/S_{0}: U33.C1, U37.15 (Q_{A})
/Signal Routing 6/S_{1}: U33.C3, U37.1 (Q_{B})
/Signal Routing 6/S_{2}: U34.C1, U37.2 (Q_{C})
/Signal Routing 6/S_{3}: U34.C3, U37.3 (Q_{D})
/Signal Routing 6/S_{4}: U35.C1, U37.4 (Q_{E})
/Signal Routing 6/S_{5}: U35.C3, U37.5 (Q_{F})
/Signal Routing 6/S_{6}: U36.C1, U37.6 (Q_{G})
/Signal Routing 6/S_{7}: U36.C3, U37.7 (Q_{H})
/Signal Routing 7/SR_{OUT}: U42.9 (Q_{H'}), U47.14 (SER)
/Signal Routing 7/S_{0}: U38.C1, U42.15 (Q_{A})
/Signal Routing 7/S_{1}: U38.C3, U42.1 (Q_{B})
/Signal Routing 7/S_{2}: U39.C1, U42.2 (Q_{C})
/Signal Routing 7/S_{3}: U39.C3, U42.3 (Q_{D})
/Signal Routing 7/S_{4}: U40.C1, U42.4 (Q_{E})
/Signal Routing 7/S_{5}: U40.C3, U42.5 (Q_{F})
/Signal Routing 7/S_{6}: U41.C1, U42.6 (Q_{G})
/Signal Routing 7/S_{7}: U41.C3, U42.7 (Q_{H})
/Signal Routing 8/SR_{OUT}: U47.9 (Q_{H'}), U52.14 (SER)
/Signal Routing 8/S_{0}: U43.C1, U47.15 (Q_{A})
/Signal Routing 8/S_{1}: U43.C3, U47.1 (Q_{B})
/Signal Routing 8/S_{2}: U44.C1, U47.2 (Q_{C})
/Signal Routing 8/S_{3}: U44.C3, U47.3 (Q_{D})
/Signal Routing 8/S_{4}: U45.C1, U47.4 (Q_{E})
/Signal Routing 8/S_{5}: U45.C3, U47.5 (Q_{F})
/Signal Routing 8/S_{6}: U46.C1, U47.6 (Q_{G})
/Signal Routing 8/S_{7}: U46.C3, U47.7 (Q_{H})
/Signal Routing 9/S_{0}: U48.C1, U52.15 (Q_{A})
/Signal Routing 9/S_{1}: U48.C3, U52.1 (Q_{B})
/Signal Routing 9/S_{2}: U49.C1, U52.2 (Q_{C})
/Signal Routing 9/S_{3}: U49.C3, U52.3 (Q_{D})
/Signal Routing 9/S_{4}: U50.C1, U52.4 (Q_{E})
/Signal Routing 9/S_{5}: U50.C3, U52.5 (Q_{F})
/Signal Routing 9/S_{6}: U51.C1, U52.6 (Q_{G})
/Signal Routing 9/S_{7}: U51.C3, U52.7 (Q_{H})
/Signal Routing 10/SR_{IN}: U52.9 (Q_{H'}), U57.14 (SER)
/Signal Routing 10/SR_{OUT}: U57.9 (Q_{H'}), U62.14 (SER)
/Signal Routing 10/S_{0}: U53.C1, U57.15 (Q_{A})
/Signal Routing 10/S_{1}: U53.C3, U57.1 (Q_{B})
/Signal Routing 10/S_{2}: U54.C1, U57.2 (Q_{C})
/Signal Routing 10/S_{3}: U54.C3, U57.3 (Q_{D})
/Signal Routing 10/S_{4}: U55.C1, U57.4 (Q_{E})
/Signal Routing 10/S_{5}: U55.C3, U57.5 (Q_{F})
/Signal Routing 10/S_{6}: U56.C1, U57.6 (Q_{G})
/Signal Routing 10/S_{7}: U56.C3, U57.7 (Q_{H})
/Signal Routing 11/SR_{OUT}: U62.9 (Q_{H'}), U67.14 (SER)
/Signal Routing 11/S_{0}: U58.C1, U62.15 (Q_{A})
/Signal Routing 11/S_{1}: U58.C3, U62.1 (Q_{B})
/Signal Routing 11/S_{2}: U59.C1, U62.2 (Q_{C})
/Signal Routing 11/S_{3}: U59.C3, U62.3 (Q_{D})
/Signal Routing 11/S_{4}: U60.C1, U62.4 (Q_{E})
/Signal Routing 11/S_{5}: U60.C3, U62.5 (Q_{F})
/Signal Routing 11/S_{6}: U61.C1, U62.6 (Q_{G})
/Signal Routing 11/S_{7}: U61.C3, U62.7 (Q_{H})
/Signal Routing 12/SR_{OUT}: U67.9 (Q_{H'}), U72.14 (SER)
/Signal Routing 12/S_{0}: U63.C1, U67.15 (Q_{A})
/Signal Routing 12/S_{1}: U63.C3, U67.1 (Q_{B})
/Signal Routing 12/S_{2}: U64.C1, U67.2 (Q_{C})
/Signal Routing 12/S_{3}: U64.C3, U67.3 (Q_{D})
/Signal Routing 12/S_{4}: U65.C1, U67.4 (Q_{E})
/Signal Routing 12/S_{5}: U65.C3, U67.5 (Q_{F})
/Signal Routing 12/S_{6}: U66.C1, U67.6 (Q_{G})
/Signal Routing 12/S_{7}: U66.C3, U67.7 (Q_{H})
/Signal Routing 13/SR_{OUT}: U72.9 (Q_{H'}), U77.14 (SER)
/Signal Routing 13/S_{0}: U68.C1, U72.15 (Q_{A})
/Signal Routing 13/S_{1}: U68.C3, U72.1 (Q_{B})
/Signal Routing 13/S_{2}: U69.C1, U72.2 (Q_{C})
/Signal Routing 13/S_{3}: U69.C3, U72.3 (Q_{D})
/Signal Routing 13/S_{4}: U70.C1, U72.4 (Q_{E})
/Signal Routing 13/S_{5}: U70.C3, U72.5 (Q_{F})
/Signal Routing 13/S_{6}: U71.C1, U72.6 (Q_{G})
/Signal Routing 13/S_{7}: U71.C3, U72.7 (Q_{H})
/Signal Routing 14/SR_{OUT}: U77.9 (Q_{H'}), U82.14 (SER)
/Signal Routing 14/S_{0}: U73.C1, U77.15 (Q_{A})
/Signal Routing 14/S_{1}: U73.C3, U77.1 (Q_{B})
/Signal Routing 14/S_{2}: U74.C1, U77.2 (Q_{C})
/Signal Routing 14/S_{3}: U74.C3, U77.3 (Q_{D})
/Signal Routing 14/S_{4}: U75.C1, U77.4 (Q_{E})
/Signal Routing 14/S_{5}: U75.C3, U77.5 (Q_{F})
/Signal Routing 14/S_{6}: U76.C1, U77.6 (Q_{G})
/Signal Routing 14/S_{7}: U76.C3, U77.7 (Q_{H})
/Signal Routing 15/SR_{OUT}: U82.9 (Q_{H'})
/Signal Routing 15/S_{0}: U78.C1, U82.15 (Q_{A})
/Signal Routing 15/S_{1}: U78.C3, U82.1 (Q_{B})
/Signal Routing 15/S_{2}: U79.C1, U82.2 (Q_{C})
/Signal Routing 15/S_{3}: U79.C3, U82.3 (Q_{D})
/Signal Routing 15/S_{4}: U80.C1, U82.4 (Q_{E})
/Signal Routing 15/S_{5}: U80.C3, U82.5 (Q_{F})
/Signal Routing 15/S_{6}: U81.C1, U82.6 (Q_{G})
/Signal Routing 15/S_{7}: U81.C3, U82.7 (Q_{H})
GND: C21.2, C22.2, C23.2, C24.2, C25.2, C26.2, C27.2, C28.2, C29.2, C30.2, C31.2, C32.2, C33.2, C34.2, C35.2, C36.2, C37.2, C38.2, C39.2, C40.2, C41.2, C42.2, C43.2, C44.2, C45.2, C46.2, C47.2, C48.2, C49.2, C50.2, C51.2, C52.2, C53.2, C54.2, C55.2, C56.2, C57.2, C58.2, C59.2, C60.2, C61.2, C62.2, C63.2, C64.2, C65.2, C66.2, C67.2, C68.2, C69.2, C70.2, C71.2, C72.2, C73.2, C74.2, C75.2, C76.2, C77.2, C78.2, C79.2, C80.2, C81.2, C82.2, C83.2, C84.2, C85.2, C86.2, C87.2, C88.2, C89.2, C90.2, C91.2, C92.2, C93.2, C94.2, C95.2, R27.2, R28.2, R29.2, R30.2, R35.2, R36.2, R37.2, R38.2, R43.2, R44.2, R45.2, R46.2, R51.2, R52.2, R53.2, R54.2, R59.2, R60.2, R61.2, R62.2, R67.2, R68.2, R69.2, R70.2, R75.2, R76.2, R77.2, R78.2, R83.2, R84.2, R85.2, R86.2, R91.2, R92.2, R93.2, R94.2, R99.2, R100.2, R101.2, R102.2, R107.2, R108.2, R109.2, R110.2, R115.2, R116.2, R117.2, R118.2, R123.2, R124.2, R125.2, R126.2, R131.2, R132.2, R133.2, R134.2, R139.2, R140.2, R141.2, R142.2, R147.2, R148.2, R149.2, R150.2, R155.2, R156.2, R157.2, R158.2, R163.2, R164.2, R165.2, R166.2, R171.2, R172.2, R173.2, R174.2, R179.2, R180.2, R181.2, R182.2, R187.2, R188.2, R189.2, R190.2, R195.2, R196.2, R197.2, R198.2, R203.2, R204.2, R205.2, R206.2, R211.2, R212.2, R213.2, R214.2, R219.2, R220.2, R221.2, R222.2, R227.2, R228.2, R229.2, R230.2, R235.2, R236.2, R237.2, R238.2, R243.2, R244.2, R245.2, R246.2, R251.2, R252.2, R253.2, R254.2, R259.2, R260.2, R261.2, R262.2, U8.C2 (GND), U9.C2 (GND), U10.C2 (GND), U11.C2 (GND), U12.8 (GND), U12.13 (~OE), U13.C2 (GND), U14.C2 (GND), U15.C2 (GND), U16.C2 (GND), U17.8 (GND), U17.13 (~OE), U18.C2 (GND), U19.C2 (GND), U20.C2 (GND), U21.C2 (GND), U22.8 (GND), U22.13 (~OE), U23.C2 (GND), U24.C2 (GND), U25.C2 (GND), U26.C2 (GND), U27.8 (GND), U27.13 (~OE), U28.C2 (GND), U29.C2 (GND), U30.C2 (GND), U31.C2 (GND), U32.8 (GND), U32.13 (~OE), U33.C2 (GND), U34.C2 (GND), U35.C2 (GND), U36.C2 (GND), U37.8 (GND), U37.13 (~OE), U38.C2 (GND), U39.C2 (GND), U40.C2 (GND), U41.C2 (GND), U42.8 (GND), U42.13 (~OE), U43.C2 (GND), U44.C2 (GND), U45.C2 (GND), U46.C2 (GND), U47.8 (GND), U47.13 (~OE), U48.C2 (GND), U49.C2 (GND), U50.C2 (GND), U51.C2 (GND), U52.8 (GND), U52.13 (~OE), U53.C2 (GND), U54.C2 (GND), U55.C2 (GND), U56.C2 (GND), U57.8 (GND), U57.13 (~OE), U58.C2 (GND), U59.C2 (GND), U60.C2 (GND), U61.C2 (GND), U62.8 (GND), U62.13 (~OE), U63.C2 (GND), U64.C2 (GND), U65.C2 (GND), U66.C2 (GND), U67.8 (GND), U67.13 (~OE), U68.C2 (GND), U69.C2 (GND), U70.C2 (GND), U71.C2 (GND), U72.8 (GND), U72.13 (~OE), U73.C2 (GND), U74.C2 (GND), U75.C2 (GND), U76.C2 (GND), U77.8 (GND), U77.13 (~OE), U78.C2 (GND), U79.C2 (GND), U80.C2 (GND), U81.C2 (GND), U82.8 (GND), U82.13 (~OE); also elsewhere on the board
unnamed: R31.1, U8.A3
unnamed: R32.1, U8.B3
unnamed: R33.1, U9.A3
unnamed: R34.1, U9.B3
unnamed: R39.1, U10.A3
unnamed: R40.1, U10.B3
unnamed: R41.1, U11.A3
unnamed: R42.1, U11.B3
unnamed: R47.1, U13.A3
unnamed: R48.1, U13.B3
unnamed: R49.1, U14.A3
unnamed: R50.1, U14.B3
unnamed: R55.1, U15.A3
unnamed: R56.1, U15.B3
unnamed: R57.1, U16.A3
unnamed: R58.1, U16.B3
unnamed: R63.1, U18.A3
unnamed: R64.1, U18.B3
unnamed: R65.1, U19.A3
unnamed: R66.1, U19.B3
unnamed: R71.1, U20.A3
unnamed: R72.1, U20.B3
unnamed: R73.1, U21.A3
unnamed: R74.1, U21.B3
unnamed: R79.1, U23.A3
unnamed: R80.1, U23.B3
unnamed: R81.1, U24.A3
unnamed: R82.1, U24.B3
unnamed: R87.1, U25.A3
unnamed: R88.1, U25.B3
unnamed: R89.1, U26.A3
unnamed: R90.1, U26.B3
unnamed: R95.1, U28.A3
unnamed: R96.1, U28.B3
unnamed: R97.1, U29.A3
unnamed: R98.1, U29.B3
unnamed: R103.1, U30.A3
unnamed: R104.1, U30.B3
unnamed: R105.1, U31.A3
unnamed: R106.1, U31.B3
unnamed: R111.1, U33.A3
unnamed: R112.1, U33.B3
unnamed: R113.1, U34.A3
unnamed: R114.1, U34.B3
unnamed: R119.1, U35.A3
unnamed: R120.1, U35.B3
unnamed: R121.1, U36.A3
unnamed: R122.1, U36.B3
unnamed: R127.1, U38.A3
unnamed: R128.1, U38.B3
unnamed: R129.1, U39.A3
unnamed: R130.1, U39.B3
unnamed: R135.1, U40.A3
unnamed: R136.1, U40.B3
unnamed: R137.1, U41.A3
unnamed: R138.1, U41.B3
unnamed: R143.1, U43.A3
unnamed: R144.1, U43.B3
unnamed: R145.1, U44.A3
unnamed: R146.1, U44.B3
unnamed: R151.1, U45.A3
unnamed: R152.1, U45.B3
unnamed: R153.1, U46.A3
unnamed: R154.1, U46.B3
unnamed: R159.1, U48.A3
unnamed: R160.1, U48.B3
unnamed: R161.1, U49.A3
unnamed: R162.1, U49.B3
unnamed: R167.1, U50.A3
unnamed: R168.1, U50.B3
unnamed: R169.1, U51.A3
unnamed: R170.1, U51.B3
unnamed: R175.1, U53.A3
unnamed: R176.1, U53.B3
unnamed: R177.1, U54.A3
unnamed: R178.1, U54.B3
unnamed: R183.1, U55.A3
unnamed: R184.1, U55.B3
unnamed: R185.1, U56.A3
unnamed: R186.1, U56.B3
unnamed: R191.1, U58.A3
unnamed: R192.1, U58.B3
unnamed: R193.1, U59.A3
unnamed: R194.1, U59.B3
unnamed: R199.1, U60.A3
unnamed: R200.1, U60.B3
unnamed: R201.1, U61.A3
unnamed: R202.1, U61.B3
unnamed: R207.1, U63.A3
unnamed: R208.1, U63.B3
unnamed: R209.1, U64.A3
unnamed: R210.1, U64.B3
unnamed: R215.1, U65.A3
unnamed: R216.1, U65.B3
unnamed: R217.1, U66.A3
unnamed: R218.1, U66.B3
unnamed: R223.1, U68.A3
unnamed: R224.1, U68.B3
unnamed: R225.1, U69.A3
unnamed: R226.1, U69.B3
unnamed: R231.1, U70.A3
unnamed: R232.1, U70.B3
unnamed: R233.1, U71.A3
unnamed: R234.1, U71.B3
unnamed: R239.1, U73.A3
unnamed: R240.1, U73.B3
unnamed: R241.1, U74.A3
unnamed: R242.1, U74.B3
unnamed: R247.1, U75.A3
unnamed: R248.1, U75.B3
unnamed: R249.1, U76.A3
unnamed: R250.1, U76.B3
unnamed: R255.1, U78.A3
unnamed: R256.1, U78.B3
unnamed: R257.1, U79.A3
unnamed: R258.1, U79.B3
unnamed: R263.1, U80.A3
unnamed: R264.1, U80.B3
unnamed: R265.1, U81.A3
unnamed: R266.1, U81.B3
SR_{RCLK}: U12.12 (RCLK), U17.12 (RCLK), U22.12 (RCLK), U27.12 (RCLK), U32.12 (RCLK), U37.12 (RCLK), U42.12 (RCLK), U47.12 (RCLK), U52.12 (RCLK), U57.12 (RCLK), U62.12 (RCLK), U67.12 (RCLK), U72.12 (RCLK), U77.12 (RCLK), U82.12 (RCLK); also elsewhere on the board
SR_{SRCLK}: U12.11 (SRCLK), U17.11 (SRCLK), U22.11 (SRCLK), U27.11 (SRCLK), U32.11 (SRCLK), U37.11 (SRCLK), U42.11 (SRCLK), U47.11 (SRCLK), U52.11 (SRCLK), U57.11 (SRCLK), U62.11 (SRCLK), U67.11 (SRCLK), U72.11 (SRCLK), U77.11 (SRCLK), U82.11 (SRCLK); also elsewhere on the board
SR_{~SRCLR}: U12.10 (~SRCLR), U17.10 (~SRCLR), U22.10 (~SRCLR), U27.10 (~SRCLR), U32.10 (~SRCLR), U37.10 (~SRCLR), U42.10 (~SRCLR), U47.10 (~SRCLR), U52.10 (~SRCLR), U57.10 (~SRCLR), U62.10 (~SRCLR), U67.10 (~SRCLR), U72.10 (~SRCLR), U77.10 (~SRCLR), U82.10 (~SRCLR); also elsewhere on the board
TESTSIG: U8.A1, U8.B1, U9.A1, U9.B1, U10.A1, U10.B1, U11.A1, U11.B1, U13.A1, U13.B1, U14.A1, U14.B1, U15.A1, U15.B1, U16.A1, U16.B1, U18.A1, U18.B1, U19.A1, U19.B1, U20.A1, U20.B1, U21.A1, U21.B1, U23.A1, U23.B1, U24.A1, U24.B1, U25.A1, U25.B1, U26.A1, U26.B1, U28.A1, U28.B1, U29.A1, U29.B1, U30.A1, U30.B1, U31.A1, U31.B1, U33.A1, U33.B1, U34.A1, U34.B1, U35.A1, U35.B1, U36.A1, U36.B1, U38.A1, U38.B1, U39.A1, U39.B1, U40.A1, U40.B1, U41.A1, U41.B1, U43.A1, U43.B1, U44.A1, U44.B1, U45.A1, U45.B1, U46.A1, U46.B1, U48.A1, U48.B1, U49.A1, U49.B1, U50.A1, U50.B1, U51.A1, U51.B1, U53.A1, U53.B1, U54.A1, U54.B1, U55.A1, U55.B1, U56.A1, U56.B1, U58.A1, U58.B1, U59.A1, U59.B1, U60.A1, U60.B1, U61.A1, U61.B1, U63.A1, U63.B1, U64.A1, U64.B1, U65.A1, U65.B1, U66.A1, U66.B1, U68.A1, U68.B1, U69.A1, U69.B1, U70.A1, U70.B1, U71.A1, U71.B1, U73.A1, U73.B1, U74.A1, U74.B1, U75.A1, U75.B1, U76.A1, U76.B1, U78.A1, U78.B1, U79.A1, U79.B1, U80.A1, U80.B1, U81.A1, U81.B1; also elsewhere on the board
VCC: C21.1, C22.1, C23.1, C24.1, C25.1, C26.1, C27.1, C28.1, C29.1, C30.1, C31.1, C32.1, C33.1, C34.1, C35.1, C36.1, C37.1, C38.1, C39.1, C40.1, C41.1, C42.1, C43.1, C44.1, C45.1, C46.1, C47.1, C48.1, C49.1, C50.1, C51.1, C52.1, C53.1, C54.1, C55.1, C56.1, C57.1, C58.1, C59.1, C60.1, C61.1, C62.1, C63.1, C64.1, C65.1, C66.1, C67.1, C68.1, C69.1, C70.1, C71.1, C72.1, C73.1, C74.1, C75.1, C76.1, C77.1, C78.1, C79.1, C80.1, C81.1, C82.1, C83.1, C84.1, C85.1, C86.1, C87.1, C88.1, C89.1, C90.1, C91.1, C92.1, C93.1, C94.1, C95.1, U8.A2 (VCC), U9.A2 (VCC), U10.A2 (VCC), U11.A2 (VCC), U12.16 (VCC), U13.A2 (VCC), U14.A2 (VCC), U15.A2 (VCC), U16.A2 (VCC), U17.16 (VCC), U18.A2 (VCC), U19.A2 (VCC), U20.A2 (VCC), U21.A2 (VCC), U22.16 (VCC), U23.A2 (VCC), U24.A2 (VCC), U25.A2 (VCC), U26.A2 (VCC), U27.16 (VCC), U28.A2 (VCC), U29.A2 (VCC), U30.A2 (VCC), U31.A2 (VCC), U32.16 (VCC), U33.A2 (VCC), U34.A2 (VCC), U35.A2 (VCC), U36.A2 (VCC), U37.16 (VCC), U38.A2 (VCC), U39.A2 (VCC), U40.A2 (VCC), U41.A2 (VCC), U42.16 (VCC), U43.A2 (VCC), U44.A2 (VCC), U45.A2 (VCC), U46.A2 (VCC), U47.16 (VCC), U48.A2 (VCC), U49.A2 (VCC), U50.A2 (VCC), U51.A2 (VCC), U52.16 (VCC), U53.A2 (VCC), U54.A2 (VCC), U55.A2 (VCC), U56.A2 (VCC), U57.16 (VCC), U58.A2 (VCC), U59.A2 (VCC), U60.A2 (VCC), U61.A2 (VCC), U62.16 (VCC), U63.A2 (VCC), U64.A2 (VCC), U65.A2 (VCC), U66.A2 (VCC), U67.16 (VCC), U68.A2 (VCC), U69.A2 (VCC), U70.A2 (VCC), U71.A2 (VCC), U72.16 (VCC), U73.A2 (VCC), U74.A2 (VCC), U75.A2 (VCC), U76.A2 (VCC), U77.16 (VCC), U78.A2 (VCC), U79.A2 (VCC), U80.A2 (VCC), U81.A2 (VCC), U82.16 (VCC); also elsewhere on the board

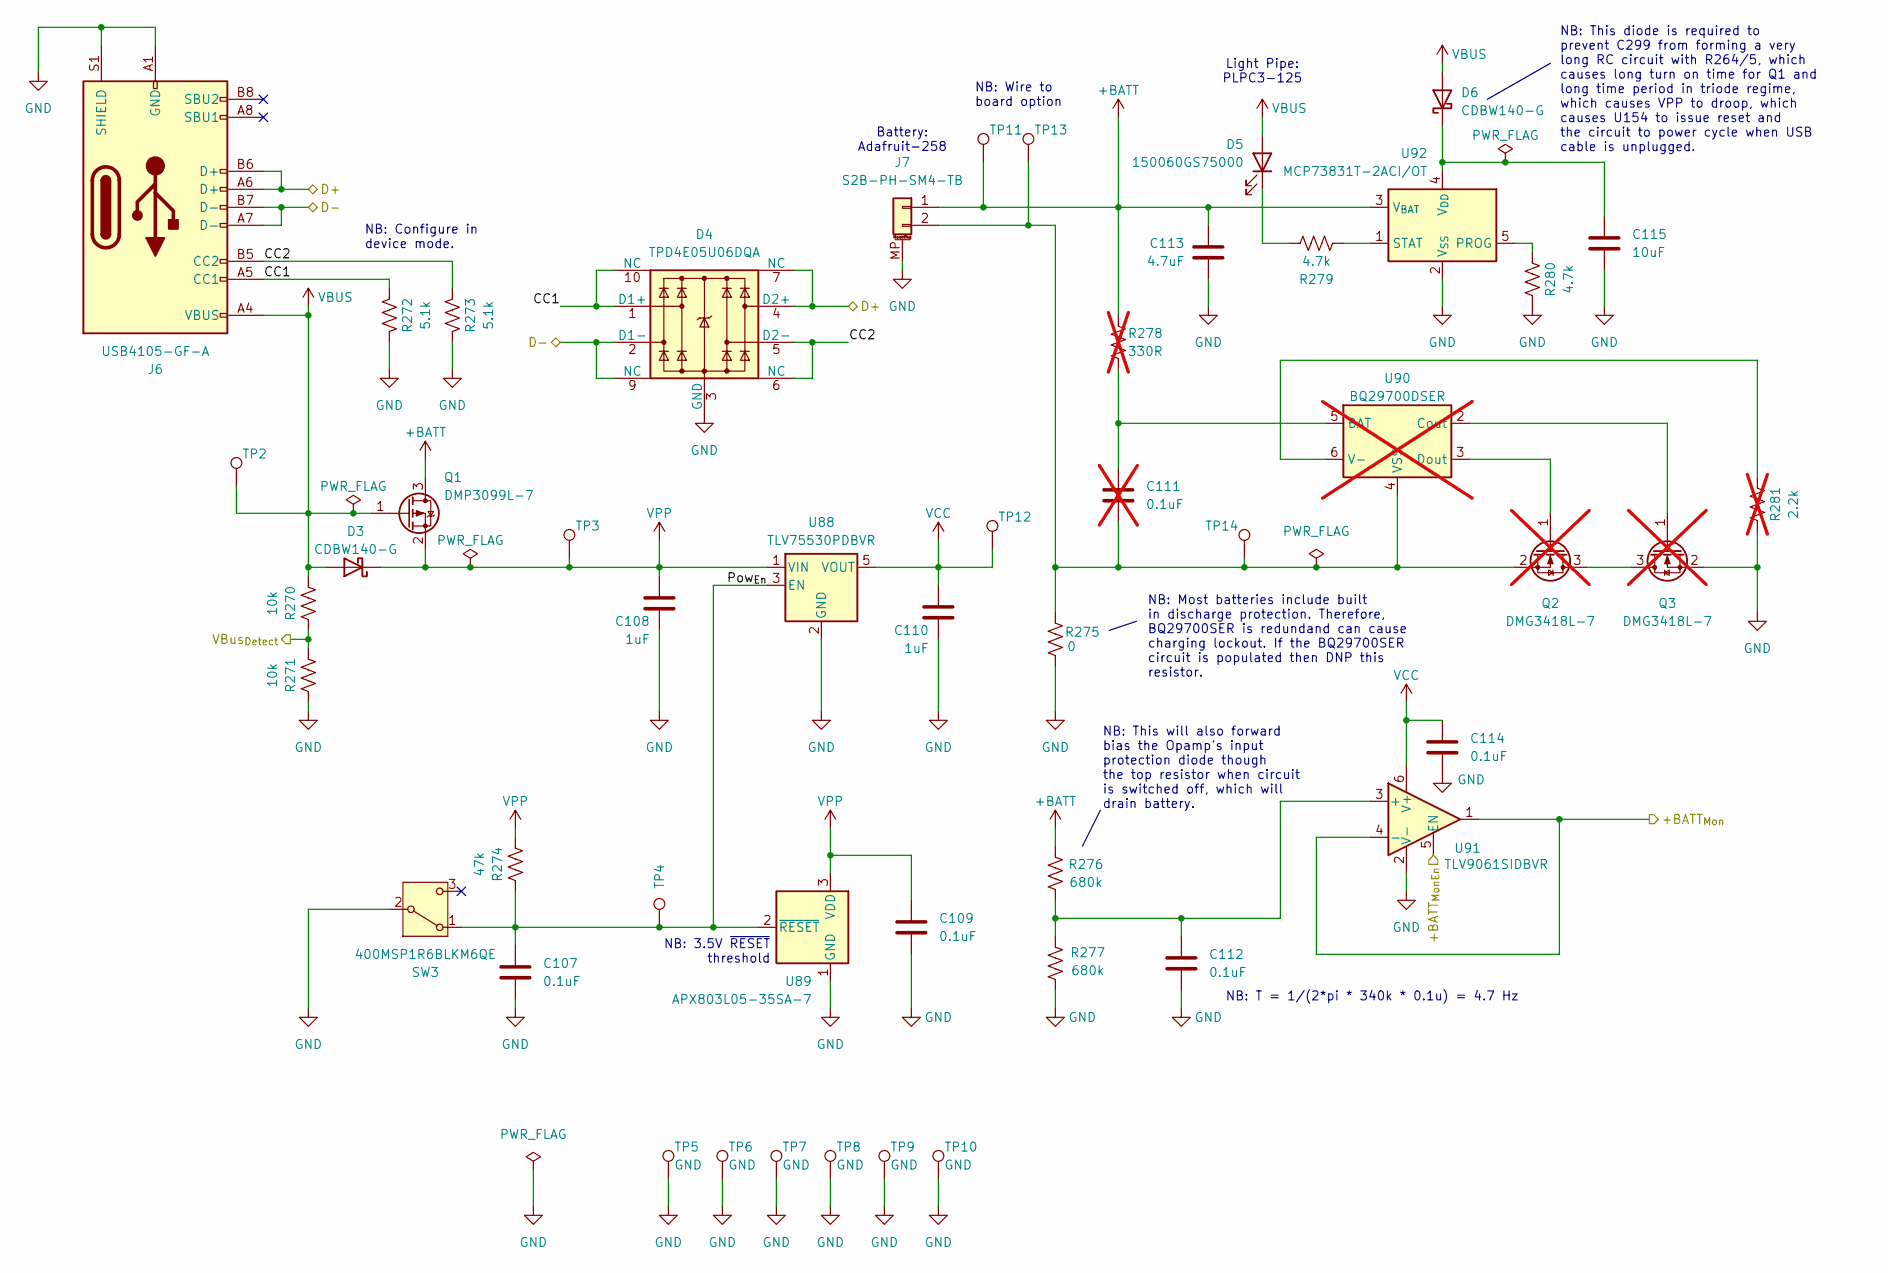
[picture p48: schematic usb.kicad_sch, Extracellular Electrophysiology Test Board]

Parts:
C107, C109, C112, C114: 0.1uF; C_0402_1005Metric; Voltage 25V; MPN C1005X7R1E104K050BB; LCSC C105883
C108, C110: 1uF; C_0603_1608Metric; Voltage 16V; MPN CL10A105KA8NNNC; LCSC C5673
C111: 0.1uF; C_0402_1005Metric; Voltage 25V; MPN C1005X7R1E104K050BB; not fitted
C113: 4.7uF; C_1206_3216Metric; Voltage 16V; MPN CL31B475KOHNNNE; LCSC C51205
C115: 10uF; C_1206_3216Metric; Voltage 16V; MPN CL31B106KBHNNNE; LCSC C13585
D3, D6: CDBW140-G; D_SOD-123; MPN CDBW140-G; LCSC C82544
D4: TPD4E05U06DQA; USON-10_2.5x1.0mm_P0.5mm; MPN TPD4E05U06DQAR; LCSC C138714
D5: 150060GS75000; LED_0603_1608Metric; MPN 150060GS75000; LCSC C916074
J6: USB4105-GF-A; USB_C_Receptacle_GCT_USB4105-xx-A_16P_TopMnt_Horizontal; MPN USB4105-GF-A; LCSC C5184243
J7: S2B-PH-SM4-TB; JST_PH_S2B-PH-SM4-TB_1x02-1MP_P2.00mm_Horizontal; MPN S2B-PH-SM4-TB; LCSC C295747
Q1: DMP3099L-7; SOT-23; MPN DMP3099L-7; LCSC C155244
Q2, Q3: DMG3418L-7; SOT-23; MPN DMG3418L-7; not fitted
R270, R271: 10k; R_0402_1005Metric; MPN CRCW040210K0FKED; LCSC C60490
R272, R273: 5.1k; R_0402_1005Metric; MPN ERJ-2RKF5101X; LCSC C105872
R274: 47k; R_0402_1005Metric; MPN ERJ-2RKF4702X; LCSC C93943
R275: 0; R_0402_1005Metric; MPN RC0402JR-070RL; LCSC C106231
R276, R277: 680k; R_0402_1005Metric; MPN RC0402FR-13680KL; LCSC C2909377
R278: 330R; R_0603_1608Metric; MPN CRCW0603330RFKEAC; not fitted
R279, R280: 4.7k; R_0402_1005Metric; MPN ERJ-2RKF4701X; LCSC C105871
R281: 2.2k; R_0402_1005Metric; MPN ERJ-2RKF2201X; not fitted
SW3: 400MSP1R6BLKM6QE; ESWITCH_400MSPxR6xxxM6xE; MPN 400MSP1R6BLKM6QE; LCSC C6105831
TP2, TP3, TP4, TP5, TP6, TP7, TP8, TP9, TP10, TP14: GND; TestPoint_Pad_D2.0mm
TP11, TP13: TestPoint_THTPad_D3.0mm_Drill1.5mm
TP12: VCC; TestPoint_Pad_D2.0mm
U88: TLV75530PDBVR; SOT-23-5; MPN TLV75530PDBVR; LCSC C51118
U89: APX803L05-35SA-7; SOT-23; MPN APX803L05-35SA-7; LCSC C2067919
U90: BQ29700DSER; WSON-6_1.5x1.5mm_P0.5mm; MPN BQ29700DSER; not fitted
U91: TLV9061SIDBVR; SOT-23-6; MPN TLV9061SIDBVR; LCSC C2058350
U92: MCP73831T-2ACI/OT; SOT-23-5; MPN MCP73831T-2ACI/OT; LCSC C424093

Connections:
+BATT: C113.1, J7.1, Q1.3 (D), R276.1, R278.2, TP11.1 (1_1), U92.3 (V_{BAT})
/MCU/+BATT_{MonEn}: U91.5 (EN); also elsewhere on the board
/MCU/+BATT_{Mon}: U91.1, U91.4 (-); also elsewhere on the board
/MCU/D+: D4.4 (D2+), D4.7 (NC), J6.A6 (D+), J6.B6 (D+); also elsewhere on the board
/MCU/D-: D4.2 (D1-), D4.9 (NC), J6.A7 (D-), J6.B7 (D-); also elsewhere on the board
/MCU/VBus_{Detect}: R270.2, R271.1; also elsewhere on the board
/USB/CC1: D4.1 (D1+), D4.10 (NC), J6.A5 (CC1), R272.1
/USB/CC2: D4.5 (D2-), D4.6 (NC), J6.B5 (CC2), R273.1
/USB/Pow_{En}: C107.1, R274.2, SW3.1 (A), TP4.1 (1_1), U88.3 (EN), U89.2 (~RESET)
GND: C107.2, C108.2, C109.2, C110.2, C112.2, C113.2, C114.2, C115.2, D4.3 (GND), D4.8 (GND), J6.A1 (GND), J6.A12 (GND), J6.B1 (GND), J6.B12 (GND), J6.S1 (SHIELD), J7.MP (MountPin), Q3.2 (S), R271.2, R272.2, R273.2, R275.1, R277.2, R280.1, R281.1, SW3.2 (B), TP5.1 (1_1), TP6.1 (1_1), TP7.1 (1_1), TP8.1 (1_1), TP9.1 (1_1), TP10.1 (1_1), U88.2 (GND), U89.1 (GND), U91.2 (V-), U92.2 (V_{SS}); also elsewhere on the board
unnamed: D5.1 (K), R279.1
unnamed: C115.1, D6.1 (K), U92.4 (V_{DD})
unnamed: C111.2, J7.2, Q2.2 (S), R275.2, TP13.1 (1_1), TP14.1 (1_1), U90.4 (VSS)
unnamed: Q2.3 (D), Q3.3 (D)
unnamed: Q2.1 (G), U90.3 (Dout)
unnamed: Q3.1 (G), U90.2 (Cout)
unnamed: C111.1, R278.1, U90.5 (BAT)
unnamed: R281.2, U90.6 (V-)
unnamed: C112.1, R276.2, R277.1, U91.3 (+)
unnamed: R280.2, U92.5 (PROG)
unnamed: R279.2, U92.1 (STAT)
VBUS: D3.2 (A), D5.2 (A), D6.2 (A), J6.A4 (VBUS), J6.A9 (VBUS), J6.B4 (VBUS), J6.B9 (VBUS), Q1.1 (G), R270.1, TP2.1 (1_1)
VCC: C110.1, C114.1, TP12.1 (1_1), U88.5 (VOUT), U91.6 (V+); also elsewhere on the board
VPP: C108.1, C109.1, D3.1 (K), Q1.2 (S), R274.1, TP3.1 (1_1), U88.1 (VIN), U89.3 (VDD)

Notes on the sheet:
NB: This will also forward bias the Opamp's input protection diode though the top resistor when circuit is switched off, which will drain battery.
NB: Wire to board option
NB: T = 1/(2*pi * 340k * 0.1u) = 4.7 Hz
Battery: Adafruit-258
NB: This diode is required to prevent C299 from forming a very long RC circuit with R264/5, which causes long turn on time for Q1 and long time period in triode regime, which causes VPP to droop, which causes U154 to issue reset and the circuit to power cycle when USB cable is unplugged.
NB: Configure in device mode.
NB: 3.5V ~{RESET} threshold
NB: Most batteries include built in discharge protection. Therefore, BQ29700SER is redundand can cause charging lockout. If the BQ29700SER circuit is populated then DNP this resistor.
Light Pipe: PLPC3-125
