open-ephys/ephys-test-board/pcb/ephys-test-board.kicad_pcb

## KiCad design pcb/ephys-test-board.kicad_pcb (continued)

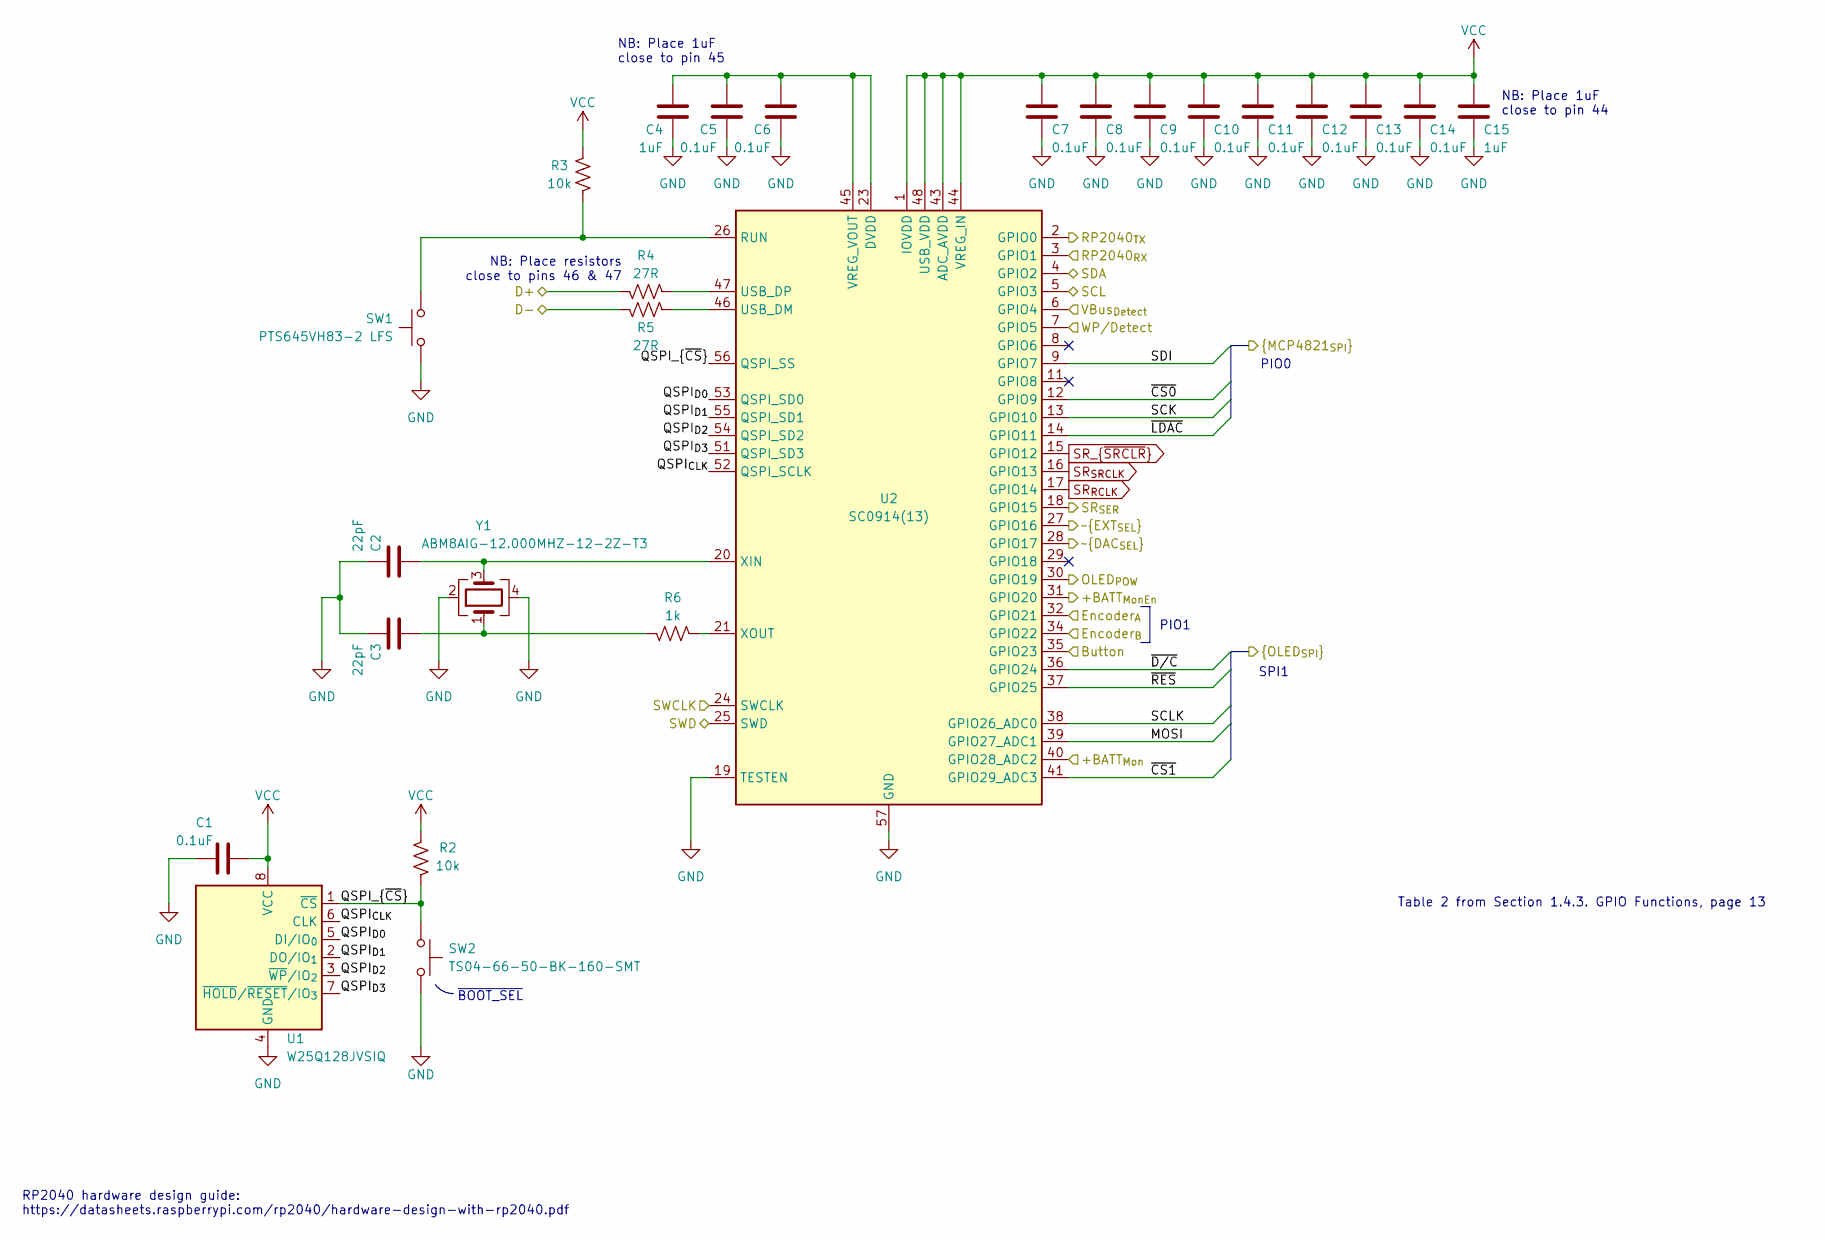
[picture p49: schematic mcu.kicad_sch, Extracellular Electrophysiology Test Board]

Parts:
C1, C5, C6, C7, C8, C9, C10, C11, C12, C13, C14: 0.1uF; C_0402_1005Metric; Voltage 25V; MPN C1005X7R1E104K050BB; LCSC C105883
C2, C3: 22pF; C_0402_1005Metric; Voltage 50V; Part No. C0402C0G500-220GNP-CT; LCSC C106203
C4, C15: 1uF; C_0603_1608Metric; Voltage 16V; MPN CL10A105KA8NNNC; LCSC C5673
R2, R3: 10k; R_0402_1005Metric; MPN CRCW040210K0FKED; LCSC C60490
R4, R5: 27R; R_0402_1005Metric; MPN RMCF0402FT27R0; LCSC C138021
R6: 1k; R_0402_1005Metric; Tolerance 0.1%; MPN RG1005P-102-B-T5; LCSC C2073397
SW1: PTS645VH83-2 LFS; SW_Tactile_SPST_Angled_PTS645Vx58-2LFS; MPN PTS645VH83-2 LFS; LCSC C221889
SW2: TS04-66-50-BK-160-SMT; SAMESKY_TS04-66-XX-BK-XXX-SMT-XX; MPN TS04-66-50-BK-160-SMT; LCSC C4364861
U1: W25Q128JVSIQ; SOIC-8_5.3x5.3mm_P1.27mm; MPN W25Q128JVSIQ; LCSC C97521
U2: SC0914(13); QFN-56-1EP_7x7mm_P0.4mm_EP3.2x3.2mm; Part No. SC0914(13); LCSC C2040
Y1: ABM8AIG-12.000MHZ-12-2Z-T3; Crystal_SMD_Abracon_ABM8AIG-4Pin_3.2x2.5mm; MPN ABM8AIG-12.000MHZ-12-2Z-T3; LCSC C133337

Connections:
/Headstage IO/SCL: U2.5 (GPIO3); also elsewhere on the board
/Headstage IO/SDA: U2.4 (GPIO2); also elsewhere on the board
/Headstage IO/WP/Detect: U2.7 (GPIO5); also elsewhere on the board
/MCU/+BATT_{MonEn}: U2.31 (GPIO20); also elsewhere on the board
/MCU/+BATT_{Mon}: U2.40 (GPIO28_ADC2); also elsewhere on the board
/MCU/Button: U2.35 (GPIO23); also elsewhere on the board
/MCU/D+: R4.2; also elsewhere on the board
/MCU/D-: R5.2; also elsewhere on the board
/MCU/Encoder_{A}: U2.32 (GPIO21); also elsewhere on the board
/MCU/Encoder_{B}: U2.34 (GPIO22); also elsewhere on the board
/MCU/MOSI: U2.39 (GPIO27_ADC1); also elsewhere on the board
/MCU/OLED_{POW}: U2.30 (GPIO19); also elsewhere on the board
/MCU/QSPI_{CLK}: U1.6 (CLK), U2.52 (QSPI_SCLK)
/MCU/QSPI_{D0}: U1.5 (DI/IO_{0}), U2.53 (QSPI_SD0)
/MCU/QSPI_{D1}: U1.2 (DO/IO_{1}), U2.55 (QSPI_SD1)
/MCU/QSPI_{D2}: U1.3 (~WP/IO_{2}), U2.54 (QSPI_SD2)
/MCU/QSPI_{D3}: U1.7 (~HOLD/~RESET/IO_{3}), U2.51 (QSPI_SD3)
/MCU/QSPI_{~CS}: R2.2, SW2.2, U1.1 (~CS), U2.56 (QSPI_SS)
/MCU/RP2040_{RX}: U2.3 (GPIO1); also elsewhere on the board
/MCU/RP2040_{TX}: U2.2 (GPIO0); also elsewhere on the board
/MCU/SCK: U2.13 (GPIO10); also elsewhere on the board
/MCU/SCLK: U2.38 (GPIO26_ADC0); also elsewhere on the board
/MCU/SDI: U2.9 (GPIO7); also elsewhere on the board
/MCU/SR_{SER}: U2.18 (GPIO15); also elsewhere on the board
/MCU/SWCLK: U2.24 (SWCLK); also elsewhere on the board
/MCU/SWD: U2.25 (SWD); also elsewhere on the board
/MCU/VBus_{Detect}: U2.6 (GPIO4); also elsewhere on the board
/MCU/~CS0: U2.12 (GPIO9); also elsewhere on the board
/MCU/~CS1: U2.41 (GPIO29_ADC3); also elsewhere on the board
/MCU/~DAC_{SEL}: U2.28 (GPIO17); also elsewhere on the board
/MCU/~D/C: U2.36 (GPIO24); also elsewhere on the board
/MCU/~EXT_{SEL}: U2.27 (GPIO16); also elsewhere on the board
/MCU/~LDAC: U2.14 (GPIO11); also elsewhere on the board
/MCU/~RES: U2.37 (GPIO25); also elsewhere on the board
GND: C1.2, C2.2, C3.2, C4.2, C5.2, C6.2, C7.2, C8.2, C9.2, C10.2, C11.2, C12.2, C13.2, C14.2, C15.2, SW1.1, SW2.1, U1.4 (GND), U2.19 (TESTEN), U2.57 (GND), Y1.2, Y1.4; also elsewhere on the board
unnamed: C3.1, R6.2, Y1.1
unnamed: R3.2, SW1.2, U2.26 (RUN)
unnamed: R5.1, U2.46 (USB_DM)
unnamed: R4.1, U2.47 (USB_DP)
unnamed: C4.1, C5.1, C6.1, U2.23 (DVDD), U2.45 (VREG_VOUT), U2.50 (DVDD)
unnamed: C2.1, U2.20 (XIN), Y1.3
unnamed: R6.1, U2.21 (XOUT)
SR_{RCLK}: U2.17 (GPIO14); also elsewhere on the board
SR_{SRCLK}: U2.16 (GPIO13); also elsewhere on the board
SR_{~SRCLR}: U2.15 (GPIO12); also elsewhere on the board
VCC: C1.1, C7.1, C8.1, C9.1, C10.1, C11.1, C12.1, C13.1, C14.1, C15.1, R2.1, R3.1, U1.8 (VCC), U2.1 (IOVDD), U2.10 (IOVDD), U2.22 (IOVDD), U2.33 (IOVDD), U2.42 (IOVDD), U2.43 (ADC_AVDD), U2.44 (VREG_IN), U2.48 (USB_VDD), U2.49 (IOVDD); also elsewhere on the board

Notes on the sheet:
NB: Place 1uF close to pin 45
Table 2 from Section 1.4.3. GPIO Functions, page 13
PIO1
NB: Place 1uF close to pin 44
PIO0
SPI1
RP2040 hardware design guide: https://datasheets.raspberrypi.com/rp2040/hardware-design-with-rp2040.pdf
~{BOOT_SEL}
NB: Place resistors close to pins 46 & 47

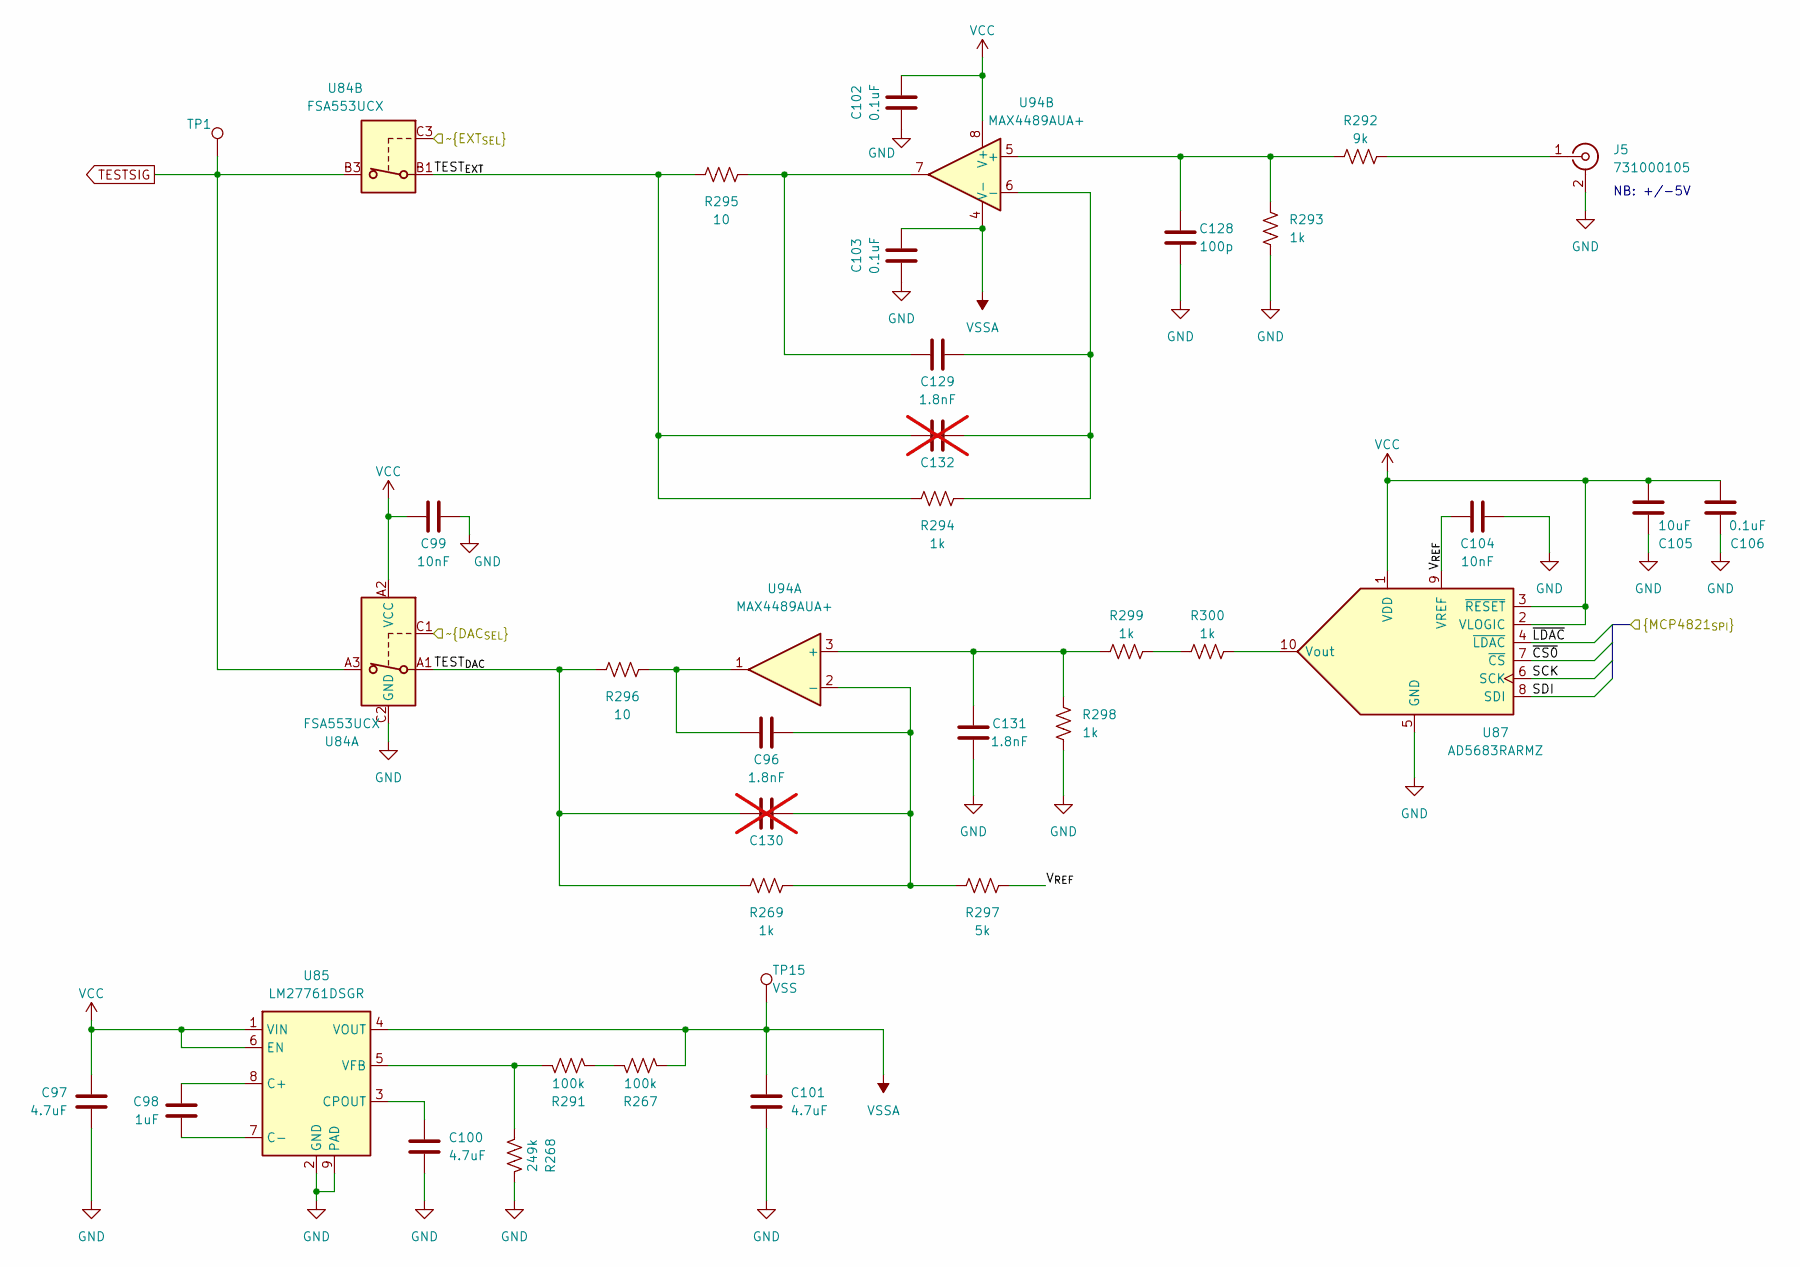
[picture p50: schematic test-signal.kicad_sch, Extracellular Electrophysiology Test Board]

Parts:
C96, C129, C131: 1.8nF; C_0402_1005Metric; Voltage 50V; MPN C0402C182J5RACTU; LCSC C107024
C97, C100, C101: 4.7uF; C_1206_3216Metric; Voltage 16V; MPN CL31B475KOHNNNE; LCSC C51205
C98: 1uF; C_0603_1608Metric; Voltage 16V; MPN CL10A105KA8NNNC; LCSC C5673
C99, C104: 10nF; C_0402_1005Metric; Voltage 50V; MPN GRM155R71E103KA01D; LCSC C60133
C102, C103, C106: 0.1uF; C_0402_1005Metric; Voltage 25V; MPN C1005X7R1E104K050BB; LCSC C105883
C105: 10uF; C_1206_3216Metric; Voltage 16V; MPN CL31B106KBHNNNE; LCSC C13585
C128: 100p; C_0402_1005Metric; Voltage 50V; MPN CC0402JRNPO9BN101; LCSC C281751
C130, C132: C_0402_1005Metric; MPN DNP; not fitted
J5: 731000105; BNC_MOLEX_0731000105; MPN 731000105; LCSC C3174924
R267, R291: 100k; R_0402_1005Metric; Tolerance 1%; MPN AC0402FR-07100KL; LCSC C852472
R268: 249k; R_0402_1005Metric; Tolerance 1%; MPN RMCF0402FT249K; LCSC C852472
R269, R293, R294, R298, R299, R300: 1k; R_0402_1005Metric; Tolerance 0.1%; MPN RG1005P-102-B-T5; LCSC C2073397
R292: 9k; R_0805_2012Metric; Tolerance 0.1%; MPN RT0805BRE079KL; LCSC C868262
R295, R296: 10; R_0402_1005Metric; Tolerance 1%; MPN RMCF0402FT10R0; LCSC C138066
R297: 5k; R_0402_1005Metric; Tolerance 0.1%; MPN PNM0402E5001BST1; LCSC C5948099
TP1: VCC; TestPoint_Pad_D2.0mm
TP15: VSS; TestPoint_Pad_D2.0mm
U84: FSA553UCX; ONSEMI_567SV_WLCSP9-3x3-1.215x1.385x0.581mm-P0.4mm; MPN FSA553UCX; LCSC C605183
U85: LM27761DSGR; WSON-8-1EP_2x2mm_P0.5mm_EP0.9x1.6mm; MPN LM27761DSGR; LCSC C129351
U87: AD5683RARMZ; MSOP-10_3x3mm_P0.5mm; MPN AD5683RARMZ; LCSC C650083
U94: MAX4489AUA+; MSOP-8_3x3mm_P0.65mm; MPN MAX4489AUA+; LCSC C7451493

Connections:
/MCU/SCK: U87.6 (SCK); also elsewhere on the board
/MCU/SDI: U87.8 (SDI); also elsewhere on the board
/MCU/~CS0: U87.7 (~CS); also elsewhere on the board
/MCU/~DAC_{SEL}: U84.C1; also elsewhere on the board
/MCU/~EXT_{SEL}: U84.C3; also elsewhere on the board
/MCU/~LDAC: U87.4 (~LDAC); also elsewhere on the board
/Test Signal/TEST_{DAC}: C130.2, R269.2, R296.2, U84.A1
/Test Signal/TEST_{EXT}: C132.2, R294.2, R295.2, U84.B1
/Test Signal/V_{REF}: C104.1, R297.1, U87.9 (VREF)
GND: C97.2, C99.2, C100.2, C101.2, C102.2, C103.2, C104.2, C105.2, C106.2, C128.2, C131.2, J5.2 (Ext), R268.1, R293.2, R298.2, U84.C2 (GND), U85.2 (GND), U85.9 (PAD), U87.5 (GND); also elsewhere on the board
unnamed: C96.2, R296.1, U94.1
unnamed: C129.2, R295.1, U94.7
unnamed: J5.1 (In), R292.2
unnamed: R267.1, R291.2
unnamed: R299.2, R300.1
unnamed: C98.2, U85.8 (C+)
unnamed: C98.1, U85.7 (C-)
unnamed: C100.1, U85.3 (CPOUT)
unnamed: R268.2, R291.1, U85.5 (VFB)
unnamed: R300.2, U87.10 (Vout)
unnamed: C131.1, R298.1, R299.1, U94.3 (+)
unnamed: C96.1, C130.1, R269.1, R297.2, U94.2 (-)
unnamed: C128.1, R292.1, R293.1, U94.5 (+)
unnamed: C129.1, C132.1, R294.1, U94.6 (-)
TESTSIG: TP1.1 (1_1), U84.A3, U84.B3; also elsewhere on the board
VCC: C97.1, C99.1, C102.1, C105.1, C106.1, U84.A2 (VCC), U85.1 (VIN), U85.6 (EN), U87.1 (VDD), U87.2 (VLOGIC), U87.3 (~RESET), U94.8 (V+); also elsewhere on the board
VSSA: C101.1, C103.1, R267.2, TP15.1 (1_1), U85.4 (VOUT), U94.4 (V-)

Notes on the sheet:
NB: +/-5V

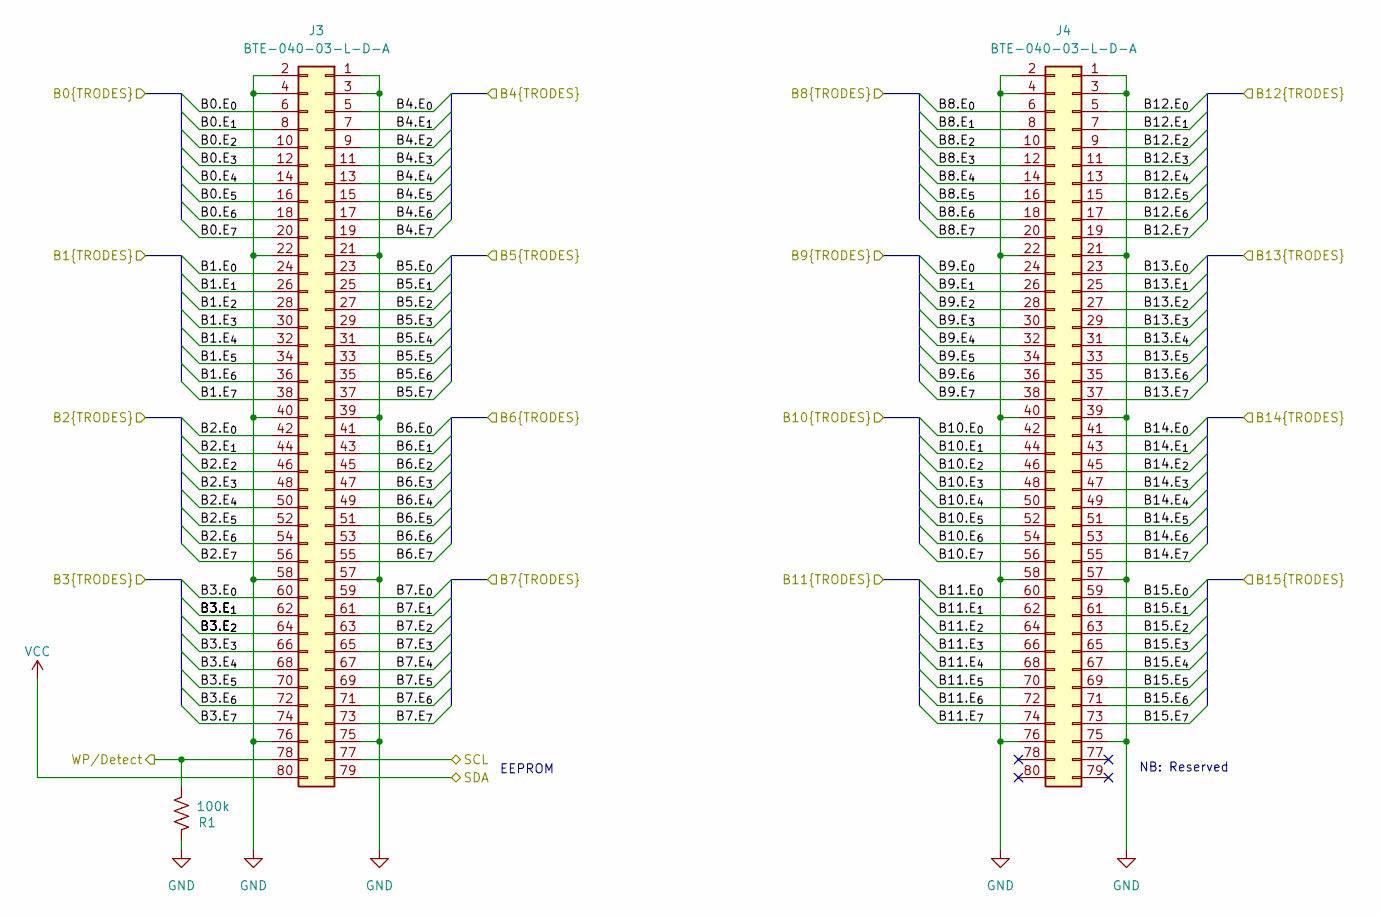
[picture p51: schematic headstage-io.kicad_sch, Extracellular Electrophysiology Test Board]

Parts:
J3, J4: BTE-040-03-L-D-A; SAMTEC_BTE-040-0x-L-D-A-K-TR; MPN BTE-040-03-L-D-A; LCSC C6135791
R1: 100k; R_0402_1005Metric; Tolerance 1%; MPN AC0402FR-07100KL; LCSC C852472

Connections:
/Headstage IO/B0.E_{0}: J3.6; also elsewhere on the board
/Headstage IO/B0.E_{1}: J3.8; also elsewhere on the board
/Headstage IO/B0.E_{2}: J3.10; also elsewhere on the board
/Headstage IO/B0.E_{3}: J3.12; also elsewhere on the board
/Headstage IO/B0.E_{4}: J3.14; also elsewhere on the board
/Headstage IO/B0.E_{5}: J3.16; also elsewhere on the board
/Headstage IO/B0.E_{6}: J3.18; also elsewhere on the board
/Headstage IO/B0.E_{7}: J3.20; also elsewhere on the board
/Headstage IO/B1.E_{0}: J3.24; also elsewhere on the board
/Headstage IO/B1.E_{1}: J3.26; also elsewhere on the board
/Headstage IO/B1.E_{2}: J3.28; also elsewhere on the board
/Headstage IO/B1.E_{3}: J3.30; also elsewhere on the board
/Headstage IO/B1.E_{4}: J3.32; also elsewhere on the board
/Headstage IO/B1.E_{5}: J3.34; also elsewhere on the board
/Headstage IO/B1.E_{6}: J3.36; also elsewhere on the board
/Headstage IO/B1.E_{7}: J3.38; also elsewhere on the board
/Headstage IO/B2.E_{0}: J3.42; also elsewhere on the board
/Headstage IO/B2.E_{1}: J3.44; also elsewhere on the board
/Headstage IO/B2.E_{2}: J3.46; also elsewhere on the board
/Headstage IO/B2.E_{3}: J3.48; also elsewhere on the board
/Headstage IO/B2.E_{4}: J3.50; also elsewhere on the board
/Headstage IO/B2.E_{5}: J3.52; also elsewhere on the board
/Headstage IO/B2.E_{6}: J3.54; also elsewhere on the board
/Headstage IO/B2.E_{7}: J3.56; also elsewhere on the board
/Headstage IO/B3.E_{0}: J3.60; also elsewhere on the board
/Headstage IO/B3.E_{1}: J3.62; also elsewhere on the board
/Headstage IO/B3.E_{2}: J3.64; also elsewhere on the board
/Headstage IO/B3.E_{3}: J3.66; also elsewhere on the board
/Headstage IO/B3.E_{4}: J3.68; also elsewhere on the board
/Headstage IO/B3.E_{5}: J3.70; also elsewhere on the board
/Headstage IO/B3.E_{6}: J3.72; also elsewhere on the board
/Headstage IO/B3.E_{7}: J3.74; also elsewhere on the board
/Headstage IO/B4.E_{0}: J3.5; also elsewhere on the board
/Headstage IO/B4.E_{1}: J3.7; also elsewhere on the board
/Headstage IO/B4.E_{2}: J3.9; also elsewhere on the board
/Headstage IO/B4.E_{3}: J3.11; also elsewhere on the board
/Headstage IO/B4.E_{4}: J3.13; also elsewhere on the board
/Headstage IO/B4.E_{5}: J3.15; also elsewhere on the board
/Headstage IO/B4.E_{6}: J3.17; also elsewhere on the board
/Headstage IO/B4.E_{7}: J3.19; also elsewhere on the board
/Headstage IO/B5.E_{0}: J3.23; also elsewhere on the board
/Headstage IO/B5.E_{1}: J3.25; also elsewhere on the board
/Headstage IO/B5.E_{2}: J3.27; also elsewhere on the board
/Headstage IO/B5.E_{3}: J3.29; also elsewhere on the board
/Headstage IO/B5.E_{4}: J3.31; also elsewhere on the board
/Headstage IO/B5.E_{5}: J3.33; also elsewhere on the board
/Headstage IO/B5.E_{6}: J3.35; also elsewhere on the board
/Headstage IO/B5.E_{7}: J3.37; also elsewhere on the board
/Headstage IO/B6.E_{0}: J3.41; also elsewhere on the board
/Headstage IO/B6.E_{1}: J3.43; also elsewhere on the board
/Headstage IO/B6.E_{2}: J3.45; also elsewhere on the board
/Headstage IO/B6.E_{3}: J3.47; also elsewhere on the board
/Headstage IO/B6.E_{4}: J3.49; also elsewhere on the board
/Headstage IO/B6.E_{5}: J3.51; also elsewhere on the board
/Headstage IO/B6.E_{6}: J3.53; also elsewhere on the board
/Headstage IO/B6.E_{7}: J3.55; also elsewhere on the board
/Headstage IO/B7.E_{0}: J3.59; also elsewhere on the board
/Headstage IO/B7.E_{1}: J3.61; also elsewhere on the board
/Headstage IO/B7.E_{2}: J3.63; also elsewhere on the board
/Headstage IO/B7.E_{3}: J3.65; also elsewhere on the board
/Headstage IO/B7.E_{4}: J3.67; also elsewhere on the board
/Headstage IO/B7.E_{5}: J3.69; also elsewhere on the board
/Headstage IO/B7.E_{6}: J3.71; also elsewhere on the board
/Headstage IO/B7.E_{7}: J3.73; also elsewhere on the board
/Headstage IO/B8.E_{0}: J4.6; also elsewhere on the board
/Headstage IO/B8.E_{1}: J4.8; also elsewhere on the board
/Headstage IO/B8.E_{2}: J4.10; also elsewhere on the board
/Headstage IO/B8.E_{3}: J4.12; also elsewhere on the board
/Headstage IO/B8.E_{4}: J4.14; also elsewhere on the board
/Headstage IO/B8.E_{5}: J4.16; also elsewhere on the board
/Headstage IO/B8.E_{6}: J4.18; also elsewhere on the board
/Headstage IO/B8.E_{7}: J4.20; also elsewhere on the board
/Headstage IO/B9.E_{0}: J4.24; also elsewhere on the board
/Headstage IO/B9.E_{1}: J4.26; also elsewhere on the board
/Headstage IO/B9.E_{2}: J4.28; also elsewhere on the board
/Headstage IO/B9.E_{3}: J4.30; also elsewhere on the board
/Headstage IO/B9.E_{4}: J4.32; also elsewhere on the board
/Headstage IO/B9.E_{5}: J4.34; also elsewhere on the board
/Headstage IO/B9.E_{6}: J4.36; also elsewhere on the board
/Headstage IO/B9.E_{7}: J4.38; also elsewhere on the board
/Headstage IO/B10.E_{0}: J4.42; also elsewhere on the board
/Headstage IO/B10.E_{1}: J4.44; also elsewhere on the board
/Headstage IO/B10.E_{2}: J4.46; also elsewhere on the board
/Headstage IO/B10.E_{3}: J4.48; also elsewhere on the board
/Headstage IO/B10.E_{4}: J4.50; also elsewhere on the board
/Headstage IO/B10.E_{5}: J4.52; also elsewhere on the board
/Headstage IO/B10.E_{6}: J4.54; also elsewhere on the board
/Headstage IO/B10.E_{7}: J4.56; also elsewhere on the board
/Headstage IO/B11.E_{0}: J4.60; also elsewhere on the board
/Headstage IO/B11.E_{1}: J4.62; also elsewhere on the board
/Headstage IO/B11.E_{2}: J4.64; also elsewhere on the board
/Headstage IO/B11.E_{3}: J4.66; also elsewhere on the board
/Headstage IO/B11.E_{4}: J4.68; also elsewhere on the board
/Headstage IO/B11.E_{5}: J4.70; also elsewhere on the board
/Headstage IO/B11.E_{6}: J4.72; also elsewhere on the board
/Headstage IO/B11.E_{7}: J4.74; also elsewhere on the board
/Headstage IO/B12.E_{0}: J4.5; also elsewhere on the board
/Headstage IO/B12.E_{1}: J4.7; also elsewhere on the board
/Headstage IO/B12.E_{2}: J4.9; also elsewhere on the board
/Headstage IO/B12.E_{3}: J4.11; also elsewhere on the board
/Headstage IO/B12.E_{4}: J4.13; also elsewhere on the board
/Headstage IO/B12.E_{5}: J4.15; also elsewhere on the board
/Headstage IO/B12.E_{6}: J4.17; also elsewhere on the board
/Headstage IO/B12.E_{7}: J4.19; also elsewhere on the board
/Headstage IO/B13.E_{0}: J4.23; also elsewhere on the board
/Headstage IO/B13.E_{1}: J4.25; also elsewhere on the board
/Headstage IO/B13.E_{2}: J4.27; also elsewhere on the board
/Headstage IO/B13.E_{3}: J4.29; also elsewhere on the board
/Headstage IO/B13.E_{4}: J4.31; also elsewhere on the board
/Headstage IO/B13.E_{5}: J4.33; also elsewhere on the board
/Headstage IO/B13.E_{6}: J4.35; also elsewhere on the board
/Headstage IO/B13.E_{7}: J4.37; also elsewhere on the board
/Headstage IO/B14.E_{0}: J4.41; also elsewhere on the board
/Headstage IO/B14.E_{1}: J4.43; also elsewhere on the board
/Headstage IO/B14.E_{2}: J4.45; also elsewhere on the board
/Headstage IO/B14.E_{3}: J4.47; also elsewhere on the board
/Headstage IO/B14.E_{4}: J4.49; also elsewhere on the board
/Headstage IO/B14.E_{5}: J4.51; also elsewhere on the board
/Headstage IO/B14.E_{6}: J4.53; also elsewhere on the board
/Headstage IO/B14.E_{7}: J4.55; also elsewhere on the board
/Headstage IO/B15.E_{0}: J4.59; also elsewhere on the board
/Headstage IO/B15.E_{1}: J4.61; also elsewhere on the board
/Headstage IO/B15.E_{2}: J4.63; also elsewhere on the board
/Headstage IO/B15.E_{3}: J4.65; also elsewhere on the board
/Headstage IO/B15.E_{4}: J4.67; also elsewhere on the board
/Headstage IO/B15.E_{5}: J4.69; also elsewhere on the board
/Headstage IO/B15.E_{6}: J4.71; also elsewhere on the board
/Headstage IO/B15.E_{7}: J4.73; also elsewhere on the board
/Headstage IO/SCL: J3.77; also elsewhere on the board
/Headstage IO/SDA: J3.79; also elsewhere on the board
/Headstage IO/WP/Detect: J3.78, R1.2; also elsewhere on the board
GND: J3.1, J3.2, J3.3, J3.4, J3.21, J3.22, J3.39, J3.40, J3.57, J3.58, J3.75, J3.76, J4.1, J4.2, J4.3, J4.4, J4.21, J4.22, J4.39, J4.40, J4.57, J4.58, J4.75, J4.76, R1.1; also elsewhere on the board
VCC: J3.80; also elsewhere on the board

Notes on the sheet:
EEPROM
NB: Reserved

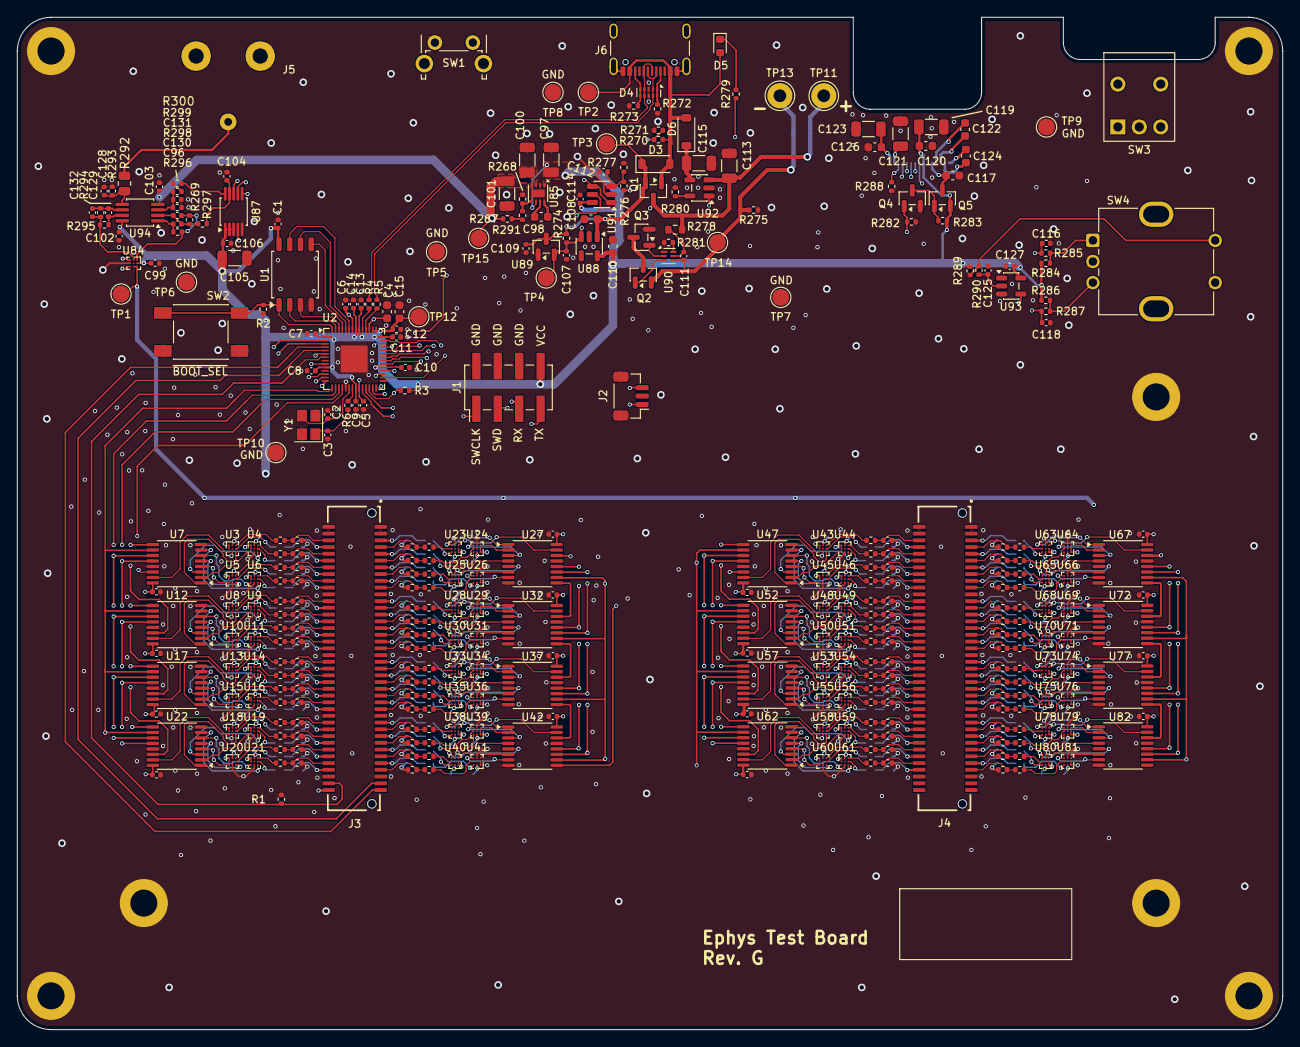
[picture p52: board ephys-test-board.kicad_pcb from above]

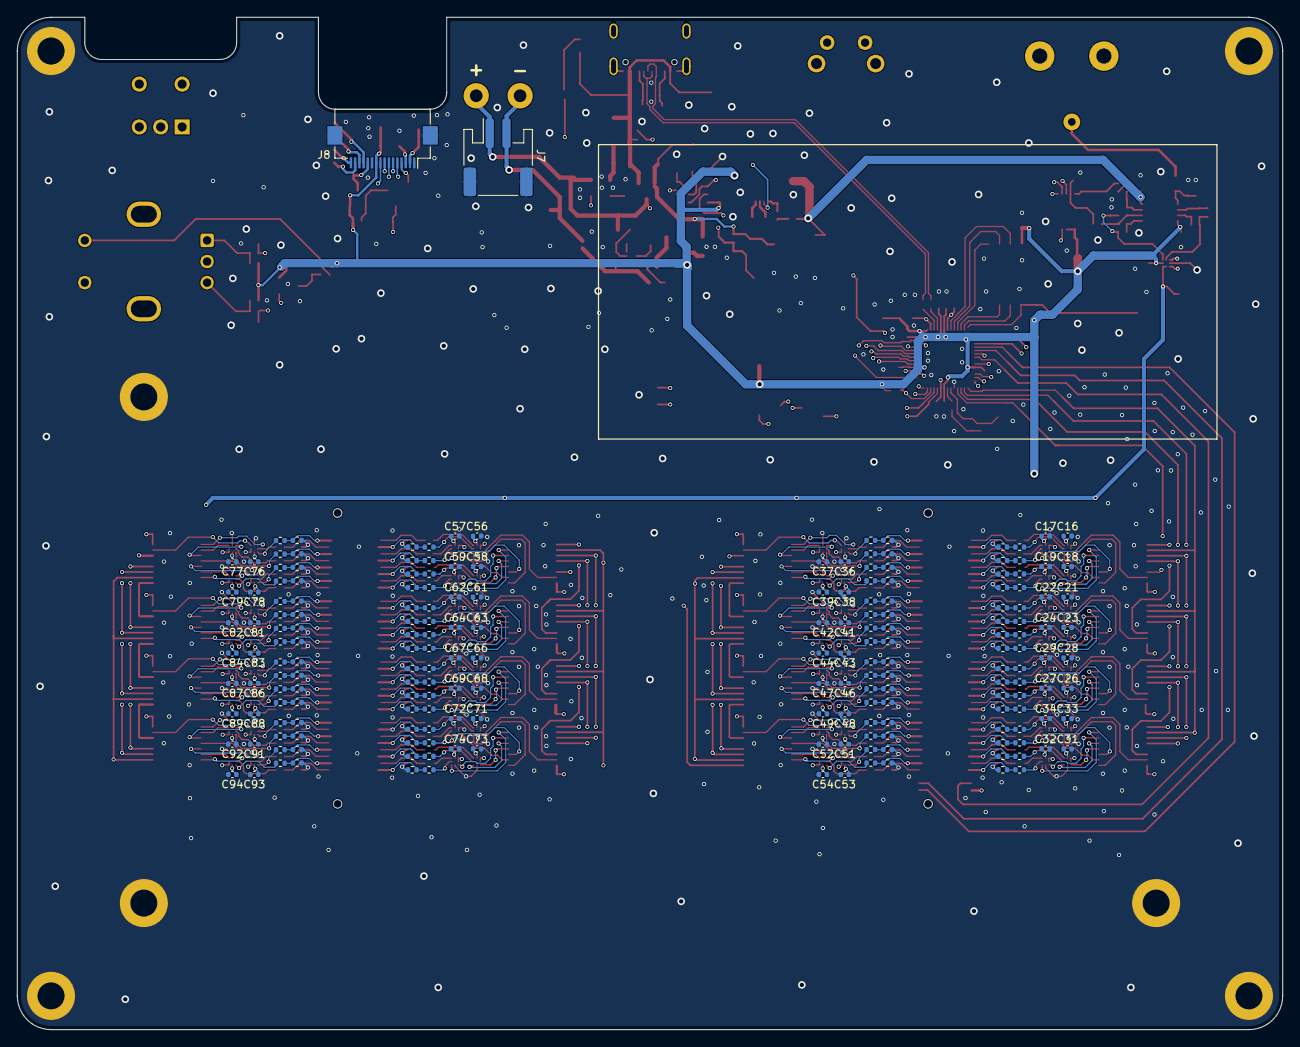
[picture p53: board ephys-test-board.kicad_pcb from below]

Board: 4 copper layers, 150.0 x 120.0 mm, 565 parts (194 on the bottom side), 494 nets.
