open-ephys/ephys-test-board/firmware/main.cpp

#include <stdio.h>
#include "pico/stdlib.h"
#include "pico/multicore.h"
#include "pico/util/queue.h"

#include "oled.h"

extern "C"
{
#include "ephys-tester.h"
#include "channels.h"
#include "eeprom.h"
#include "ad5683.h"
#include "quadrature.h"
#include "mode.h"
#include "battmon.h"
#include "lut.h"
#include "spikes.h"
#include "sr.h"
}

queue_t signal_generator_cmd_queue;
volatile bool channel_increment_request = false;
volatile bool monitor_request = false;
volatile bool knob_press_detected = false;
volatile int dac_clipping = CLIP_NONE;

typedef struct timer_callback_data_t {
    pio_spi_inst_t *dac_spi;
    uint16_t rshift;
    float scale;
    uint16_t offset;
    int step;
    const uint16_t *lut;
    size_t lut_len;
} timer_callback_data_t;


// WARNING: If this call takes longer than the timer period, it will completely
// take over a core and lock out all other activity (e.g. command dequeueing
// that would cause the timer to stop, etc.).
bool dac_update_callback_rs(struct repeating_timer *t)
{
    static size_t i = 0;
    timer_callback_data_t *td = (timer_callback_data_t *)t->user_data;

    dac_clipping |= ad5683_write_dac_rs(td->dac_spi, *(td->lut + (i % td->lut_len)), td->rshift, td->offset);
    i += td->step;

    return true;
}

// WARNING: If this call takes longer than the timer period, it will completely
// take over a core and lock out all other activity (e.g. command dequeueing
// that would cause the timer to stop, etc.).
bool dac_update_callback_scale(struct repeating_timer *t)
{
    static size_t i = 0;
    timer_callback_data_t *td = (timer_callback_data_t *)t->user_data;

    dac_clipping |= ad5683_write_dac_scale(td->dac_spi, *(td->lut + (i % td->lut_len)), td->scale, td->offset);
    i += td->step;

    return true;
}

bool system_monitor_callback(struct repeating_timer *t)
{
    monitor_request = true;
    return true;
}

bool channel_increment_callback(struct repeating_timer *t)
{
    channel_increment_request = true;
    return true;
}

void knob_press_callback(uint gpio, uint32_t events)
{
    knob_press_detected = true;
}

// NB: Calling cancel_repeating_timer on a timer that has not been started
// causes a segfault. Guard with a boolean rather than inspecting alarm_id,
// which the SDK does not reliably reset to -1 on cancel.
static bool cancel_repeating_timer_safe(repeating_timer_t *timer, bool timer_cancelled)
{
    return timer_cancelled ? true : cancel_repeating_timer(timer);
}

void core1_entry()
{
    // DAC initialization
    pio_spi_inst_t dac_spi = {
        .pio = DAC_PIO,
        .sm = 0,
    };

    ad5683_init(&dac_spi);

    struct repeating_timer timer;
    timer_callback_data_t timer_data_buf[2] = {};
    int timer_buf_active = 0;
    bool timer_cancelled = true;
    mode_signal_t signal;
    static int last_timer_usec = 0;
    alarm_pool_t *alarm_pool = alarm_pool_create_with_unused_hardware_alarm(10);

    while (true)
    {
        queue_remove_blocking(&signal_generator_cmd_queue, &signal);

        int next_buf = 1 - timer_buf_active;
        timer_data_buf[next_buf].dac_spi = &dac_spi;
        timer_data_buf[next_buf].offset = DAC_MIDSCALE + (signal.offset_uV / MAX_AMPLITUDE_UV) * DAC_FULLSCALE;
        timer_data_buf[next_buf].rshift = signal.amp_rshift;
        timer_data_buf[next_buf].scale = signal.amp_scale;
        timer_cancelled = cancel_repeating_timer_safe(&timer, timer_cancelled);
        int timer_usec = last_timer_usec;

        switch (signal.waveform)
        {
            case WAVEFORM_GND:
                ad5683_write_dac_rs(&dac_spi, 0, 0, DAC_MIDSCALE);
                sr_source(SIGNAL_NONE);
                continue;
            case WAVEFORM_EXTERNAL:
                ad5683_write_dac_rs(&dac_spi, 0, 0, DAC_MIDSCALE);
                sr_source(SIGNAL_EXTERNAL);
                continue;
            case WAVEFORM_DC:
                ad5683_write_dac_rs(&dac_spi, 0, 0, timer_data_buf[next_buf].offset);
                sr_source(SIGNAL_INTERNAL);
                continue;
            case WAVEFORM_SINE:
                timer_data_buf[next_buf].lut = SINE_LUT;
                timer_data_buf[next_buf].lut_len = SINE_LUT_LENGTH;
                timer_data_buf[next_buf].step = FREQ_LUT[signal.freq_lut_idx][3];
                timer_usec = FREQ_LUT[signal.freq_lut_idx][2];
                sr_source(SIGNAL_INTERNAL);
                break;
            case WAVEFORM_SAW:
                timer_data_buf[next_buf].lut = SAW_LUT;
                timer_data_buf[next_buf].lut_len = SAW_LUT_LENGTH;
                timer_data_buf[next_buf].step = FREQ_LUT[signal.freq_lut_idx][3];
                timer_usec = FREQ_LUT[signal.freq_lut_idx][2];
                sr_source(SIGNAL_INTERNAL);
                break;
            case WAVEFORM_SPIKESLF:
                timer_data_buf[next_buf].lut = SPIKESLF;
                timer_data_buf[next_buf].lut_len = SPIKES_LENGTH;
                timer_data_buf[next_buf].step = 1;
                timer_usec = SPIKES_SAMP_PERIOD_USEC;
                sr_source(SIGNAL_INTERNAL);
                break;
            case WAVEFORM_SPIKESMF:
                timer_data_buf[next_buf].lut = SPIKESMF;
                timer_data_buf[next_buf].lut_len = SPIKES_LENGTH;
                timer_data_buf[next_buf].step = 1;
                timer_usec = SPIKES_SAMP_PERIOD_USEC;
                sr_source(SIGNAL_INTERNAL);
                break;
            case WAVEFORM_SPIKESHF:
                timer_data_buf[next_buf].lut = SPIKESHF;
                timer_data_buf[next_buf].lut_len = SPIKES_LENGTH;
                timer_data_buf[next_buf].step = 1;
                timer_usec = SPIKES_SAMP_PERIOD_USEC;
                sr_source(SIGNAL_INTERNAL);
                break;
            default:
                continue;
        }

        if (timer_cancelled || last_timer_usec != timer_usec)
        {
            bool started;
            if (signal.use_scale)
                started = alarm_pool_add_repeating_timer_us(alarm_pool, -timer_usec, dac_update_callback_scale, &timer_data_buf[next_buf], &timer);
            else
                started = alarm_pool_add_repeating_timer_us(alarm_pool, -timer_usec, dac_update_callback_rs, &timer_data_buf[next_buf], &timer);
            if (started)
                timer_buf_active = next_buf;
            timer_cancelled = !started;
            last_timer_usec = timer_usec;
        }
    }
}

int main()
{
    // OLED
    oled_init();
    sleep_ms(2000); // Let splash screen hang around for a while

    // Quadrature encoder initialization
    quad_init();

    // Setup user IO context
    mode_context_t ctx;
    mode_init(&ctx);

    // System monitor initialization
    batt_mon_init();
    batt_mon_monitor(&ctx);
    struct repeating_timer monitor_timer;
    add_repeating_timer_ms(-SYS_MON_PERIOD_MS, system_monitor_callback, NULL, &monitor_timer);

    // Setup knob button callback
    gpio_init(ENC_BUT);
    gpio_set_dir(ENC_BUT, GPIO_IN);
    gpio_set_irq_enabled_with_callback(ENC_BUT, GPIO_IRQ_EDGE_RISE, true, &knob_press_callback);

    // Initialize EEPROM
    eeprom_init();

    // Read required first map
    int selected_map = 0;
    int num_maps = eeprom_read_module(&ctx, selected_map);

    // Select map loop
    if (num_maps > 0)
    {
        oled_update_map_menu(&ctx);

        while (true) {

            if (quad_pending_turn())
            {
                quad_acknowledge_turn();
                if (quad_get_delta() > 0)
                    selected_map = selected_map == num_maps - 1 ? -1 : selected_map + 1;
                else
                    selected_map = selected_map == -1 ? num_maps - 1 : selected_map - 1;

                eeprom_read_module(&ctx, selected_map);
                oled_update_map_menu(&ctx);
            }

            if (monitor_request)
            {
                monitor_request = false;
                batt_mon_monitor(&ctx);
                oled_update_map_menu(&ctx);
            }

            if (knob_press_detected)
            {
                knob_press_detected = false;
                break;
            }
        }
    } else {
        eeprom_set_default(&ctx);
    }

    // Initialize channel mux
    channels_init();

    // Initialize queue for conveying settings to waveform generator
    queue_init(&signal_generator_cmd_queue, sizeof(mode_signal_t), 10);

    // Launch the second core to handle the waveform generator
    multicore_launch_core1(core1_entry);

    // Force first mode update
    mode_update_from_knob(&ctx, quad_get_delta());

    // Enter main menu
    oled_update_main_menu(&ctx, false);

    // Send default state to waveform generator
    queue_add_blocking(&signal_generator_cmd_queue, &(ctx.signal));

    // Auto channel increment state
    struct repeating_timer channel_timer;
    bool channel_timer_cancelled = true;
    bool first_cycle = false;

    // OLED state
    bool blink = false;

    // Main loop
    while(true)
    {
        bool update_oled_required = false;

        if (knob_press_detected)
        {
            mode_cycle_selection(&ctx);
            knob_press_detected = false;
            update_oled_required = true;
        }

        if (quad_pending_turn())
        {
            quad_acknowledge_turn();
            mode_update_result_t what_changed = mode_update_from_knob(&ctx, quad_get_delta());

            if (what_changed == MODE_UPDATE_INPUTSOURCE) {

                // NB: Prevent multiple, overlapping timers
                channel_timer_cancelled = cancel_repeating_timer_safe(&channel_timer, channel_timer_cancelled);

                if (ctx.test_dest == DEST_CYCLE_CHANNEL_SLOW || ctx.test_dest == DEST_CYCLE_CHANNEL_FAST) {
                    int32_t delay = ctx.test_dest == DEST_CYCLE_CHANNEL_SLOW ? AUTO_CHAN_SDWELL_MS : AUTO_CHAN_FDWELL_MS;
                    channel_timer_cancelled = !add_repeating_timer_ms(-delay, channel_increment_callback, NULL, &channel_timer);
                    ctx.channel_idx = ctx.channel_map.num_channels - 1; // NB: Start at last index because increment will cycle it to 0
                    first_cycle = true; // NB: On the first cycle we activate all channels
                    channel_increment_request = true; // NB: This call counts as  time 0
                } else {
                    channels_update(&ctx);
                }
            } else if (what_changed == MODE_UPDATE_SIGNAL)
                queue_try_add(&signal_generator_cmd_queue, &(ctx.signal));
            else if (what_changed == MODE_UPDATE_CHANNEL)
                channels_update(&ctx);

            update_oled_required = true;
        }

        if (channel_increment_request)
        {
            channel_increment_request = false;
            if (first_cycle)
            {
                channels_update_manual(ctx.channel_map.channel_map, ctx.channel_map.num_channels);
                first_cycle = false;
            } else {
                mode_increment_channel(&ctx);
                channels_update(&ctx);
                first_cycle = (ctx.channel_idx == ctx.channel_map.num_channels - 1);
                update_oled_required = true;
            }
        }

        if (monitor_request)
        {
            monitor_request = false;
            blink = !blink;
            ctx.clipping = (signal_clip_t)dac_clipping;
            dac_clipping = CLIP_NONE; // give it a chance to recover
            batt_mon_monitor(&ctx);
            update_oled_required = true;
        }

        if (update_oled_required)
            oled_update_main_menu(&ctx, blink);
    }
}
