open-ephys/ephys-test-board/firmware/lut.h

#pragma once

#define NUM_FREQS 11
#define DEFAULT_FREQ_INDEX 8 // 1000 Hz

const int FREQ_LUT[NUM_FREQS][4] =
{
//   Hz     div     us      step
    {1,     10,     4000,   1},     // 0
    {5,     10,     800,    1},     // 1
    {1,     1,      400,    1},     // 2
    {5,     1,      80,     1},     // 3
    {10,    1,      40,     1},     // 4
    {50,    1,      8,      1},     // 5
    {100,   1,      4,      1},     // 6
    {500,   1,      4,      5},     // 7
    {1000,  1,      4,      10},    // 8
    {5000,  1,      4,      50},    // 9
    {10000, 1,      4,      100}    // 10
};


// Generated using Dr LUT - Free Lookup Table Generator
// https://github.com/ppelikan/drlut
#define SINE_LUT_LENGTH 2500
#define SAW_LUT_LENGTH 2500

static const uint16_t SINE_LUT[SINE_LUT_LENGTH] = {
    0x7FFF,0x8051,0x80A4,0x80F6,0x8148,0x819B,0x81ED,
    0x823F,0x8292,0x82E4,0x8336,0x8389,0x83DB,0x842D,
    0x8480,0x84D2,0x8524,0x8577,0x85C9,0x861B,0x866D,
    0x86C0,0x8712,0x8764,0x87B6,0x8808,0x885B,0x88AD,
    0x88FF,0x8951,0x89A3,0x89F5,0x8A47,0x8A9A,0x8AEC,
    0x8B3E,0x8B90,0x8BE2,0x8C34,0x8C86,0x8CD8,0x8D29,
    0x8D7B,0x8DCD,0x8E1F,0x8E71,0x8EC3,0x8F15,0x8F66,
    0x8FB8,0x900A,0x905B,0x90AD,0x90FF,0x9150,0x91A2,
    0x91F4,0x9245,0x9297,0x92E8,0x9339,0x938B,0x93DC,
    0x942E,0x947F,0x94D0,0x9521,0x9573,0x95C4,0x9615,
    0x9666,0x96B7,0x9708,0x9759,0x97AA,0x97FB,0x984C,
    0x989D,0x98ED,0x993E,0x998F,0x99E0,0x9A30,0x9A81,
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
    0x1916,0x1931,0x194B,0x1965,0x197F,0x1999,0x19B4,
    0x19CE,0x19E8,0x1A02,0x1A1C,0x1A37,0x1A51,0x1A6B,
    0x1A85,0x1AA0,0x1ABA,0x1AD4,0x1AEE,0x1B08,0x1B23,
    0x1B3D,0x1B57,0x1B71,0x1B8B,0x1BA6,0x1BC0,0x1BDA,
    0x1BF4,0x1C0F,0x1C29,0x1C43,0x1C5D,0x1C77,0x1C92,
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
