open-ephys/ephys-test-board/firmware/ephys-tester.h

#pragma once

#include "pico/stdlib.h"

// Firmware version
#define VERSION_MAJOR       1
#define VERSION_MINOR       0
#define VERSION_PATCH       0

// Operating voltage
#define VCC_VOLTAGE         3.0f

// Pin definitions
#define MODULE_I2C          i2c1
#define MODULE_SDA          2
#define MODULE_SCL          3
#define MODULE_DETECT       5

#define VBUS_DETECT         4

#define DAC_PIO             pio0
#define DAC_MOSI            7
#define DAC_nCS             9
#define DAC_SCLK            10
#define DAC_nLDAC           11

#define SR_nSRCLR           12
#define SR_SRCLK            13
#define SR_RCLK             14
#define SR_SER              15

#define nEXT_SEL            16
#define nDAC_SEL            17

#define OLED_PWR            19

#define BATT_MON_EN         20

#define ENC_PIO             pio1
#define ENC_A               21
#define ENC_B               22
#define ENC_BUT             23

#define OLED_SPI            spi1
#define OLED_nDC            24
#define OLED_nRES           25
#define OLED_SCLK           26
#define OLED_MOSI           27
#define OLED_nCS            29

#define BATT_MON_PIN        28
#define BATT_MON_ADC        2

// Screen constants
#define SCREEN_WIDTH        128
#define SCREEN_HEIGHT       64

// Signal constants
#define DAC_MIDSCALE        32767
#define DAC_FULLSCALE       65535
#define MAX_AMPLITUDE_UV    5000.0f
#define DAC_MAX_SHIFT       10 // Max bit shift for DAC attenuation
#define SIG_MAX_AMP_SCALE   20.0f   // Maximum scale multiplier (displayed as 100.0f * scale, max = 2000%)

// Dac clipping stated
typedef enum {
    CLIP_NONE = 0,
    CLIP_LOW = -1,
    CLIP_HIGH = -2,
} signal_clip_t;

// Automatic channel increment dwell time in milliseconds
#define AUTO_CHAN_SDWELL_S 1 // Used to print value
#define AUTO_CHAN_SDWELL_MS (AUTO_CHAN_SDWELL_S * 1000)  // Derive milliseconds
#define AUTO_CHAN_FDWELL_MS 100

// System monitor period in milliseconds
#define SYS_MON_PERIOD_MS   1000
#define BATT_MON_AVGS       30

// EEPROM constants (see eeprom.h for specification)
#define EEPROM_MODULE_NAME_SIZE 32
#define EEPROM_MAP_NAME_SIZE 32

// Shift register bit array
#define MAX_NUM_CHANNELS    128                                     // 128 channels max
typedef struct sr_bit_arr_t { int32_t bits[4]; } sr_bit_arr_t;
#define SR_BITS_PER_ELEMENT (8 * sizeof(int32_t))                   // Bits per array element of sr_bit_arr_t

// Stringify macro for compile-time stringification
#define STRINGIFY2(X) #X
#define STRINGIFY(X) STRINGIFY2(X)
