open-ephys/ephys-test-board/(commit log)

2024-01-03 Initial commit
    - Add proof of concept signal path verification board
    [headstage-io.kicad_sch, mcu.kicad_sch, signal-routing.kicad_sch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]
2024-01-08 Started messing around with firmware
    - Messing around with pico-sdk and thinking about how the board will operate.
    - This is just scratch code.
2024-01-29 Add results from signal-path-test board
    - The conclusion is obvious in hind-sight: attenuation must occur after
    analog switches otherwise the small noise of the signal is added to
    the attenuated signal. If attenuation occurs after the switch, this
    still occurs but the lage signal and added noise are _both_ attenuated
    and the noise from the switch is not relevant
2024-01-29 Add initial ephys test board schematic
    - Needs a display to be added
    - Needs concreate part numbers and packages
    [ephys-test-board.kicad_pcb, ephys-test-board.kicad_sch, headstage-io.kicad_sch, mcu.kicad_sch, signal-routing.kicad_sch, test-signal.kicad_sch, usb-and-battery.kicad_sch]
2024-05-21 Remove battery power option
    - This device needs user IO
    - Battery power means there would need to be a touch screen or wireless
    connection. Too complex.
    [ephys-test-board.kicad_pcb, ephys-test-board.kicad_sch, headstage-io.kicad_sch, mcu.kicad_sch, signal-routing.kicad_sch, test-signal.kicad_sch, usb-and-battery.kicad_sch]
2024-09-30 Finished schematic, started routing
    - There is a 8-channel motif that will need to be copied 16x on the
    board. I'm not sure the most efficient way to do this.
    [ephys-test-board.kicad_sch, headstage-io.kicad_sch, mcu.kicad_sch, signal-routing.kicad_sch, test-signal.kicad_sch, usb.kicad_sch]
2024-10-11 Motif is repeated
    - some components are grouped by function
    - components are roughly organized within groups
    [ephys-test-board.kicad_sch, headstage-io.kicad_sch, mcu.kicad_sch, signal-routing.kicad_sch, test-signal.kicad_sch, usb.kicad_sch]
2024-11-03 Add Cris's instructions for repeating circuit motif
    - Minor edits to markdown
2024-11-08 Manual cleanup of repeated analog input array
    - There was some manual cleanup needed
    - Overall the repeated motif worked very well
    [ephys-test-board.kicad_sch, headstage-io.kicad_sch, mcu.kicad_sch, signal-routing.kicad_sch, test-signal.kicad_sch, usb.kicad_sch]
2024-11-08 Added user IO and battery
    - Battery provides noise free operation
    - OLED display and rotary encoder are not that hard to use
    [ephys-test-board.kicad_sch, mcu.kicad_sch, usb.kicad_sch, user-io.kicad_sch]
2024-11-09 Initial Rev. A schematic
    - I think this has everything we need for revision A
    - Battery charge indication via the OLED display
    - User interface via rotary encoder/select switch
    - Cycle through affected individual channels, none, or all
    - Cycle through amplitudes
    - Cycle through frequencies
    - Select signal source
    - Cycle through pre-loaded channel maps?
    [ephys-test-board.kicad_sch, headstage-io.kicad_sch, mcu.kicad_sch, signal-routing.kicad_sch, test-signal.kicad_sch, usb.kicad_sch, user-io.kicad_sch]
2024-11-09 Add EEPROM support to headstage interface
    - I2C + Power
    [ephys-test-board.kicad_sch, headstage-io.kicad_sch, mcu.kicad_sch]
2024-11-10 More schematic improvements
    - Add pullups to i2c bus
    - Add test points
    - Ready for initial routing
    [ephys-test-board.kicad_sch, headstage-io.kicad_sch, mcu.kicad_sch, test-signal.kicad_sch, usb.kicad_sch, user-io.kicad_sch]
2024-11-11 Start routing rev. A
    [ephys-test-board.kicad_sch, headstage-io.kicad_sch, mcu.kicad_sch, signal-routing.kicad_sch, test-signal.kicad_sch, usb.kicad_sch, user-io.kicad_sch]
2024-11-12 Routing nearly complete
    - Power switch is too tall I think
    [ephys-test-board.kicad_sch, headstage-io.kicad_sch, mcu.kicad_sch, signal-routing.kicad_sch, test-signal.kicad_sch, usb.kicad_sch, user-io.kicad_sch]
2024-11-13 Rev. A of PCB
    - I will make a case before fabrication so that they can be made
    together
    [ephys-test-board-B_Cu.gbr, ephys-test-board-B_Fab.gbr, ephys-test-board-B_Mask.gbr, ephys-test-board-B_Paste.gbr, ephys-test-board-B_Silkscreen.gbr, ephys-test-board-Edge_Cuts.gbr, ephys-test-board-F_Cu.gbr, ephys-test-board-F_Fab.gbr]
2024-11-14 Created case
    - Mill aluminum
    - Moved some components for more sensical layout for the user
    - Pending final check, should be ready for initial fab
    [ACCKMR1316NLT14.stp, base.SLDPRT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]
2024-11-15 Improved manufacturability of case design
    - Quote request sent to PCBWay for this design along with the case
    [base.SLDPRT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]
2024-11-15 Update pdf of schematic
    - Additionally, add spice verification of AD5683's
    ability to drive the combined capacitive and
    resistive load presented by the AC coupling
    and attenuation networks
    [test-signal.kicad_sch]
2024-11-19 Fix MCP73831 subcircuit
    - Add decoupling capacitor on Vbat
    - Add more thermal support to layout (solid connection of ground to
    ground plane copper and addition of thermal vias)
    [ephys-test-board.kicad_sch, headstage-io.kicad_sch, mcu.kicad_sch, signal-routing.kicad_sch, test-signal.kicad_sch, usb.kicad_sch, user-io.kicad_sch]
2025-01-09 Firmware elements
    - DAC controlled via SPI on PIO for 24-bit transfers
    - Quarature decoder on PIO to alleviate CPU
    - Shift register updates for channel selection are bit banged, might
    need to move this to another PIO state machine
2025-01-22 Address several issues found when testing rev. A
    - Add Reset button to back panel
    - Make board smaller
    - Move battery to bottom of device
    - Replace OLED with a more reasonable choice.
    - Etc.
    [ephys-test-board.kicad_sch, headstage-io.kicad_sch, mcu.kicad_sch, signal-routing.kicad_sch, test-signal.kicad_sch, usb.kicad_sch, user-io.kicad_sch]
2025-02-06 Change power switch
    - Replace push button with rocker
    - Added some notches to outside of PCB for aligning with enclosure
    - Upgrade to KiCAD 9.0
    [ephys-test-board-B_Cu.gbr, ephys-test-board-B_Fab.gbr, ephys-test-board-B_Mask.gbr, ephys-test-board-B_Paste.gbr, ephys-test-board-B_SilkS.gbr, ephys-test-board-B_Silkscreen.gbr, ephys-test-board-Dwgs_User.gbr, ephys-test-board-Edge_Cuts.gbr]
2025-02-07 Revision B
    - Sent to fab
    [ephys-test-board-B_Cu.gbr, ephys-test-board-B_Fab.gbr, ephys-test-board-B_Mask.gbr, ephys-test-board-B_Paste.gbr, ephys-test-board-B_SilkS.gbr, ephys-test-board-B_Silkscreen.gbr, ephys-test-board-Dwgs_User.gbr, ephys-test-board-Edge_Cuts.gbr]
2025-02-09 Added module detect signal
    - 100k pullup to VCC next to i2c bus that can be pulled down by module
    to assert its presence
    [ephys-test-board.kicad_sch, headstage-io.kicad_sch, mcu.kicad_sch, signal-routing.kicad_sch, test-signal.kicad_sch, usb.kicad_sch, user-io.kicad_sch]
2025-02-09 Move SW4 closer to PCB edge
    - Also, correct its footprint to 5.8mm actuator length rather than 8.3
    which did not match its part number
    [headstage-io.kicad_sch, mcu.kicad_sch, signal-routing.kicad_sch, user-io.kicad_sch]
2025-02-09 Fix J4 value
    - FH12-16S-0.5SH(55) instead of FH12-24S-0.5SH(55)
    [ephys-test-board.kicad_sch, user-io.kicad_sch]
2025-02-28 Mirror connections on J4
    - The schematic presented on OLED datasheet was mirrored commpared to
    the connector's pin order. This fixes that.
    [ephys-test-board.kicad_sch, headstage-io.kicad_sch, mcu.kicad_sch, signal-routing.kicad_sch, test-signal.kicad_sch, usb.kicad_sch, user-io.kicad_sch]
2025-02-28 Decrease charge indication LED brightness
    - 1k current limiting resistor replaced with 4.7k
    [mcu.kicad_sch, usb.kicad_sch]
2025-02-28 Functional OLED firmware
    - Included modified version of Adafruit_SH110X library (BSD License)
    along with some headers from AdruinioCore-Avr (LGPL)
    - Changes were made to work with pico SDK
2025-03-12 Firmware work
    - Added mode seleciton capabilites
    - Started on channel selection, etc
    [ephys-test-board.kicad_sch]
2025-03-15 Firmware work in progress
    - Knob turns in correct direction
    - Working on incorporating waveform information into waveform generator
    [ad5683.c, channels.c, lut.h, main.cpp, mode.c, mode.h, sr.c]
2025-03-20 Firmware updates
    - Press button now cycles selection
    - Slow down quadrature PIO state machine to prevent glitching
    - Remove redundant OLED update calls
    - Code cleanup and streamlining
    [eeprom.c, main.cpp, mode.c, mode.h, quadrature.c, quadrature.h]
2025-03-20 Fix electrode coupling
    - AC coupling follows attentuation to prevent high-pass filtering
    - Remove redundant i2c pullups (can be enabled in MCU if really needed)
    - Replace detect line with WP/Detect so that this device can be used to
    program module EEPROM by pulling the line down
    [ephys-test-board.kicad_sch, headstage-io.kicad_sch, mcu.kicad_sch, signal-routing.kicad_sch]
2025-03-20 Reduce test signal attenuation
    - From -60 dbV to -54 dbV
    [ephys-test-board.kicad_sch, headstage-io.kicad_sch, mcu.kicad_sch, signal-routing.kicad_sch, test-signal.kicad_sch, usb.kicad_sch, user-io.kicad_sch]
2025-03-20 Add SC0914(13) to Part No. field of RP2040
    [mcu.kicad_sch]
2025-03-20 Correct max amplitude
    - It was 250 uV but should be 2500 uV
    [ephys-tester.h]
2025-03-21 Case for revision C of PCB
    - Will require some modifications to screen area if its to be
    machinable.
    [base.SLDPRT, base.STL, eswitch-1R-cap.SLDPRT, top.SLDPRT, top.STL]
2025-03-21 Rev. C ready for OEPS review
    [ephys-test-board-B_Cu.gbr, ephys-test-board-B_Fab.gbr, ephys-test-board-B_Mask.gbr, ephys-test-board-B_Paste.gbr, ephys-test-board-B_Silkscreen.gbr, ephys-test-board-Edge_Cuts.gbr, ephys-test-board-F_Cu.gbr, ephys-test-board-F_Fab.gbr]
2025-03-21 Add open ephys sheet to pcb design
2025-03-26 Add light pipe part to schematic.
    [mcu.kicad_sch, usb.kicad_sch]
2025-03-29 Address issues with case found during proptyping
    - Add recess for reset button
    - Add 3.5V power managment circuit and simplify on/off switch debounce
    - Increase space in bottom porition of case for thicker battery
    - Remove alignment notches from PCB -- uses features of case instead
    [base.SLDPRT, base.STL, ephys-test-board.kicad_sch, top.SLDPRT, top.STL, usb.kicad_sch]
2025-04-01 Add silkscreen design for case
    - Also, add recess for sticker on bottom of case
    - Improve case manufacturablity after testing
    [base.SLDPRT, base.STL, top.SLDPRT, top.STL]
2025-04-03 Add direct wire to board option for battery
    - Original connector is still there, but can be DNP for other battery
    choices.
    [ephys-test-board-B_Cu.gbr, ephys-test-board-B_Fab.gbr, ephys-test-board-B_Mask.gbr, ephys-test-board-B_Paste.gbr, ephys-test-board-B_Silkscreen.gbr, ephys-test-board-Edge_Cuts.gbr, ephys-test-board-F_Cu.gbr, ephys-test-board-F_Fab.gbr]
2025-04-07 Remove signal-path-test-board
    - It has been integrated into the main board
    [headstage-io.kicad_sch, mcu.kicad_sch, signal-routing.kicad_sch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]
2025-04-07 Update gerbers with latest
    - Board Rev -> Rev on silk layer
    [ephys-test-board-B_Cu.gbr, ephys-test-board-B_Fab.gbr, ephys-test-board-B_Mask.gbr, ephys-test-board-B_Paste.gbr, ephys-test-board-B_Silkscreen.gbr, ephys-test-board-Edge_Cuts.gbr, ephys-test-board-F_Cu.gbr, ephys-test-board-F_Fab.gbr]
2025-04-09 Add protention diode to USB input
    - Same part that has been verified on stimjim-hv
    [ephys-test-board-B_Cu.gbr, ephys-test-board-B_Fab.gbr, ephys-test-board-B_Mask.gbr, ephys-test-board-B_Paste.gbr, ephys-test-board-B_Silkscreen.gbr, ephys-test-board-Edge_Cuts.gbr, ephys-test-board-F_Cu.gbr, ephys-test-board-F_Fab.gbr]
2025-04-10 Fix dogbones around recess in case for sticker
    - Remove the SLDPRT that was incorrectly added to stl folder
    [base.SLDPRT, base.STL]
2025-04-15 Added OEPS PN.
    [ephys-test-board.kicad_sch, headstage-io.kicad_sch, mcu.kicad_sch, signal-routing.kicad_sch, test-signal.kicad_sch, usb.kicad_sch, user-io.kicad_sch]
2025-04-16 Minor edits during BOM review
    - Remove DNP in value fields since a dedicated channel is provided for
    that information
    - Add MP pins to header symbols
    - Update BOM and PDFs
    - New gerbers to connect mount points to headers. No component position
    changes
    [ephys-test-board-B_Cu.gbr, ephys-test-board-B_Fab.gbr, ephys-test-board-B_Mask.gbr, ephys-test-board-B_Paste.gbr, ephys-test-board-B_Silkscreen.gbr, ephys-test-board-Edge_Cuts.gbr, ephys-test-board-F_Cu.gbr, ephys-test-board-F_Fab.gbr]
2025-04-21 Add case assembly instructions
2025-04-21 Add missing case/README.md file
2025-05-21 Update case assembly README with correct screw
    - 12mm screw replaced with 15mm
    - Fixed #40
2025-07-03 Point MODULE_DETECT to the right pin
2025-07-03 Updated default frequency to 1000 Hz
2025-07-03 Fixed default frequency to 1000 Hz
    [lut.h]
2025-07-03 Add bypass for battery protection circuit
    - Mark battery protection circuit as DNP
    - Add 0-Ohm jumper from negative battery terminal to ground
    [usb.kicad_sch]
2025-07-04 Added OEPS PN to the new resistor
    [usb.kicad_sch]
2025-07-04 Propagated DNP attribute to PCB
2025-07-11 Add battery measurement circuit
    - Measure battery voltage using microcontroller's ADC
    [ephys-test-board.kicad_sch, headstage-io.kicad_sch, mcu.kicad_sch, signal-routing.kicad_sch, test-signal.kicad_sch, usb.kicad_sch, user-io.kicad_sch]
2025-07-11 Revision D
    - Sent for fabrication
    [ephys-test-board-B_Cu.gbr, ephys-test-board-B_Fab.gbr, ephys-test-board-B_Mask.gbr, ephys-test-board-B_Paste.gbr, ephys-test-board-B_Silkscreen.gbr, ephys-test-board-Edge_Cuts.gbr, ephys-test-board-F_Cu.gbr, ephys-test-board-F_Fab.gbr]
2025-07-12 Add battery monitor firmware
    - Shows battery icon with discharge status
    - Linear regime will need to be tuned once I have revision D hardware
    - Shows when USB is detected
2025-07-23 Add short channel cycle mode
    - Also add all channel active step at the start of each channel cycle
    that makes synchronization easy for automatic testing
    [channels.c, ephys-tester.h, main.cpp, mode.c, mode.h]
2025-08-13 Add schottky diode in series with VDD on U153
    - This diode is required to prevent C299 from forming a very
    long RC circuit with R264/5, which causes long turn on time for Q1 and
    long time period in triode regime, which causes VPP to droop, which
    causes U154 to issue reset and the circuit to power cycle when USB
    cable is unplugged.
    [ephys-test-board-B_Cu.gbr, ephys-test-board-B_Fab.gbr, ephys-test-board-B_Mask.gbr, ephys-test-board-B_Paste.gbr, ephys-test-board-B_Silkscreen.gbr, ephys-test-board-Edge_Cuts.gbr, ephys-test-board-F_Cu.gbr, ephys-test-board-F_Fab.gbr]
2025-09-24 Firmware improvements
    - Correction the direction of spike waveforms
    - Added 2 additional spike sequences
    - Corrected menu labels
    - Made menu selections logically dependent. e.g. amplitude and frequency
    settings are not presented with the signal source set to external
    [usb.kicad_sch]
2025-09-29 Use 1.25V reference voltage for electrode test signal
    - This prevents large AC component when channel switch occurs.
    - Previously the attenuator reference and nomimal electrode signals were
    both ground. Since the test signal is centered arround 1.25V, there
    the test signal is effectively a 1.25V square wave + the indented
    signal. The square waves edges were readily passed through the AC
    coupling capacitor.
    - Add LCSC numbers to all required components for assembly.
    [ephys-test-board-B_Cu.gbr, ephys-test-board-B_Fab.gbr, ephys-test-board-B_Mask.gbr, ephys-test-board-B_Paste.gbr, ephys-test-board-B_Silkscreen.gbr, ephys-test-board-Edge_Cuts.gbr, ephys-test-board-F_Cu.gbr, ephys-test-board-F_Fab.gbr]
2025-10-02 Updates to case for rev e
    - Remove thin walls where possible
    - Improve specification of silkscreen
    [base.SLDPRT, base.STL, top-hole-spec.SLDDRW, top.SLDPRT, top.STL]
2025-10-02 Added dedicated TESTREF pin on headstage interface
    - Also removed GND conenctions from 3 pins and marked as reserved
    [ephys-test-board-B_Cu.gbr, ephys-test-board-B_Fab.gbr, ephys-test-board-B_Mask.gbr, ephys-test-board-B_Paste.gbr, ephys-test-board-B_Silkscreen.gbr, ephys-test-board-Edge_Cuts.gbr, ephys-test-board-F_Cu.gbr, ephys-test-board-F_Fab.gbr]
2025-10-02 Dont change DC level when scaling test signal
    - Test signal was being scaled via simple bit shift, but this scaled
    thed DC offset as well, causing jumps. Now, only the AC component is
    scaled
    - Add battery status update during channel map selection
2025-11-03 Revision E
    - Sent for fabrication and assembly
    - JLC BOM and component placements added to manufacturing folder
    [ephys-test-board-B_Cu.gbr, ephys-test-board-B_Fab.gbr, ephys-test-board-B_Mask.gbr, ephys-test-board-B_Paste.gbr, ephys-test-board-B_Silkscreen.gbr, ephys-test-board-Edge_Cuts.gbr, ephys-test-board-F_Cu.gbr, ephys-test-board-F_Fab.gbr]
2026-01-06 Implmenent bipolar test signal
    - Generate internal negative rail
    - Shift DAC output by VREF/2
    - Replace analog switches with depletion mode switches to allow negative
    signals
    - DC couple electrode inputs
    [ephys-test-board.kicad_sch, headstage-io.kicad_sch, mcu.kicad_sch, signal-routing.kicad_sch, test-signal.kicad_sch, usb.kicad_sch, user-io.kicad_sch]
2026-01-13 Add M3 grounding holes
    - Screws will attach the PCB to the top portion of the case, grounding
    it. Then the 4 screws on the corners will ground the bottom of the
    case to the top.
    - Some minor changes to fab layers before PCB creation.
    [ephys-test-board-B_Cu.gbr, ephys-test-board-B_Fab.gbr, ephys-test-board-B_Mask.gbr, ephys-test-board-B_Paste.gbr, ephys-test-board-B_Silkscreen.gbr, ephys-test-board-Edge_Cuts.gbr, ephys-test-board-F_Cu.gbr, ephys-test-board-F_Fab.gbr]
2026-02-25 Update firmware for Rev. F
    - Use user specified nCS line in OLED SPI controller
    - Implement new control lines for routing test signal and enableing
    battery monitor
2026-02-25 Revision G candidate
    - Fix flipped power/ground connections on U84
    - VCC is now 3.0V
    - Address issues with parasitic voltage feedthrough on FSA533
    - Completely redesign test signal analog section with much
    improved noise, THD, etc and implicit low THD input protection on the
    external input.
    [ephys-test-board-B_Cu.gbr, ephys-test-board-B_Fab.gbr, ephys-test-board-B_Mask.gbr, ephys-test-board-B_Paste.gbr, ephys-test-board-B_Silkscreen.gbr, ephys-test-board-Edge_Cuts.gbr, ephys-test-board-F_Cu.gbr, ephys-test-board-F_Fab.gbr]
2026-02-26 Update case for PCB revision G
    - Add PCB mounting holes to top
    - Update tap positions drawing
    - Improve silkscreen text and alignment
    [91294A134_Black-Oxide Alloy Steel Hex Drive Flat Head Screw.SLDPRT, 92000A116_Passivated 18-8 Stainless Steel Pan Head Phillips Screws.SLDPRT, base.SLDPRT, base.STL, top-hole-spec.SLDDRW, top.SLDPRT, top.STL]
2026-02-26 Fix battery voltage measurment
    - Rev. G of board operates on 3.0V instead of 3.3V which is relevant for
    ADC conversion
    [battmon.c, ephys-tester.h, mode.h]
2026-03-04 Update PCB component part numbers
    Replace and fill missing MPN and OEPSPN properties.
    [headstage-io.kicad_sch, mcu.kicad_sch, signal-routing.kicad_sch, test-signal.kicad_sch, usb.kicad_sch, user-io.kicad_sch]
2026-03-04 Update BOM field visibility and sort
2026-03-04 Add PnP files
    Update ephys-test-board schematic to match the number of components in the BOM and number of lines in the PnP files.
    [ephys-test-board.kicad_sch, usb.kicad_sch]
2026-03-13 Updated OEPS PN and regenerated BOM and PnP files
    [ephys-test-board.kicad_pcb, signal-routing.kicad_sch, test-signal.kicad_sch, usb.kicad_sch]
2026-03-17 Rev. G production candidate
    - Finished LCSC part numbers
    - Generated final gerbers
    [ephys-test-board-B_Cu.gbr, ephys-test-board-B_Fab.gbr, ephys-test-board-B_Mask.gbr, ephys-test-board-B_Paste.gbr, ephys-test-board-B_Silkscreen.gbr, ephys-test-board-Edge_Cuts.gbr, ephys-test-board-F_Cu.gbr, ephys-test-board-F_Fab.gbr]
2026-03-18 Added BOM
    [ephys-test-board.csv]
2026-03-30 Minor BOM fix before production
    Update the 1k 0402 resistor footprint/PN across BOM and schematics.
    [ephys-test-board.csv, mcu.kicad_sch, test-signal.kicad_sch, user-io.kicad_sch]
2026-03-31 Rev. G firmware changes
    - Fix scaling of spikes.h look up tables. These are now 1:1 with
    physical units and can be scaled up or down.
    - Improve clipping icons
    [ad5683.c, ad5683.h, main.cpp, mode.c, mode.h, oled.cpp]
2026-04-03 Firmware bug fixes
    - Prevent possible dereference of timer_data by one core_1 while is
    being written by core_o
    - Enforce max amplitude scaling of 2000% and fix character buffers for
    printing this to OLED
    - Remove repeated 500 Hz entry in FREQ_LUT
    [ephys-tester.h, lut.h, main.cpp, mode.c, sr.h]
2026-05-03 Rev. G firmware fixes
    - DC waveform was continuing to apply whatever AC waveform was last
    selected
    - DC waveform display was messed up
    - Fix constants in lut that were not updated when I removed duplicate entry
    from the frequency table
    [lut.h, main.cpp, mode.c]
2026-07-10 Update to KiCAD v10 and fix BOM
    Updated BOM according to the design being produced.
    [ephys-test-board.csv, ephys-test-board.kicad_pcb, ephys-test-board.kicad_sch, headstage-io.kicad_sch, mcu.kicad_sch, signal-routing.kicad_sch, test-signal.kicad_sch, usb.kicad_sch]
